andres/wingcut-fluidnc/docs/audit.md

# Audit record

This package went through two independent audits before publication. The v2 audit (6x + DM542T in one steel box, 28 findings) shaped the mechanics and safety design. The v3 audit below (24 findings) covers the 4x build. All findings were applied. The current v4 layout (steel power box + printed 24 V controller box, two controller variants) was audited again before publication; that record is at the end of this file.

**ID mapping:** the v3 findings below use the old part IDs. E1 → VA1, E2/E3 → PW1/PW2, E4/E5 → PW3/PW4, E6 → PW5, E7–E9 → PW6–PW8, E10 → PW9, E11 → PW10, E12 → PW11, E13 → PW12 (now the steel power box only), E15 → PW14, E16 → PW15/VA3, E17/E18 → CC2/CC3, E20 → PW16, E21 → CC4/CC5, E22 → CC6, FX10 → PW17.

**Correction:** finding #2 below estimated the board at ≈170 × 115 mm from a wiki image. Both FluidNC 4x and 6x boards are **125 × 85 mm**, verified from Bart Dring's EasyEDA layout ([enclosure/README](../enclosure/README.md)).

## v3 audit (01, 02, YAML, wingcut TOML, bom.csv)

*2026-11-05. I did not edit 01, 02, the YAML, the TOML or bom.csv. Anything that checked out is not listed.*

**Checked and fine:**
- **4x v1.1 board.** Terminal names (TB1/TB3/TB4/TB5 motors, TB7 power, TB10 = gpio.12 / VMot / gpio.4 / VMot), the i2so pins, UART gpio.26/2, the input pins and their Gnd terminals, and the StallGuard pad order (A/Z/Y/X) all match the wiki pinout image. Inputs have external pull-ups, so NC-to-Gnd needs no attribute. The MOSFETs are low-side with flyback diodes.
- **DC60.** Terminals 1(+)/2(−) load and 3(+)/4(−) control; control range 3.5–32 V (1500 Ω, so ≈16 mA at 24 V); load 3–60 V, 0.02–7 A; t_on 0.1 / t_off 0.3 ms; the datasheet does require a fast diode on inductive loads; input/output/base isolation is 4 kV. The freewheel diode orientation is correct.
- **Mean Well.** LRS-100/150F input 85–264 VAC with no selector; adjust ranges 21.6–28.8 V and 32.4–39.6 V; output isolated from FG.
- **Arithmetic.** The wire numbers (8.7 Ω/m, 12.6 Ω, I_full ≈ 2.70 A, S table, dummy-load currents, the tension/deflection check) are correct. The BOM sections sum to $896.
- **Config files.** Every wingcut TOML key exists in `config.rs` (deny_unknown_fields). The `limits` match FluidNC's soft ranges [0, 1000] and [mpos − max_travel, mpos], and the tram sign (`z mpos_mm = +d`) is right. The YAML keys exist in FluidNC v4.1.1 (`Axes.cpp`, `Homing.h`, `Motor.cpp`, `Spindle.cpp`). wingcut's Pause really does send `!` and then `0x9E` at `Hold:0` (`machine/src/controller.rs`).
- **v2 fixes that did not regress:** #1, #5–#9 (moot without K1), #11–#13, #15–#28. The ones that did regress are #2, #10 and the v2 antenna and lid-strap rows; see findings 3, 4 and 5.

| # | Sev | File / section | Problem | Concrete fix |
|---|---|---|---|---|
| 1 | **BLOCKER** | 01 §1 "Wire-off paths", E6, §3.1, §7; YAML (no `control:`); 02 note 2, (f)4 | **Releasing the E-stop can re-heat the wire and restart motion on its own.** The E-stop only cuts AC. The docs themselves say the ESP32 may stay alive on USB power. In that case FluidNC never learns about the E-stop: gpio.4 keeps its PWM and the planner keeps "moving" with dead motors, while wingcut keeps streaming. When the operator twists the E-stop out, VMot returns: the SSR turns on (wire hot) and the job continues. The drivers have also lost their UART settings (wrong microsteps and current, see 01 §7), so the towers move to wrong positions with a hot wire. "Press RESET after every E-stop" comes too late, because the hazard is the release itself. | Use a third NC contact on the E-stop as a FluidNC E-stop input. The specified XB5AS8442 already has 1 NC built in, so with the 2× ZBE102 you already have 3 NC; for an LA38/XB2 type, order a 3-NC version or add one contact block. Wire that NC between **input gpio.33 and its Gnd** (+100 nF), with CB7 in its own sleeve, not in the mains spiral. YAML, add: `control:` / `  estop_pin: gpio.33` (no attribute: closed = low = OK, pressed or a broken wire = active). In FluidNC v4.1.1 `estop_pin` gives a hard stop plus a critical alarm that only a soft reset clears, and with `off_on_alarm: true` it also switches the spindle (wire) off ([Control.cpp](https://github.com/bdring/FluidNC/blob/v4.1.1/FluidNC/src/Control.cpp)). wingcut sees the alarm and stops the job. In 01 §3.1, replace "Leave empty: inputs gpio.32/33" with the new row. **New test (01 6.3, 02 (e)3):** with the dummy load at `M3 S500` and a jog running, press the E-stop, then release it. Expected: 0 A stays, no motion, state `Alarm`, and nothing moves until RESET → `$MI` → `$H`. |
| 2 | **MAJOR** | 01 E13, §5.1 ("fits with ~20 mm margins") | **The parts don't fit a 360 × 260 plate.** I scaled the board from the wiki pinout image (5.08 mm motor terminals ≈ 190 px), which gives **≈170 × 115 mm**. The vertical stack is then 97 mm (PSUs) + ≈50 mm (DIN rail, terminals, fuse holders) + ≈115 mm (board) ≈ 262 mm. That already exceeds 260 mm with zero wiring gaps; you need ≥25 mm in front of the PSU and motor terminals. The same failure was v2 audit #2. | Change E13 to **steel enclosure 400 × 400 × 200 mm (or 500 × 400 × 200) with mounting plate ≈ 360 × 360**, ≈ $55–70, and update the csv, 2.9 and §0. In §5.1, drop "fits with ~20 mm margins" and put the 4x board's **input edge** toward the DIN rail, with ≥30 mm free in front of every terminal row. Measure the actual board before buying the box. |
| 3 | **MAJOR** | 01 §2.1, §3.1, §5.1 walls, §2.12; 02 (a)1, (a)4 | **The antenna is missing.** The wiki says: "You should only operate when the antenna is connected. A missing antenna can cause the device to overheat." The v1.1 module has a U.FL socket. In a steel box (E13 allows steel) an antenna inside gives no Wi-Fi, yet 02 (a)4 uploads the YAML over the WebUI, i.e. over Wi-Fi. v2 had an antenna bulkhead row; v3 dropped it (regression). | Add to §3.1: "**Antenna (U.FL)** → included bulkhead cable → SMA bulkhead in the top wall, antenna outside. Never power up without it." Add to §5.1 Walls: "SMA bulkhead (Ø6.5 mm hole) top wall". Add to the BOM: "E22 U.FL→SMA bulkhead pigtail + 2.4 GHz antenna (usually included with the board; else ≈$4)". In 02 (a)4 add a fallback: "No Wi-Fi? Upload the YAML over USB with the installer's file manager (installer.fluidnc.com → Files)." |
| 4 | **MAJOR** | 01 E15, §3.2 PE rows | **Not enough PE terminals (v2 #10 regressed).** PE conductors: inlet, PSU1 FG, PSU2 FG, plate, enclosure body, lid, frame bond, 4 motor shields and 4 limit shields = **15**. E15 has **4 PE terminals** (≈8 clamp points), so you would have to double up conductors under protective-earth clamps. | Change E15 to "**12-way PE busbar on the plate** (or 10 PE terminals) + 20 feed-through terminals". One PE conductor per clamp point. |
| 5 | **MAJOR** | 01 §3.2 ("PE → Enclosure (if metal) + plate"), CB8 | **There is no PE bond to a metal lid.** The lid carries mains (E-stop) and the meter loop. v2 had "lid (strap)"; v3 lost it. A chafed mains core on an unbonded steel lid makes the lid live. | Add the row "PE stud on body → **PE strap 1.5 mm² GN/YE to the lid stud**, serrated washers both ends" (most steel boxes include it; else +$2, CB8 + 2 ring lugs). Add "Inlet PE ↔ lid < 0.5 Ω" to test 6.1. |
| 6 | **MAJOR** | 01 §2.8 P1/P4, §4.4 step 13, §4.8 step 24 | **The belt tab, belt and drag chain fight for the same space.** P1's outboard edge is **110 mm** from the rail centre, but the belt plane is "10–15 mm outboard of the beam", i.e. **20–25 mm** from the rail centre. A 30×30 angle on P1's outboard edge cannot reach a belt ≈85 mm further in. The chain is also "fixed on the X-beam outer face, loop horizontal". A 10×20 chain lying horizontally is ≈28 mm tall and its loop ≈90 mm wide, so it sits exactly where the belt runs and the chord motor (on B1, beside the beam) stands. | Draw one full-size section through the X-beam and fix: (a) **P4 under P1 at the belt line** (≈20–25 mm outboard of the rail centre), hanging ≈20 mm to the top run, not "on P1's outboard edge". (b) **Chain outboard of the belt and motor:** fixed end on a standoff (e.g. 2× M5 + 30 mm spacers, or a 2020 offcut) ≥80 mm out from the beam face, with the moving end on P1's outboard edge (that is what P1's 110 mm is for). Add the standoff parts to the BOM. In §4.6, make the chord stop "P4 hits the pulley" rather than "the motor bracket". |
| 7 | **MAJOR** | 01 E13 ("ABS or steel"), §2.10 #2 (plywood box) | **Fire: mains PSUs, an SSR and a 100 W resistor in a combustible box,** right next to polystyrene. Plain ABS is not flame-retardant, and plywood is fuel. The saving is $20. | Change E13 to "**steel**, or plastic rated UL94 V-0". Delete §2.10 #2 and change the tight variant to ≈$835. |
| 8 | **MAJOR** | 02 (e)2, (f)6; 01 6.3 step 3 | **Some tests mean working inside a live box next to mains.** 02 (e)2 takes the lead off SSR 3(+) without saying "power off" (01 6.3 does say it). 02 (f)6 has you "pull the SSR 3(+) lead" during an air cut with the wire hot. 6.3 step 3 has you "pull a limit wire". | 02 (e)2: "**Power off**, lift SSR 3(+), insulate it, power on, `M3 S1000` → 0 A. Power off, reconnect." 02 (f)6, break test: "During the air cut, lower **V-set on the Riden front panel to 10 V**. The current falls to ≈0.8 A, below 50 % of 2.15 A, and wingcut must pause within ≈1 s and switch the output off." 6.3 step 3: "**press the limit switch by hand**" (it gives the same ALARM:1). |
| 9 | MINOR | 01 E10, §1 F3; bom.csv E10 | **F3 is an ATO blade fuse, and those are rated 32 VDC** ([Littelfuse 287 ATO](https://littelfuse.com/products/fuses/automotive-aftermarket-products/blade-fuses/ato.aspx)). It sits in a 36 V circuit (trim up to 39.6 V; up to ≈43 V on the Riden output). F2 (24 V) is fine. | F3 = **5×20 mm T4 A 250 V in an inline 5×20 holder** (≈$2; same spares as F1). Keep ATO only for F2. |
| 10 | MINOR | 01 E8, §1 F1 | **T2 A (230 V) / T4 A (115 V) is below the PSUs' combined rated input.** Typical full-load input is LRS-100 1.2 A/230 V and 1.9 A/115 V, plus LRS-150F 1.7 A/230 V and 3 A/115 V = **2.9 A / 4.9 A** ([LRS-100](https://www.meanwell.com/Upload/PDF/LRS-100/LRS-100-SPEC.PDF), [LRS-150F](https://www.meanwell.com/Upload/PDF/LRS-150F/LRS-150F-SPEC.PDF)). It holds at today's ≈60 % load but leaves no margin for the Riden option, a shorter wire, or two cold-start inrushes (50 A + 60 A typ) every time the E-stop is released. | **T3.15 A (230 V) / T6.3 A (115 V)**. Both are still below the 10 A inlet and the 1.0 mm² wiring. |
| 11 | MINOR | 02 notes 3–4; 01 §2.10 #5 | **02 notes 3–4 are left over from v2:** note 3 treats the DC60S3 as the fitted part (01 specifies the DC60S7), and note 4 says "meter not dark after M5 → E-stop". In v3 PSU2 is always on, so the meter is never dark. The check is "**0.00 A** after M5". Also, §2.10 #5 removes the meter in the tight version, and that removes the only idle indication of a shorted SSR (01 §7). | Note 3: "DC60S7 fitted: 2.7 A vs 7 A, heatsink still required." Note 4: "Meter not **0.00 A** within 1 s of M5 → E-stop, replace the SSR." In §2.10 #5, keep the $7 meter and drop only the dummy load (−$8). |
| 12 | MINOR | 01 §3.1 "VMot (9–30 V)" | The wiki gives TMC2209 **max 29 V** and recommends running 10–15 % below it, at 12–24 V. LRS-100-24 trims up to 28.8 V. | "VMot + / GND: **24.0 V; never above 26 V** (TMC2209 max 29 V)." Add to 6.2 step 1: "Do not touch PSU1's trim beyond 24.0 V." |
| 13 | MINOR | 01 §5.1, E14; YAML `run_amps: 1.2` | **The fan placement contradicts itself.** It is a wall fan "exhaust high" and must also "aim across the driver heatsinks" on a board in the bottom band. 1.2 A is exactly the wiki's "needs forced air" threshold, and the loads are < 1 N. | Mount the fan **on the plate on a bracket (or on the bottom wall) blowing onto the drivers**, with the vent grill high. Set `run_amps: 1.000` on all four axes; raise it only if (b)5 loses steps. |
| 14 | MINOR | 01 CB9, CB1 | **TRVVP 4×0.5 shielded is ≈6–6.5 mm OD,** and shielded PVC chain cable is rated at **7.5–10 × OD** moving ([IEWC](https://media.iewc.com/SpecificationSheets/32009503.pdf), [Helukabel](https://www.helukabel.com.vn/vn-en/meaning-of-bending-radius.html)), i.e. ≈48–65 mm. The chain is R38. | CB9: "**Drag chain 15×20 mm inner, R48 (or larger), openable, 1 m**". Check the seller's TRVVP bend radius. |
| 15 | MINOR | 01 E16, E21 | **The glands are short and the wrong size.** 12 M16 are needed exactly (11 field cables + USB), with no spare and no Riden USB. The single-core leads (CB3 silicone ≈2.6 mm, CB8 ≈3.2 mm) are below an M16's 4.5–10 mm clamp range, so they get no seal and no strain relief. The USB-A plug does not pass an M16 gland, and the "split grommet" is not in the BOM. | E16: "**8× M16 (4.5–10 mm)** for CB1/CB2, **4× M12 (3–6.5 mm)** for W-HR, W-HT, PE + spare, +2 spare M16". E21: "**USB-C panel-mount extension 0.3 m** (bulkhead) + the 2–3 m cable" (+$6). Riden option: + 1 USB bulkhead. |
| 16 | MINOR | 01 FR5, FR6 | **Brackets and T-nuts are short.** FR5 = 20, but 8 + 8 + 4 = 20 are used **plus 2 for P6**, so "from the spares" means zero spares. 2040 cast brackets take 4 T-nuts each: 22 × 4 = 88, plus motor and idler brackets 8, P5 4, chain ends 4, bonds and tie mounts ≈10 ≈ **114 > 100**. | FR5 → **24**, FR6 → **150**. |
| 17 | MINOR | 01 P6, §4.3 step 9 | **P6 "spare corner bracket" can't carry the KFL08 at 32–36 mm.** A 2040 cast bracket leg is ≈40 mm with a central rib exactly where the Ø8 screw must pass; the KFL08 flange reaches ≈48 mm from the post face. Step 9's "≈1 mm gap between the coupler and the bearing" is meaningless: they are ≈400 mm apart. | P6 = **6 mm plate 70 × 60 (same as P3)**, fixed with 2 corner brackets; ST2 → 6 plates. Step 9: "≈1 mm gap between the motor shaft end and the screw end inside the coupler". |
| 18 | MINOR | 01 §4.7 step 21, ST3/ST4 | **The bed fixing has no parts.** "Screw from below" through a 2040 isn't possible, and there are no brackets or wood screws in the BOM. ST3 (100 mm for 2× 50) and ST4 (120 mm for 4× 30) have no saw-kerf allowance. | Step 21: "8× **M5×25 countersunk DIN 7991** down through the bed into M5 T-nuts in C1/C2, heads 1 mm below the surface" (add to FX). ST3 → 120 mm, ST4 → 150 mm. |
| 19 | MINOR | 01 §2.6 / BOM (enclosure hardware) | **Enclosure hardware used in §5 is not in the BOM.** Fan screws (M4×35 + nuts, ×4); DIN-rail screws (×3); SSR→heatsink and heatsink→plate screws (M4 ×4); E12 dummy-load screws (M4 ×2); PE stud nuts + serrated washers; IEC inlet screws (if not snap-in). | Add **FX10: enclosure kit**: 4× M4×35, 10× M4×10, 14× M4 nuts, 6 serrated washers M4/M5 (≈$3). |
| 20 | MINOR | 01 §4.9 / 6.1 PE row, CB8, CB12 | **The PE test can't always be fixed the way it says.** "< 1 Ω to both P2, else add a CB8 jumper across that joint" won't work: P1 and P2 ride on linear-guide balls, and a static jumper can't cross a 1000 mm or 300 mm stroke. CB8 has only 4 lugs. | Change the text to: "Jumper each **rail ↔ extrusion** (static; M3 ring lug under a rail screw + serrated washer). If P1/P2 still read > 1 Ω, run a **0.5 mm² GN/YE flexible core** in each drag chain to P1, with a short loop to P2." Add 4 m of 0.5 mm² GN/YE and 10 M3 ring lugs to the BOM. |
| 21 | MINOR | 01 6.3, §5.1; 02 (e)1 | **The dummy-load hookup isn't described,** and the docs disagree on where it goes ("beside the SSR" in 01, "on the heatsink" in 02). The wire leads end at the heads, 3–5 m away, and there is no plug in the base build. At S1000, 22 Ω takes ≈55 W; on the ≤3 K/W SSR sink that would cook the SSR. | "Power off. Lift W-HR from wire+ and W-HT from SSR 1, insulate them. Connect E12 between **wire+ and SSR 1** with 2× 0.3 m 1.0 mm² orange + M4 ring lugs. E12 is screwed to the **plate**, not the SSR heatsink. S1000 ≤ 10 s, S500 ≤ 60 s." |
| 22 | MINOR | 01 §3.2 Riden row, §6.3, §7; 02 (e)5; TOML `[riden]` | **The Riden option is inconsistent.** §7 says `max_voltage` ≈ 45 V; 02 and the TOML say 36 V. The start current is 1.8–2.0 A in 01, 2.0–2.3 A in 02 and 2.15 in the TOML. "Output − → (meter removed) SSR loop return" is vague. The RD6006's power-on-output setting isn't mentioned (if ON, its output comes back on after an E-stop). The Riden USB cable and gland aren't in the BOM (R1–R4). | §7: "`max_voltage` = **36 V**". Use one range everywhere: "**start 2.0 A, tune 2.0–2.3 A**". 3.2: "RD6006 out + → F3 → wire+; **RD6006 out − → SSR 2 (−)**". 02 (e)5: "Riden menu: **power-on output OFF**". Add R5 "USB-A↔(RD6006 port) cable 1 m + USB bulkhead, ≈$6". |
| 23 | MINOR | 02 (b)3, (c)3; 01 6.2 step 4 / 6.3 step 4 | **Three procedure gaps.** (b)3 says "put `:low` on `direction_pin`, `$CD=…`" but never says how to change it. (c)3 measures the "wire-contact point" before any wire is strung (stringing is 4.9, after 6.3). 6.3 step 4 (wingcut Pause test) comes before 02 (f), where wingcut is set up. | (b)3: "`$/axes/x/motor0/tmc_2209/direction_pin=i2so.1:low`, then `$CD=fluidnc-4x-hotwire.yaml`, `$Bye`." (c)3: "the **bottom of each MIG-tip bore**". 6.3 step 4: "do this in 02 (f)3". |
| 24 | MINOR | 01 §0, §2.9, E6; README | **The cost is undercounted.** (1) E6 at $15 is realistic only for a generic LA38/XB2. A genuine **XB5AS8442 is ≈$68–92, plus ZBE102 ≈$12–16 each** ([Octopart](https://octopart.com/part/schneider-electric/XB5AS8442), [DigiKey ZBE102](https://www.digikey.co.uk/en/products/detail/schneider-electric/ZBE102/16614613)). (2) The README says ≈$885; 01 says $895/896. (3) The fixes above add ≈$50–70: bigger steel box, PE busbar, glands and USB bulkhead, brackets and T-nuts, enclosure hardware, R48 chain, 5×20 F3. (4) Shipping is excluded, but 1.9 m extrusions alone typically add $30–60 and a multi-seller order $80–150. | E6: "**generic 3-NC XB2/LA38, ≈$15**; genuine Schneider ≈$100". Restate the base as "**≈ $950 + shipping (≈ $1,030 with a genuine Schneider E-stop)**" in §0, 2.9, the csv and the README. The "Was ~$600 a miscalculation?" answer still holds: the gap is even larger. |

**Count: 1 BLOCKER · 7 MAJOR · 16 MINOR.**

Sources: [FluidNC 4x wiki](http://wiki.fluidnc.com/en/hardware/official/new-page/4x_CNC_with_esp32) (pinout `/hardware/4x_with_pinout.png`, 29 V max, 1.2 A forced-air limit, antenna warning, MOSFET section) · [FluidNC v4.1.1 Control.cpp](https://github.com/bdring/FluidNC/blob/v4.1.1/FluidNC/src/Control.cpp) (`estop_pin`) · [Crydom DC60](https://jinzon.url.tw/pdf/crydom_dc60.pdf) · [LRS-100](https://www.meanwell.com/Upload/PDF/LRS-100/LRS-100-SPEC.PDF) · [LRS-150F](https://www.meanwell.com/Upload/PDF/LRS-150F/LRS-150F-SPEC.PDF) · [Littelfuse ATO 287 (32 V)](https://littelfuse.com/products/fuses/automotive-aftermarket-products/blade-fuses/ato.aspx) · [Elecrow 4x listing](https://www.elecrow.com/4x-cnc-controller-integrated-esp32-and-tmc2209.html) (out of stock 2026-11-05) · wingcut `src/config.rs`, `machine/src/controller.rs`, `machine/src/riden.rs`.

---
**Status (parent, 2026-11-05):** all 24 findings applied to 01, 02, the YAML, the TOML, bom.csv and the README. Base cost restated as ≈ $958 + shipping.

---

## v4 audit (pre-publication, staged repo)

*2026-11-05. Independent review of `this repo` (README, docs/, config/, bom/bom.csv, enclosure/). I edited nothing. Things that checked out are not listed. A short list of what was checked is at the end.*

| # | Sev | File / section | Problem | Concrete fix |
|---|---|---|---|---|
| 1 | **MAJOR** | 01 §5.2 ("bolt … to B1 at the front-left"), §3.4; enclosure/README §2 "Mounting", §6.7; `enclosure_lib.scad` `rail_tab`; FR BOM | **The printed boxes can't be bolted to B1 as written.** Each box has one floor-level tab at the front and one at the back. Each tab has 2 M5 slots 20 mm apart along the box X axis. That only fits a 2040 **lying flat (40 mm face up) and running front-to-back under the box**. B1 is a 2040 **standing** (FR1: "40 tall"), so its top is the 20 mm face with **one** slot, and it runs **left-right**. No front-to-back flat 2040 exists anywhere in the frame or BOM. Variant B also needs ≈207 + 40 + 204 ≈ **451 mm** of rail for "case and rack on the same rail, one after the other". | Add a BOM line FR11: "2040 offcut, 250 mm (A) / 480 mm (B), lying flat, + 2 cast corner brackets + 4 T-nuts". Then either say where it bolts (see #2), or change `rail_tab` to a single slot centred on a 20 mm face. State the mounting rail in 01 §5.2 and enclosure §6.7 in one sentence each. |
| 2 | **MAJOR** | 01 §0 top view, §3.4 ("≈0.3 m from the root tower"), §4.7 step 23 | **The documented position puts the PETG box under the hot wire, with ≈9 mm clearance.** There is no room for a 206 mm box on B1 outboard of the root X-beam: the beam sits ≈160 mm from B1's end, and the chord motor bracket stands there. So "0.3 m from the root tower" means inboard, inside the wire span (\|W\| < 725 mm). The front of the chord travel (X0) is over B1. Heights: box top = B1 40 + 61 = **101 mm**. Lowest wire = bed 98 + `limits.y` min 12 = **110 mm**, and wingcut drops Y/A to entry height in front of the block first (wingcut README "Placement conventions"). The 4x lid fan also pulls air in through the lid grille, so it draws the wire's fumes and hot air straight into the electronics. | Mount both boxes **outside the wire span**: on the bench beside the power box, or on a bracket outboard of the root tower below bed height. Then update 3.4 lengths (W-MX/W-LX etc.) and CB1/CB2 metres. Add to 4.7 step 23: "lowest wire ≥ 30 mm above every box and gland over X 0–1000". |
| 3 | **MAJOR** | 01 §3.2 (B: "rack WAGO, then jumper to 6x VMot+"), §3.3B row 1 and shield row, §5.2 step 1; enclosure/README §3 rack table; `dm542t_rack.scad` `features`; VB5, VB7 | **Variant B: there is no way to get 24 V and the shield link from the rack to the 6x.** The rack has exactly 5× M16 (4 MOT + one "24V" for PB-24 *in*) and 4× M12 (SD X–A). The jumper pair to the 6x VMot has no exit. VB5 is also loose 1.0 mm² single cores, which don't seal in a 4.5–10 mm M16. The "0.5 mm² drain inside a step/dir cable (spare core…)" doesn't exist either: VB4 is 4-core and all 4 cores are used (STEP, DIR, EN, GND). | Add a 2nd M16 "24V OUT" to the rack back wall in `dm542t_rack.scad` (e.g. s = 25), add 1 M16 to VB7 (→ 21), and use 0.5 m of CB16 2×1.0 sheathed cable for the rack → 6x case "24V" gland (CB16 → 3.5 m). For the shield link, say explicitly: "use the shield of the SD X cable as the link: rack end on the rack shield WAGO, case end on the case WAGO". Drop "spare core". |
| 4 | **MAJOR** | CC9 (qty 3), 01 §3.2/§3.3A/§3.3B/§5.2 step 5, enclosure §6.5 | **Too few WAGO 221-415s, and each one takes only 5 conductors** ([WAGO 221-415](https://www.wago.com/global/pd/221-415)). **A:** the case has 4 motor + 4 limit + PB-SIG = 9 shield drains, but the docs say "a WAGO 221". **B:** case 4 limit + PB-SIG + rack link = 6. Rack motor shields 4 + link = 5. The rack's +24 V and 0 V buses each take PB-24 + 4 drivers + 6x feed + rack fan = 7. That makes ≈7 WAGOs for B, against 3 in the BOM (and CC9 doesn't list a rack shield WAGO at all). | CC9 → **A: 3**, **B: 7** (or split CC9 into VA/VB lines), ≈$1 each. In 3.3A/5.2 write "shield WAGOs (2–3, linked with a 0.5 mm² GN/YE jumper)". In 3.3B add "rack: 1 shield WAGO; +24 V and 0 V buses = 2 linked WAGOs each". Alternative: a 10-way earth bar for the drains. |
| 5 | **MAJOR** | PW5, 01 §8 "False E-stop alarms", 3.3A gpio.33 row | **Variant A: NC3 doesn't carry ≈12 mA.** That figure is the 6x opto input (YAML: 5 V → 300 Ω). The 4x inputs are plain inputs with external pull-ups, where "the switch should never put more than 5V on the terminal" ([4x wiki](http://wiki.fluidnc.com/en/hardware/official/new-page/4x_CNC_with_esp32)). So NC3 switches well under 1 mA. That is dry-circuit level, the same reason the BOM insists on gold D2F limits. A silver XB2/LA38 block will then give intermittent estop alarms, i.e. hard stops mid-cut on the recommended variant. | PW5: "NC3 **must** be a gold / low-level contact block for variant A (check the block's datasheet for ≤5 V/1 mA operation). Silver is acceptable only on B (≈12 mA opto)." Fix the "≈12 mA" text in PW5 and §8 to give the current per variant. |
| 6 | **MAJOR** | 01 §1, §3.1 ("0 V out … Never bonded to PE"), §3.2, §5.1, §6.1 | **The 24 V system floats, and one of its circuits is NC3, which sits in the same E-stop operator as the L and N contacts on the mains lid.** Generic 3-NC blocks give basic insulation between contact elements, not the protective separation SELV needs. After one insulation fault, the whole floating 24 V system, including the touchable metal USB-C bulkhead (CC4) and SMA shells on the printed case, could sit at mains potential with nothing to trip. The PB-SIG and PB-24 cores also run through the mains box, and the docs give no segregation rule for them. | Make the 24 V system **PELV**: one 1.0 mm² GN/YE from the **0 V out** terminal to the PE busbar, at the power box only. The USB isolator still breaks the PC ground loop, and PSU2 −V stays floating. Change §3.1 "Never bonded to PE" → "bonded to PE at this one point". Change 6.1: "0 V ↔ PE < 0.5 Ω; PSU2 −V ↔ 0 V/PE OL". Add to 5.1: "24 V/SIG cores run apart from mains cores and are tied to the low-voltage side; NC3 on its own contact block, furthest from NC1/NC2". |
| 7 | MINOR | CC8 (≈0.4 kg), §2.11 | **Filament is under-counted for B.** Solid volume from the STLs: 4x case 335 cm³ (≈0.40 kg PETG at 1.27 g/cm³, 3 mm walls at 4 perimeters ≈ solid). 6x case + rack = 742 cm³ (≈**0.9 kg**). | CC8: "A 0.5 kg, B 1 kg (one spool)". Move the B part into VB (+≈$8). Update the B total (≈ $1,110). |
| 8 | MINOR | 01 §0 cost table, §2.4 ("Riden option +≈$82"); bom.csv R1–R5 | The csv nets **+$75** (65 + 12 + 0 + 5 − 7). 01 says +82 while also saying "drop PW10". The RD6006 also has **no mounting place**: there's no lid cut-out or plate position in 5.1. The R4 gland can't pass a USB-A plug (≈16 mm overmould > M16 bore). | Write "+$75 net (+$82 before dropping PW10)". Add to 5.1: "Riden option: RD6006 in a lid cut-out (≈ its front-panel size; check the module's drawing)". R4: "pass the device end in from outside, or use a split USB grommet". |
| 9 | MINOR | 01 §1 ("variant A on USB power"), §6.3 step 4 (A expected result), 02 note 2 and (f)4 vs CC1 and §8 ("isolated USB port can't power it") | **The docs contradict each other on whether the 4x survives an E-stop on USB.** With the ADuM3160 in place, the board may stay alive (if the isolator's iso-5 V carries the ESP32), brown out, or reboot. 6.3 step 4 accepts only "state Alarm". 02 (f)4 isn't marked as A-only. | In 6.3 step 4 and 02 (f)4, accept both results for A: "Alarm (estop) **or** new banner + ALARM:14; in both cases RESET → `$MI` → `$H`". Change §1 to "if the board stays alive (some isolators can carry the ESP32)". Mark (f)4 "A; for B see 02b". |
| 10 | MINOR | README Build order steps 6–9; 01 §6.2 step 3, §6.3; 02 (e)1–4, (e)6, (f) | **The order sends a first-time builder through all of 02 at step 6.** That includes (e)4 (needs the strung wire, README step 8), (e)6 kerf and (f) (need wingcut, step 9). It also runs the dummy-load tests twice, with different instructions: 01 6.3 step 2 lifts PB-SIG core 2 at SSR 4, while 02 (e)2 lifts SSR 3(+). 01 gives S200 ≈ 0.33 A, 02 gives 0.31 A. | README step 6: "02 (a)–(d) (B: also 02b)". Step 7: "01 §6.3 (= 02 (e)1–3)". After step 9: "02 (e)4–6 and (f)". Replace 02 (e)1–3 with "see 01 §6.3" so only one version exists. |
| 11 | MINOR | docs/audit.md intro; README "Status"; enclosure/README §1 ("The earlier estimate in 01/03") | audit.md says the v4 layout "was audited again; see the end of this file", but there is no v4 section. Its findings also cite IDs that no longer exist (E6, E10, E13, E15, E16, E21, FX10). "01/03" points to a document not in the repo. | Append the v4 audit (this file) or delete that sentence. Add one line: "IDs below are v3 IDs (E13 → PW12, E15 → PW14, …)". Change "01/03" → "earlier drafts". |
| 12 | MINOR | enclosure/README §3 4x table SIG row; VA3; VB7; 01 §3.2 PB-SIG | **The SIG cable spec disagrees.** The enclosure README says "4 × 0.25 shielded, ≈5 mm OD", needing a 3–6.5 mm insert. PB-SIG is actually CB1 TRVVP 4×0.5 shielded, ≈6–6.5 mm OD (audit v3 #14). That is at the very top of a 3–6.5 insert, while a standard 4.5–10 M16 (as PW15 uses at the power-box end) fits it. | Enclosure §3, VA3, VB7: "SIG = CB1 4×0.5 shielded (≈6.5 mm), standard M16 4.5–10". Drop the reduced insert (or keep it only for a thinner cable). |
| 13 | MINOR | PW15 (3× M12 3–6.5 for W-HR, W-HT, PE) | 1.0 mm² (18 AWG) silicone single core is typically ≈2.3–2.6 mm OD, below the 3 mm minimum of a 3–6.5 M12. W-HR and W-HT get no seal and no strain relief, and they are the leads that get pulled by the moving towers. | PW15: "2× M12 **2–5 mm** (W-HR, W-HT) + 1× M12 3–6.5 (PE)", or "sleeve each lead with 10 cm of adhesive heat-shrink at the gland". |
| 14 | MINOR | CB16 ("H05VV-F or silicone pair", "+ red/brown, − black/blue"); 01 §6.2 step 0 ("red (+) to black (−)") | H05VV-F 2-core is **brown/blue**, but the polarity check, the one step that protects the unprotected boards, is written in red/black. Also a mains-type grey cable carrying 24 V is easy to confuse with mains in the power box. | 6.2 step 0: "+24.0 V on the core landed on **+24 V out** (brown if H05VV-F)". Better: specify red/black 2×1.0 PVC/silicone DC cable for CB16 and label both ends "24 V DC". |
| 15 | MINOR | CB8 (1.5 mm² GN/YE 3 m) | The PE run alone is "2–3 m" (3.4), plus the lid strap ≈0.3 m, plus the static frame jumpers (B1↔B2↔X-beams↔posts, 6.1). 3 m is short. | CB8: 1.5 mm² **5 m**. State which size the static frame jumpers use (1.5 mm²). |
| 16 | MINOR | CC1/CC5 | "Boxed inline type with USB-A in/out" plus "short USB-A cable PC ↔ isolator" implies a USB-A male–male cable if the input is a female socket. That is non-standard and commonly a charge-only part. | CC1: "USB-B or USB-A **male** upstream, USB-A female downstream", and match CC5 to it ("USB-A↔USB-B 0.5 m"). |
| 17 | MINOR | `config/fluidnc-4x-hotwire.yaml` header line 22; `controller_case_6x.scad` SIG comment; YAML `name`/`meta` "GUAV v3"; TOML header | **Stale comments.** The 4x YAML lists "Spare: inputs gpio.32, **gpio.33**", but gpio.33 is now `estop_pin`. The 6x scad says "E-stop NC3 (**io.33**)", but it is io.39 (io.33 is the X limit). The TOML calls itself "(FluidNC 4x board + on-board TMC2209)", but it serves both variants. | Fix the three comments. Rename to "v4" or drop the version. TOML: "FluidNC 4x or 6x; same file for both variants". |
| 18 | MINOR | VB2 ("20–50 VDC") vs 02b ("18–50 V range") | The DM542T V4.0 manual says **18–50 VDC** ([manual](https://forum.duet3d.com/assets/uploads/files/1684504031141-dm542t_v4.0.pdf), §6.2). | VB2: "18–50 VDC". |

**Count: 0 BLOCKER · 6 MAJOR · 12 MINOR.**

## Checked and fine (not findings)
- **Cost:** csv line sums are PW 223, CC 60, VA 60, VB 186, CB 129, FR 174, M/L/D 201, H 48, FX 45, ST 36. A = **976**, B = **1102**, which matches 01 §0/§2.11 and the README (≈980 / ≈1,100; B − A = 126 ≈ "−$125"). EUR × 0.92 matches. Tighter −45 and Schneider +85 add up.
- **Links:** every relative link in every .md and in bom.csv resolves inside the repo. All 12 PNGs and 6 STLs exist. The STL bounding boxes match the README sizes (207 × 207 × 58 case base, 176 × 204 × 125 rack). Every part fits a 220 bed.
- **Gland counts vs scad:** 4x case 8+1+1 M16 (VA3 10 + 2 spare). 6x case 6 M16 + 4 M12. Rack 5 M16 + 4 M12 (VB7 = 20). Power box 2 M16 + 3 M12 + 2 spare. Walls (motor/DRV front, LIM back, 24V/SIG right, USB/ANT left) and labels match enclosure README §2. Fan sizes (4x 80, 6x 60, rack 80 optional) and insert counts (10/10/12) match CC7/VA2/VB3.
- **Pins:** 01 §3.3A/B, 02, 02b and both YAMLs agree (4x limits 36/39/34/35, estop gpio.33, PWM gpio.4. 6x limits 33/32/35/34, estop gpio.39, PWM gpio.4). `estop_pin` exists in FluidNC v4.1.1 and behaves like `fault_pin`: a hard stop and a critical alarm that only a soft reset clears ([Control.cpp](https://raw.githubusercontent.com/bdring/FluidNC/v4.1.1/FluidNC/src/Control.cpp)). The 6x can't run from USB and needs VMot for the CP2102 ([6x wiki](http://wiki.fluidnc.com/en/hardware/official/6x_CNC_Controller)), so the "6x reboots on E-stop" text is right.
- **DM542T:** S2 ships at 24 V and must be set to 5 V; ENA 4.5–24 V = disabled; PUL ≥ 2.5 µs; enable ≥ 200 ms; SW1–3 ON-OFF-ON = 1.91 A; SW5–8 ON-ON-OFF-ON = 3200; no daisy-chained supply (own pair per driver). All match the manual.
- **Wire circuit:** it floats. Polarity (wire+ → W-HR, W-HT → SSR 1+, SSR 2− → shunt → PSU2 −V), diode orientation, F3 5×20 T4 A, F2/F1 values, Riden rewiring and the 6.1 OL tests are consistent.
- **wingcut hook-up (01 §7, 02 (f)):** every TOML key exists in `src/config.rs` (deny_unknown_fields) and passes `validate()` ranges. Repo URL, `scripts/try-local.sh`, dialout, DTR-low connect (`machine/src/link.rs`), `0x9E` spindle stop (`machine/src/grbl.rs`), "Homed" detection, Riden fields and the Pause/STOP/USB-unplug tests all match wingcut's README and `docs/hardware-bringup.md`. No findings here.

**Status:** all 18 findings applied before the first push (boxes moved off the frame onto a bench mounting rail FR11, rack "OUT" gland added and re-rendered, WAGO counts, gold NC3, PELV bond, filament, Riden net cost, test de-duplication, SIG gland, M12 2–5 mm, red/black CB16, CB8 5 m, isolator connectors, stale comments, DM542T 18–50 V).
