andres/wingcut-fluidnc/enclosure/png/case4x_base.png

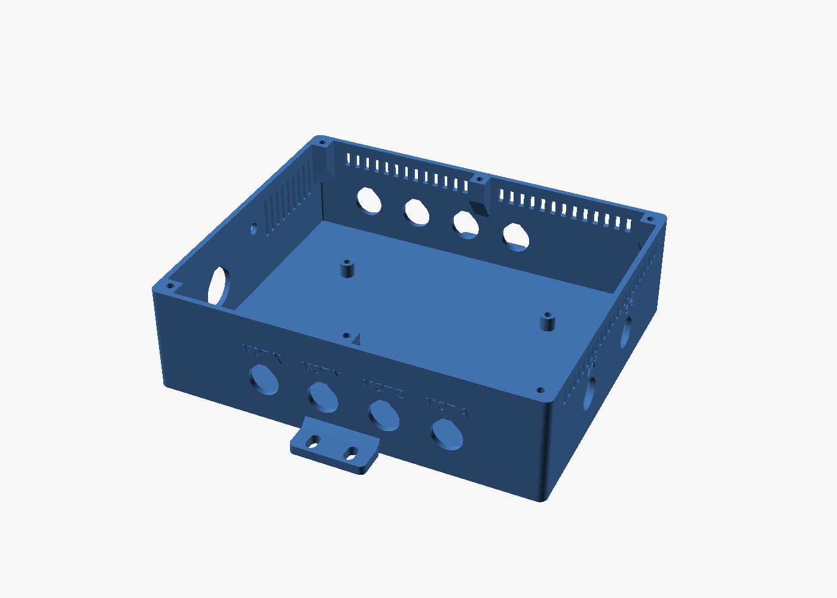
enclosure/png/case4x_base.png
