andres/wingcut-fluidnc/enclosure/png/case4x_lid.png

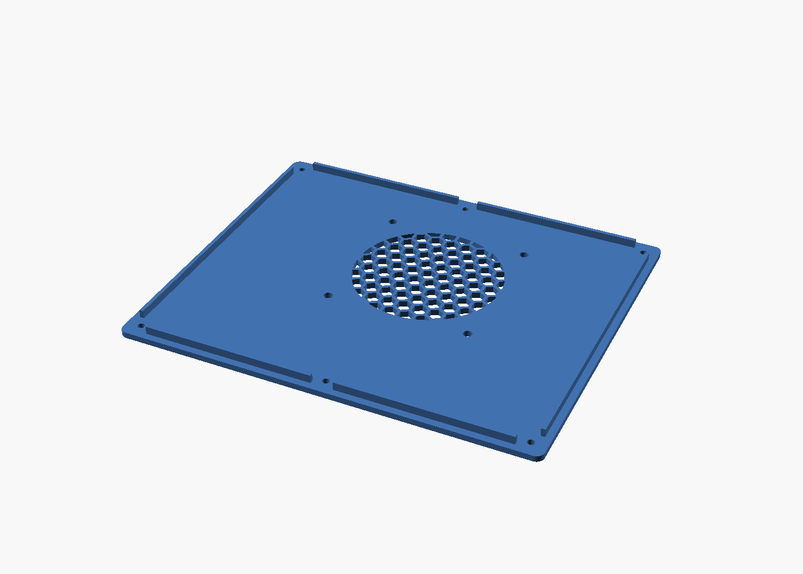
enclosure/png/case4x_lid.png
