andres/wingcut-fluidnc/enclosure/png/rack_base.png

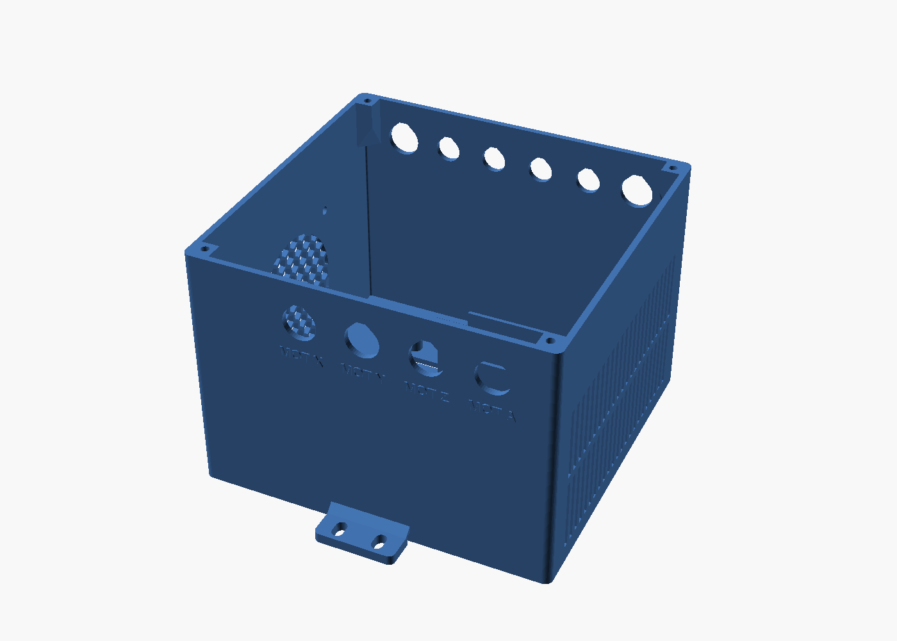
enclosure/png/rack_base.png
