andres/wingcut-fluidnc/enclosure/png/rack_cover.png

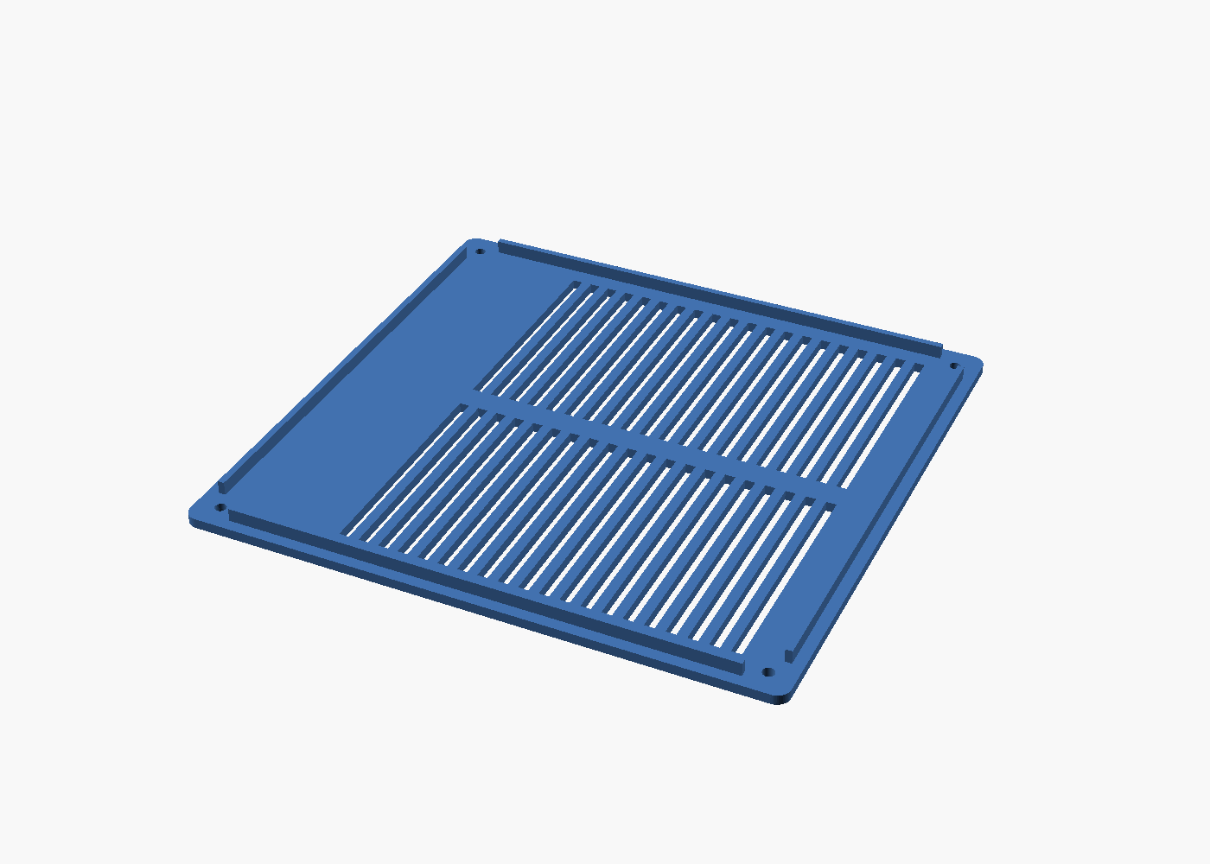
enclosure/png/rack_cover.png
