andres/wingcut-fluidnc/bom/bom.csv

variant | section | id | qty | part | spec_notes | approx_usd_line | recommended_pick | recommended_usd | quality_vendor | quality_part | quality_url | quality_usd | budget_vendor | budget_part | budget_url | budget_usd | buy_notes
A+B | Power box: mains, wire power, safety (PW), both variants | PW1 | 1 | PSU1: Mean Well LRS-100-24 | 24 V 4.5 A, universal input. [Spec](https://www.meanwell.com/Upload/PDF/LRS-100/LRS-100-SPEC.PDF). Variant B real load ≈3 A, still fine. | 20 | Q | 16.48 | TRC Electronics (Mean Well distributor) | Mean Well LRS-100-24 | https://www.trcelectronics.com/products/mean-well-lrs-100-24 | 16.48 | Jameco Electronics | Mean Well LRS-100-24 (Jameco #2257694) | https://www.jameco.com/z/LRS-100-24-MEAN-WELL-100-Watt-24V-Single-Output-Enclosed-Power-Supply_2257694.html | 15.00 | TRC: 236 in stock, tariff included. Jameco is behind Cloudflare, so price/stock come from search snippets only. Alternative: Amazon MEAN WELL Store (sold by MEAN WELL POWER SUPPLY) https://www.amazon.com/dp/B071JLNB9R $19.99, page-verified. Digi-Key shows LRS-100-24 as no longer available. Mean Well is heavily cloned: buy from distributors or the official store only.
A+B | Power box: mains, wire power, safety (PW), both variants | PW2 | 1 | PSU2 (wire): Mean Well LRS-150F-48 | 48 V 3.3 A, universal input, feeds the Riden (RD6006 input ≤ 70 V; gives ≈ 43 V max out). [Spec](https://www.meanwell.com/Upload/PDF/LRS-150F/LRS-150F-SPEC.PDF). Not the non-F LRS-150 (selector switch). | 27 | Q | 25.51 | TRC Electronics | Mean Well LRS-150F-48 | https://www.trcelectronics.com/products/mean-well-lrs-150f-48 | 25.51 |  |  |  |  | Genuine Mean Well only (authorised distributor). Feeds the Riden.
A+B | Power box: mains, wire power, safety (PW), both variants | PW3 | 1 | Isolated DC SSR: Sensata/Crydom DC60S7 (or DC60S5) | Control 3.5–32 VDC (3+/4−); load 3–60 VDC 7 A (1+/2−); t_on 0.1 / t_off 0.3 ms, so 100 Hz PWM is fine. Not the DC60S3 (no margin at 2.7 A). No no-name "SSR-xxDD". [RS](https://uk.rs-online.com/web/p/solid-state-relays/7360882) | 50 | Q | 54.16 | Digi-Key | Sensata/Crydom DC60S7 (CC1128-ND) | https://www.digikey.com/en/products/detail/sensata-crydom/DC60S7/221846 | 54.16 | Amazon (seller Online Components) | Crydom DC60S7 | https://www.amazon.com/dp/B00DJUH128 | 83.94 | No cheaper genuine source found. Digi-Key has the lowest genuine price (554 in stock). Mouser 558-DC60S7 is about $51 per an aggregator, but I could not verify it (Mouser blocks fetching). Amazon B00DJUGZN4 at $35.88 is a DC60S3, which the BOM forbids. Do NOT buy no-name 'SSR-xxDD' or Fotek clones: very fake-prone.
A+B | Power box: mains, wire power, safety (PW), both variants | PW4 | 1 | SSR heatsink ≤3 K/W + thermal pad | ≈2–3 W | 4 | B | 5.99 | Digi-Key | Crydom HS301 heatsink 3.0 °C/W + Crydom HSP-1 thermal pad | https://www.digikey.com/en/products/detail/sensata-crydom/HS301/2122802 | 35.25 | Amazon (Easycargo store) | Easycargo SSR heatsink 80×50×50 mm | https://www.amazon.com/dp/B07B3Y2ZNY | 5.99 | Quality total = HS301 $32.29 (14 in stock) + HSP-1 $2.96 https://www.digikey.com/en/products/detail/sensata-crydom/HSP-1/2596427. Budget heatsink has no K/W rating; it is the same size as the HS301 (81×45×40 mm), so expect roughly 2.5–3.5 K/W. Add thermal paste or an HSP-1 pad (+$2.96).
A+B | Power box: mains, wire power, safety (PW), both variants | PW5 | 1 | E-stop 22 mm mushroom, latching twist-release, 3 NC (NC1 L, NC2 N, NC3 FluidNC), ≥10 A/250 VAC, finger-safe | Generic XB2/LA38 3-NC ≈ $15. Genuine Schneider XB5AS8442 (1 NC built in) + 2× ZBE102 ≈ $100. NC3 must be a gold-plated / low-level contact block (datasheet min. load ≤ 5 V / 1 mA), e.g. Schneider ZBE1026 (gold-flashed). On variant A it switches < 1 mA (plain pull-up input), and silver contacts give random E-stops mid-cut. On B (≈12 mA opto input) silver is acceptable, but gold is still better. | 25 | Q | 127.67 | Digi-Key | Schneider XB5AS8442 + ZBE102 (NC, N) + ZBE1026 (NC, gold-flashed, for NC3) | https://www.digikey.com/en/products/detail/schneider-electric/XB5AS8442/17179244 | 127.67 | Amazon (genuine Schneider via 3rd-party sellers) | Schneider XB5AS8442 (Industry4u) + ZBE102 (clockwerk) + ZBE1026 | https://www.amazon.com/dp/B07JFN2LJW | 64.93 | Quality = XB5AS8442 $91.51 + ZBE102 $12.05 https://www.digikey.com/en/products/detail/schneider-electric/ZBE102/16614613 + ZBE1026 $24.11 https://www.digikey.com/en/products/detail/schneider-electric/ZBE1026/16613570. Budget = XB5AS8442 $31.83 + ZBE102 https://www.amazon.com/dp/B0018L54DS $8.99 + ZBE1026 (Amazon https://www.amazon.com/dp/B0028YLZSC $25.74 is temporarily out of stock, so buy it from Digi-Key at $24.11). ZBE1026 = Ag/Ni/Au gold-flashed 'low power switching' contact; ZBE blocks are Ith 10 A. Generic XB2/LA38 3-NC stops (≈$10) only have silver contacts and fail the NC3 gold requirement for variant A.
A+B | Power box: mains, wire power, safety (PW), both variants | PW6 | 1 | IEC C14 inlet with switch + 5×20 fuse holder |  | 5 | B | 11.99 | Digi-Key | Schurter DD11.0111.1111 (C14 + 2-pole switch + 5×20 fuse holder) | https://www.digikey.com/en/products/detail/schurter-inc/DD11-0111-1111/1646862 | 16.04 | Amazon (Antrader store) | Antrader IEC C14 inlet with switch + fuse holder, 2 pcs | https://www.amazon.com/dp/B081VD1NNT | 11.99 | Digi-Key: 135 in stock. Budget unit is generic, unlisted (no UL/VDE): check the fuse drawer takes 5×20 mm and that its rating is 10 A/250 V.
A+B | Power box: mains, wire power, safety (PW), both variants | PW7 | 5 | F1 mains fuses 5×20 slow-blow | T3.15 A (230 V) / T6.3 A (115 V) | 3 | Q | 4.00 | Digi-Key | Schurter 0034.3125 T6.3A 250 V 5×20 slow-blow ×5 | https://www.digikey.com/en/products/detail/schurter-inc/0034-3125/639703 | 4.00 | Amazon (BOJACK) | BOJACK T6.3AL250V 5×20 slow-blow, 20 pack | https://www.amazon.com/dp/B07X1KD6WS | 6.99 | Picked T6.3 A because the build is in the US (115 V). For 230 V use T3.15 A (Schurter 0034.3120 range). Digi-Key: $0.80 ea, 28,106 in stock. The BOJACK pack costs more for 5 pcs but gives 20.
A+B | Power box: mains, wire power, safety (PW), both variants | PW8 | 1 | IEC C13 mains cord, local plug |  | 5 | B | 7.99 | Amazon (sold by Amazon.com) | StarTech PXT101 NEMA 5-15P to C13, 6 ft, 18 AWG, UL | https://www.amazon.com/dp/B000067SLV | 8.92 | Amazon (sold by Amazon.com) | Monoprice NEMA 5-15P to C13, 8 ft, 16 AWG | https://www.amazon.com/dp/B07BBTBNR7 | 7.99 | Both brands are reputable. The Tripp Lite P006-006 (B008C4FRSQ) is $15.84 from a third-party seller, so it was not picked.
A+B | Power box: mains, wire power, safety (PW), both variants | PW9 | 2 | F2: inline ATO holder + 5 A fuses (24 V). F3: inline 5×20 holder + T4 A 250 V fuses (wire; ATO blades are only 32 V rated). 3 spares each. |  | 6 | Q | 16.29 | Digi-Key | F2: Littelfuse FHAC0001ZXJ ATO inline holder + 4× 0287005.PXCN 5 A; F3: Littelfuse 01500274Z 5×20 inline holder + 4× Schurter 0034.3123 T4A | https://www.digikey.com/en/products/detail/littelfuse-inc/01500274Z/29453 | 16.29 | Amazon (Wave One Marine / DIGITEN / BOJACK) | 10× ATO inline holders with 5 A fuses + 10× 5×20 inline holders + T4AL250V 20 pack | https://www.amazon.com/dp/B09F1VQPFC | 23.97 | Quality = FHAC0001ZXJ $7.37 https://www.digikey.com/en/products/detail/littelfuse-commercial-vehicle-products/FHAC0001ZXJ/2004062 + 4×$0.44 https://www.digikey.com/en/products/detail/littelfuse-inc/0287005-PXCN/2519811 + 01500274Z $4.00 (10 A/350 V) + 4×$0.79 https://www.digikey.com/en/products/detail/schurter-inc/0034-3123/639683. Budget = B09F1VQPFC $9.99 + DIGITEN https://www.amazon.com/dp/B00VLBAF84 $6.99 + BOJACK T4A https://www.amazon.com/dp/B07X3N43CH $6.99. The budget is dearer because of pack sizes. Generic automotive 5×20 holders often have no voltage rating; check them against 36 VDC.
A+B | Power box: mains, wire power, safety (PW), both variants | PW10 | 1 | DC panel meter V/A, self-powered from the measured line: PZEM-031 type (6.5–100 V, built-in 20 A shunt, 0.01 A resolution) | Independent of the Riden: must read 0.00 A after M5 (shorted-SSR check). | Wire current. Must read **0.00 A** after M5, which is the shorted-SSR check. Never power it from 24 V. | Q | 14.99 | Amazon (HiLetgo store) | HiLetgo DC 6.5–100 V 0–20 A LCD V/A meter, built-in shunt (PZEM-031 type) | https://www.amazon.com/dp/B079JVGRSL | 14.99 | AliExpress | PZEM-031 20 A built-in shunt, DC 8–100 V, self-powered | https://www.aliexpress.us/item/3256809999186422.html | 6.54 | Spec deviation: no self-powered internal-shunt meter with a 10 A range was found. The cheap 0.28" 100 V/10 A dual meters need a separate 4.5–30 V supply, which breaks the 'self-powered from the ≥40 V line, never from 24 V' rule. The PZEM-031 type is powered from the measured line (6.5/8–100 V) and has a 20 A internal shunt with 0.01 A resolution, so it can show 0.00 A. AliExpress price is a variant/new-buyer price from search results (item page is behind a CAPTCHA). Can be dropped with the Riden option (R5).
A+B | Power box: mains, wire power, safety (PW), both variants | PW11 | 1 | Dummy load 22 Ω 100 W aluminium-clad | Wire-circuit tests (6.3); screwed to the plate | 8 | B | 0.82 | Digi-Key | TE Connectivity (CGS) HSC10022RJ 22 Ω 5% 100 W aluminium-clad | https://www.digikey.com/en/products/detail/te-connectivity-passive-product/HSC10022RJ/1149656 | 18.82 | AliExpress | RX24 100 W aluminium shell wirewound resistor, 22R option | https://www.aliexpress.us/item/3256806980591158.html | 0.82 | Digi-Key: 1,454 in stock. 100 W only applies when mounted on a heatsink; on the mounting plate it is fine for the short §6.3 tests (≤60 s at S500). Budget: pick the 22R variant. Price is from search results and varies by variant; add shipping.
A+B | Power box: mains, wire power, safety (PW), both variants | PW12 | 1 | Steel enclosure ≈ 400 × 300 × 150 mm with mounting plate ≈ 360 × 260, PE studs on body + lid | PSUs 308 × 97 + DIN band + SSR row fit. Lay it out first. | 40 | B | 45.99 | Amazon (VEVOR store, ships from Amazon) | VEVOR 16×12×6 in (406×305×152 mm) carbon-steel hinged enclosure with mounting plate | https://www.amazon.com/dp/B09247D9LH | 53.62 | Amazon (QLYYOPSK, sold by Imperial Palace USA) | 16×12×6 in steel enclosure with DIN rail and mounting plate | https://www.amazon.com/dp/B0DKXNGV5Y | 45.99 | I could not page-verify a branded (Hammond 1418/Saginaw SCE-16H1206LP/nVent Hoffman) 16×12×6 box with a panel: distributors blocked fetching or need a quote. Amazon Hammond/Hoffman are 16×14×6 at $346–379. Neither pick is UL-listed: check the plate size (≈360×260), add PE studs on body and lid if missing, and earth-bond the door.
A+B | Power box: mains, wire power, safety (PW), both variants | PW13 | 2 | Vent grills / louvres | Low intake, high exhaust (PSUs are convection-cooled) | 4 | B | 14.70 | Amazon (nVent Hoffman, seller Megamart USA) | Hoffman AVK44 louver plate kit 5.62×5.50 in, steel ×2 | https://www.amazon.com/dp/B07DMS5W2M | 124.54 | Amazon (Raneped, sold by Otto-Pro) | Round aluminium louvre 2 in with insect screen, 6 pack | https://www.amazon.com/dp/B0FCM6Y7DP | 14.70 | Quality = 2× $62.27. Budget: drill 2 in holes and fit 2–3 low and 2–3 high. With the screen there is no finger access to live parts. Price gap is huge; the budget louvres are perfectly fine for convection.
A+B | Power box: mains, wire power, safety (PW), both variants | PW14 | 1 set | DIN rail 35 × 300 + 14 feed-through terminals 2.5 mm² + 12-way PE busbar + jumpers + end stops + markers | Buses L, N, +24 V out, 0 V, wire+; one PE conductor per clamp | 20 | B | 21.08 | Amazon (International Connector store) | Dinkle UL DIN terminal kit: 20× DK2.5N + DK2.5N-PE ground blocks + DSS2.5N jumpers + end covers + end brackets | https://www.amazon.com/dp/B07NVVP9X7 | 28.99 | Amazon (Erayco) + AliExpress | Erayco UK2.5B kit (20 terminals, ground blocks, jumpers, end covers/brackets) + 12-way DIN neutral/ground bar | https://www.amazon.com/dp/B0BX2SDSQC | 21.08 | Quality uses Dinkle PE blocks with jumpers as the PE bus. If you want a true 12-way bar, add one. Check that each kit includes a 35 mm rail ≥300 mm; if not, add one (~$5). Budget = Erayco $19.99 + AliExpress 12-hole 6×9 ground bar https://www.aliexpress.us/item/3256805594251310.html (~$1.09 search price). Neither kit includes markers: add a marker strip or label tape.
A+B | Power box: mains, wire power, safety (PW), both variants | PW15 | 7 | Cable glands: 2× M16 (4.5–10 mm) for PB-24 and PB-SIG, 2× M12 (2–5 mm) for W-HR and W-HT (or sleeve the leads with adhesive heat-shrink), 1× M12 (3–6.5 mm) for PE, 2 spare |  | 4 | B | 13.50 | Digi-Key | LAPP 3× S2509 M16 4–10 mm + 3× S1607 M12 2–5 mm + 1× S2507 M12 3.5–7 mm (all with locknut) | https://www.digikey.com/en/products/detail/lapp/S2509/11200370 | 19.93 | Amazon (ToolRise) | ToolRise metric nylon gland kit M12/M16/M20/M25/M32, 3–21 mm | https://www.amazon.com/dp/B0F387JHTM | 13.50 | Quality = 3×$2.80 + 3×$3.03 (https://www.digikey.com/en/products/detail/lapp/S1607/11200246, 333 in stock) + 1×$2.44 (S2507, 869 in stock). The 7 pcs include 1 spare M16 and 1 spare M12 2–5. The M12 for PE is 3.5–7 mm, not 3–6.5: check your PE cable is ≥3.5 mm OD. Budget kit clamp ranges per size are not stated per piece; check that the M12 seals grip 2–5 mm leads.
A+B | Power box: mains, wire power, safety (PW), both variants | PW16 | 2 | Freewheel diode UF5404 (3 A 400 V) | 1 + spare | 1 | Q | 2.98 | Digi-Key | Vishay UF5404-E3/54 ×2 | https://www.digikey.com/en/products/detail/vishay-general-semiconductor-diodes-division/UF5404-E3-54/2217932 | 2.98 | Amazon (Chanzon) | Chanzon UF5404 3 A 400 V, 20 pack | https://www.amazon.com/dp/B079KDYNKT | 6.98 | Digi-Key: 5,555 in stock (cut tape $1.49 ea). The budget pack is dearer but gives 20.
A+B | Power box: mains, wire power, safety (PW), both variants | PW17 | 1 kit | Enclosure hardware: 10× M4×10, 14× M4 nuts, 6 serrated washers M4/M5, 8× M3×5 for the PSUs (max 4 mm into the PSU) | DIN rail, SSR/heatsink, dummy load, PE studs, PSUs | 4 | B | 9.99 | Amazon (Mywish store) | Mywish 1290 pc 304 SS M2–M5 kit (button/socket head screws, nuts, washers) | https://www.amazon.com/dp/B0CQWYFTXC | 17.99 | Amazon (SVLING) | SVLING 537 pc 304 SS M3–M6 Phillips pan-head screws/nuts/washers | https://www.amazon.com/dp/B0GSDRXGHR | 9.99 | Neither kit includes serrated (external-tooth) M4/M5 washers: add them from a hardware store or Bolt Depot (bot-blocked, not linked). Check the kit has M3×5. If not, use M3×6 plus a washer to stay ≤4 mm inside the PSU.
A+B | Power box: mains, wire power, safety (PW), both variants | PW18 | 1 | Riden RD6006 (USB version; RD6006W is fine) | 0–60 V / 0–6 A buck module, constant current, Modbus over USB. Standard: wingcut sets the current and voltage limit, reads V/A, pauses on a broken wire. Mount it in a power-box lid cut-out (check the module's drawing). Menu: USB, 115200, address 1, power-on output OFF. | 65 | Q | 94.00 | Amazon (RuiDeng Official Store) | Riden RD6006W (USB + WiFi), 60 V 6 A module | https://www.amazon.com/dp/B09B9KJ39R | 94.00 | AliExpress | RD RIDEN RD6006 60 V module (choose module-only/USB variant) | https://www.aliexpress.us/item/3256806709143589.html | 91.60 | The US-sold unit is the W version (USB + WiFi), a superset of the USB-only RD6006. Only 4 left. AliExpress price is a search-result variant price that may include a PSU; check the variant. Both need the R3 48 V supply as DC input. BOM estimate ($65) is low for 2026 US prices.
A+B | Power box: mains, wire power, safety (PW), both variants | PW19 | 1 | Second ADuM3160 USB isolator (same type as CC1) | Riden USB → PC. Its USB ground may be tied to its output negative, so it never goes to the PC directly. | 12 | Q | 16.99 | Amazon (DSD TECH Direct) | DSD TECH SH-G01A USB isolator, ADuM3160, 1.5 kV, enclosed (second unit) | https://www.amazon.com/dp/B093LKN3YH | 16.99 | Amazon (EC Buying) | EC Buying ADuM3160 1500 V USB-USB isolator | https://www.amazon.com/dp/B0BXDKHNZN | 13.99 | Same as CC1, for the Riden USB.
A+B | Power box: mains, wire power, safety (PW), both variants | PW20 | 1 | USB cable for the RD6006 (match its port) 1 m + 1 M16 gland | Pass the device end in from outside, or use a split USB grommet | 5 | B | 4.09 | Amazon (Monoprice) + Digi-Key (LAPP) | Monoprice USB-A to micro-B 6 ft AtlasFlex + LAPP S2509 M16 gland | https://www.amazon.com/dp/B07KFQH2ZF | 6.89 | Amazon (Monoprice) | Monoprice USB-A to micro-B 6 ft; use a spare M16 from the PW15 kit | https://www.amazon.com/dp/B07KFQH2ZF | 4.09 | Quality = $4.09 + LAPP S2509 $2.80 https://www.digikey.com/en/products/detail/lapp/S2509/11200370. RD6006 PC port is micro-USB per EEVblog users: check yours. A USB-A plug won't pass an M16 gland: pass the micro-B end in from outside, or use a split USB grommet.
A+B | Controller side, both variants (CC) | CC1 | 1 | USB isolator ADuM3160 (full-speed 12 Mbit/s), ≥1.5 kV, boxed, e.g. DSD TECH SH-G01A. Check its PC-side plug (USB-A male or USB-B) before buying CC5. | Between PC and controller. Full speed is all the board's USB-serial chip uses. The board must be powered from 24 V: the isolator's output can't run it. | 12 | Q | 16.99 | Amazon (DSD TECH Direct) | DSD TECH SH-G01A USB isolator, ADuM3160, 1.5 kV, enclosed | https://www.amazon.com/dp/B093LKN3YH | 16.99 | Amazon (EC Buying) | EC Buying ADuM3160 1500 V USB-USB isolator | https://www.amazon.com/dp/B0BXDKHNZN | 13.99 | Olimex USB-ISO (Digi-Key) is rated only 1000 VDC, so it fails ≥1.5 kV. Adafruit 2107 is out of stock and unboxed. The SH-G01A appears to be a dongle (USB-A male upstream?), so the CC5 PC-side cable may need to be an A-extension. Check its photos. The EC Buying unit is listed as a 'module': check it has an enclosure, or print one.
A+B | Controller side, both variants (CC) | CC2 | 5 | Gold-contact roller microswitches Omron D2F-01L3 (4 + spare) | Low-current inputs need gold contacts ([Omron](https://omronfs.omron.com/en_US/ecb/products/pdf/en-ss.pdf)) | 13 | Q | 11.75 | Digi-Key | Omron (now Aratas) D2F-01L3 ×5 | https://www.digikey.com/en/products/detail/aratas-formerly-omron-components/D2F-01L3/368448 | 11.75 | AliExpress | 'Authentic Original Omron' D2F series, 10 pcs, choose the 01L3 variant | https://www.aliexpress.us/item/2255799885023469.html | 8.55 | D2F-01 = 0.1 A gold-alloy contact version. Digi-Key: 17,396 in stock, $2.35 ea. AliExpress Omron micro-switches are FAKE-PRONE (low sold count); this is the only listing cheaper than Digi-Key. Amazon 'Omron' B005T7GMEC is $5.82 ea from a third party.
A+B | Controller side, both variants (CC) | CC3 | 10 | 100 nF ceramic capacitors 50 V | Across each limit and estop input at the board | 1 | B | 6.99 | Digi-Key | KEMET C320C104K5R5TA 100 nF 50 V X7R radial ×10 | https://www.digikey.com/en/products/detail/kemet/C320C104K5R5TA/818040 | 9.61 | Amazon (BOJACK) | BOJACK 0.1 µF 50 V ceramic disc, 50 pack | https://www.amazon.com/dp/B07X5XTDPB | 6.99 | Digi-Key: 140,672 in stock, $0.961 ea at qty 10. Any C0G/X7R 100 nF ≥50 V works.
A+B | Controller side, both variants (CC) | CC4 | 1 | Adafruit #4218 USB-C round panel-mount extension, 30 cm (Ø22 mm hole), data-capable | Board USB-C → case wall | 6 | B | 3.55 | Adafruit | Adafruit #4218 USB-C round panel-mount extension 30 cm | https://www.adafruit.com/product/4218 | 9.95 | AliExpress | IP67 USB-C male-female panel-mount extension 30 cm | https://www.aliexpress.us/item/3256805321247540.html | 3.55 | Adafruit: in stock. Budget is not the spec part: hole size and nut differ from the Ø22 mm the printed case expects, and data lines are not guaranteed. Check before buying or edit the case hole.
A+B | Controller side, both variants (CC) | CC5 | 1 | USB-A ↔ USB-B 0.5 m (PC ↔ isolator, to match your isolator) + USB-A ↔ USB-C data cable 2 m (isolator ↔ case bulkhead) |  | 7 | B | 10.44 | Amazon (Monoprice / AnkerDirect) | Monoprice USB-A to B 1.5 ft (105436) + Anker USB-A to C 6 ft (2 pack) | https://www.amazon.com/dp/B009GUVZOK | 12.94 | Amazon (Monoprice / FEMORO) | Monoprice USB-A to B 1.5 ft + FEMORO USB-A to C data 6 ft | https://www.amazon.com/dp/B0FP1BX6FB | 10.44 | Quality = $2.95 + Anker https://www.amazon.com/dp/B07DC5PPFV $9.99. Budget = FEMORO $7.49 + same Monoprice A-B $2.95. Match the PC-side cable to your isolator: the DSD TECH SH-G01A may need a USB-A extension instead of an A-B cable.
A+B | Controller side, both variants (CC) | CC6 | 1 | U.FL → SMA bulkhead pigtail + 2.4 GHz antenna | Usually included with the board; else buy. Never power the board without it. | 4 | B | 5.98 | Adafruit + Digi-Key | Adafruit #851 SMA to u.FL cable + TE/Linx ANT-2.4-CW-RCT-SS (SMA male, 2.4 GHz) | https://www.adafruit.com/product/851 | 16.86 | Amazon (DAMGOO) | 2.4 GHz 2 dBi SMA-male antenna + U.FL to SMA-female bulkhead pigtail 30 cm | https://www.amazon.com/dp/B0GDJTDMRR | 5.98 | Quality = Adafruit 851 $3.95 + Linx $12.91 at Digi-Key (1,193 in stock; product page URL not captured, search MPN). Do NOT pair with Adafruit 944: it is RP-SMA (and out of stock). Usually included with the FluidNC board; only buy if missing. The 6x v1.1 has a PCB antenna and needs none.
A+B | Controller side, both variants (CC) | CC7 | 1 kit | Printed-box hardware: M3×5.7 heat-set inserts (10 per case, +12 for the rack), M3×6/×8 screws, M4×30 + nuts (fan), M5×10 + washers + T-nuts (4 per box). Exact list: [enclosure/README](../enclosure/README.md) §3 |  | 6 | B | 13.98 | Amazon (ruthex / Boeray) | ruthex RX-M3x5.7 brass heat-set inserts ×100 + Boeray M5 slide-in T-nuts 6 mm slot ×50 | https://www.amazon.com/dp/B08BCRZZS3 | 17.98 | Amazon (Moicstiy / Boeray) | Moicstiy M3×5.7×4.6 inserts ×100 + Boeray M5 T-nuts ×50 | https://www.amazon.com/dp/B0DQL4ZSCP | 13.98 | T-nuts https://www.amazon.com/dp/B01GCDG2QO $7.99 (in both totals). M3×6/×8, M5×10 + washers come from the PW17 kit. M4×30 + nuts for the fan are not in the kits: buy separately (hardware store).
A+B | Controller side, both variants (CC) | CC8 | 0.5 kg | PETG or ASA filament | Controller case (B needs VB9 too) | 10 | B | 11.69 | Amazon (Polymaker LLC) | Polymaker PETG 1.75 mm 1 kg black | https://www.amazon.com/dp/B0FG3HMCVY | 15.19 | Amazon (ELEGOO Official US) | ELEGOO PETG 1.75 mm 1 kg black | https://www.amazon.com/dp/B0D41Y3WWZ | 11.69 | Sold as 1 kg spools (the BOM needs 0.5 kg). Price is for the black colour; other colours cost more.
A+B | Controller side, both variants (CC) | CC9 | 3 | WAGO 221-415 lever connectors (5 conductors each) | Shield drains in the case, linked with a 0.5 mm² GN/YE jumper (A: 9 drains; B: 6 + rack link). B also needs VB8. | 3 | Q | 3.51 | Digi-Key | WAGO 221-415 ×3 | https://www.digikey.com/en/products/detail/wago-corporation/221-415/13549457 | 3.51 | Amazon (Peppy Products) | WAGO 221 assortment 12 pc with case (incl. 221-415) | https://www.amazon.com/dp/B0CJ5QF4Z2 | 12.45 | Digi-Key is the cheapest for 3 pcs ($1.17 ea, 243,877 in stock). The Amazon assortment is genuine WAGO but has only a few 221-415s; for more, the WAGO 25 pk is https://www.amazon.com/dp/B0107SYYGU $22.03. WAGO clones exist: avoid unbranded 'lever connectors'.
A | Variant A: FluidNC 4x (VA) | VA1 | 1 | FluidNC 4x CNC Controller v1.1 (ESP32 + 4× TMC2209) | Bart Dring. [Elecrow $49](https://www.elecrow.com/4x-cnc-controller-integrated-esp32-and-tmc2209.html), out of stock 2026-11-05: click "notify me", or build variant B. | 49 | Q | 49.00 | Elecrow (Bart Dring partner store) | FluidNC 4x CNC Controller, ESP32 + 4x TMC2209 | https://www.elecrow.com/4x-cnc-controller-integrated-esp32-and-tmc2209.html | 49.00 | Tindie (Bart Dring, River Forest IL) | Same board, 4x CNC Controller ESP32 + TMC2209 | https://www.tindie.com/products/33366583/4x-cnc-controller-integrated-esp32-and-tmc2209 | 49.00 | OUT OF STOCK at both (Elecrow: 'notify me'; Tindie sold out since 2025-06-21). There is no cheaper genuine source and I found no clones. Either wait or build variant B (VB1 is in stock). The page does not state the version, so ask for v1.1.
A | Variant A: FluidNC 4x (VA) | VA2 | 1 | 80 × 80 × 25 mm 24 V fan (≈0.1 A) | In the case lid, blowing onto the on-board drivers (lid grille = guard) | 5 | Q | 7.74 | Digi-Key | Sunon MF80252V1-1000U-A99, 80x80x25 mm, 24 VDC, 0.065 A, Vapo bearing, 41 CFM | https://www.digikey.com/en/products/detail/sunon-fans/MF80252V1-1000U-A99/6198743 | 7.74 | Amazon (GDSTIME official store) | GDSTIME 8025 24 V 2-pin brushless fan, hydraulic bearing | https://www.amazon.com/dp/B00N1Y3T9G | 8.99 | Genuine Sunon is cheaper than the generic at qty 1 (Digi-Key shipping extra). Sunon has bare leads; GDSTIME has an XH2.54 plug. 962 in stock.
A | Variant A: FluidNC 4x (VA) | VA3 | 12 | Cable glands for the case: 10× M16 × 1.5 (4.5–10 mm) (4 motor, 4 limit, PB-24, PB-SIG) + 2 spare |  | 6 | B | 9.99 | Digi-Key | 12x Altech 5308-951/SET, M16x1.5 polyamide gland, 3.5-10 mm, IP68, locknut included ($1.37 ea) | https://www.digikey.com/en/products/detail/altech-corporation/5308-951-SET/21378719 | 16.44 | Amazon (uxcell store) | uxcell M16x1.5 nylon cable gland, 4-8 mm, with locknut, 20 pcs | https://www.amazon.com/dp/B08K8J8242 | 9.99 | Altech meets the 4.5-10 mm spec (3.5-10). The budget gland clamps only 4-8 mm: fine for the ~5-7 mm TRVVP/CB16 cables, but not for anything over 8 mm. Generic M16 glands on Amazon are almost all 4-8 mm.
B | Variant B: FluidNC 6x + DM542T (VB) | VB1 | 1 | FluidNC 6x CNC Controller, integrated ESP32 (v1.2+) | Bart Dring. 12–30 V, external-driver outputs only, CP2102 USB-C. [Elecrow $49](https://www.elecrow.com/6x-cnc-controller-for-fluidnc.html) / [Tindie](https://www.tindie.com/products/33366583/6x-cnc-controller-for-fluidnc-integrated-esp32/) | 49 | Q | 49.00 | Elecrow (Bart Dring partner store) | 6x CNC Controller for FluidNC, integrated ESP32 | https://www.elecrow.com/6x-cnc-controller-for-fluidnc.html | 49.00 | Tindie (Bart Dring, US) | 6x CNC Controller for FluidNC, integrated ESP32 | https://www.tindie.com/products/33366583/6x-cnc-controller-for-fluidnc-integrated-esp32/ | 75.00 | Elecrow: in stock at $49 (ships from China). The page gives no version number (it only says all versions are dimensionally the same and the ESP32 now has an external antenna); confirm v1.2+ with CP2102 USB-C. Tindie (US) is pricier and sold out since 2026-02-28. There is no cheaper genuine source.
B | Variant B: FluidNC 6x + DM542T (VB) | VB2 | 4 | Stepper driver StepperOnline DM542T V4.0 | 18–50 VDC, differential PUL±/DIR±/ENA±, S2 selector → 5 V (ships at 24 V). [Manual](https://forum.duet3d.com/assets/uploads/files/1684504031141-dm542t_v4.0.pdf). Not the DM320T (common-anode inputs). | 108 | Q | 97.04 | StepperOnline (omc-stepperonline.com, US warehouse) | 4x DM542T (V4.0 with 5V/24V selector), $19.65 + $4.61 US-stock surcharge each | https://www.omc-stepperonline.com/digital-stepper-driver-1-0-4-2a-20-50vdc-for-nema-17-23-24-stepper-motor-dm542t | 97.04 | StepperOnline (same page, China warehouse) | 4x DM542T shipped from China ($19.65 ea, slower, shipping extra) | https://www.omc-stepperonline.com/digital-stepper-driver-1-0-4-2a-20-50vdc-for-nema-17-23-24-stepper-motor-dm542t | 78.60 | FAKE-PRONE: DM542T clones are common, so buy only from StepperOnline or its Amazon store (B06Y5VPSFN, $32.99 ea = $131.96, V4.0 confirmed). Ships with S2 set to 24 V: switch it to 5 V. US stock was 332 on 2026-11-07. Volume pricing may lower the per-unit price.
B | Variant B: FluidNC 6x + DM542T (VB) | VB3 | 1 + 1 | 60 × 60 × 25 mm 24 V fan (6x case lid) + optional 80 × 80 × 25 mm 24 V fan (rack end wall) | The rack also works as a chimney without its fan | 8 | Q | 20.44 | Digi-Key | Sunon MF60252V1-1000U-A99 (60x25, 24 V, 0.05 A, $12.70) + Sunon MF80252V1-1000U-A99 (80x25, 24 V, $7.74) | https://www.digikey.com/en/products/detail/sunon-fans/MF60252V1-1000U-A99/6198718 | 20.44 | Amazon (GDSTIME official store) | GDSTIME 6025 24 V ($12.99, B013HN7XEM) + GDSTIME 8025 24 V ($8.99, B00N1Y3T9G) | https://www.amazon.com/dp/B013HN7XEM | 21.98 | The 80 mm rack fan is optional; without it, $12.70 / $12.99. 80 mm Sunon URL: see VA2. The budget pick isn't cheaper, so buy Sunon. GDSTIME 6025 showed only 2 left.
B | Variant B: FluidNC 6x + DM542T (VB) | VB4 | 4 × 0.6 m | Step/dir cables 6x → rack: 4-core shielded 0.25 mm² (or TRVVP 4×0.3), one per driver | STEP, DIR, EN, GND | 5 | Q | 13.44 | igus (igus.com US) | chainflex CF240.02.04, 4x0.25 mm2 (24 AWG) shielded PVC, 8 ft cut ($1.68/ft) | https://www.igus.com/product/CF240?artnr=CF240.02.04 | 13.44 | Amazon (WJRZA store) | 22 AWG 4-conductor shielded UL2464 cable, 25 ft, OD 5.2 mm | https://www.amazon.com/dp/B0D9JY3MC4 | 16.99 | 4 x 0.6 m = 2.4 m = 7.9 ft, so order 8 ft (igus ships in 5-10 working days). This is a static run, so plain UL2464 is fine. The ~5 mm OD fits the M12 3-6.5 mm glands. The budget pick costs more than igus, so igus is the better buy.
B | Variant B: FluidNC 6x + DM542T (VB) | VB5 | 3 m each | 1.0 mm² red/black | 24 V from the rack WAGOs to each DM542T (own pair per driver, inside the rack) | 4 | B | 9.99 | Remington Industries (US) | 18 AWG UL1015 600V MTW stranded, red + black, 25 ft spools ($15.33 ea) | https://www.remingtonindustries.com/hook-up-wire/hook-up-wire-18-awg-600v-pvc-stranded-10-colors-7-sizes-available/ | 30.66 | Amazon (Mziklr) | 18 AWG 2-conductor PVC tinned-copper red/black parallel wire, 10 m (split into singles) | https://www.amazon.com/dp/B0FH4XTP88 | 9.99 | 18 AWG = 0.82 mm2, the nearest US size to 1.0 mm2; fine for a DM542T (<3 A). The same Remington red/black spools also cover CB5 red/black. One budget 10 m pair covers VB5 + CB16. Avoid CCA wire.
B | Variant B: FluidNC 6x + DM542T (VB) | VB6 | 1 set | Twin ferrules 2×0.5 mm² | PUL−/DIR−/ENA− jumpers | 2 | B | 9.99 | AutomationDirect | Z+F V30AE001134 twin ferrule 2x0.5 mm2 (2x20 AWG), 8 mm, pack of 500 | https://www.automationdirect.com/adc/shopping/catalog/wire_-a-_cable_termination/wire_end_connectors/insulated_ferrules/v30ae001134 | 28.50 | Amazon (HKS) | HKS TE0508 twin ferrules, white (DIN 2x0.5 mm2), 200 pcs | https://www.amazon.com/dp/B0GWZW5VHR | 9.99 | Skip VB6 if you buy the CB11 quality kit (Ferrules Direct SK2210TW includes 50 twin 20 AWG ferrules). AD colour is orange (standard code). Needs a ferrule crimper.
B | Variant B: FluidNC 6x + DM542T (VB) | VB7 | 21 | Cable glands: 6x case 6× M16 (4.5–10) (4 limit, 24 V in, PB-SIG) + 4× M12 (step/dir out); rack 6× M16 (4 motors, PB-24 in, 24 V out to the 6x) + 4× M12 (step/dir in); 1 spare |  | 10 | B | 15.78 | Digi-Key + AutomationDirect | 13x Altech 5308-951/SET M16 3.5-10 mm w/ locknut ($17.81) + 2x 5-pack Bimed BM-ENX-2S-W M12x1.5 3-6.5 mm w/ hardware ($6.50, AutomationDirect) | https://www.digikey.com/en/products/detail/altech-corporation/5308-951-SET/21378719 | 24.31 | Amazon (uxcell + Dimove) | uxcell M16 4-8 mm 20 pcs ($9.99, B08K8J8242) + 10 pcs M12x1.5 3-6.5 mm ($5.79, B0GQBKKPM6) | https://www.amazon.com/dp/B08K8J8242 | 15.78 | 21 = 12x M16 + 8x M12 + 1 spare. Quality M12 URL: https://www.automationdirect.com/adc/shopping/catalog/wire_-a-_cable_management/cable_glands/metric_thread/bm-enx-2s-w (96 available). Budget M16 is 4-8 mm only (see VA3). B0GQBKKPM6 showed 1 left; fallback is uxcell B00B0Q7DTO (5 pcs M12 3-6.5 mm, $9.19).
B | Variant B: FluidNC 6x + DM542T (VB) | VB8 | 4 | WAGO 221-415 (rack): +24 V bus, 0 V bus (2 linked each) | 7 conductors per bus: PB-24, 4 drivers, 6x feed, rack fan | 4 | Q | 4.68 | Digi-Key | 4x WAGO 221-415 Lever-Nut, 5-conductor, 24-12 AWG ($1.17 ea) | https://www.digikey.com/en/products/detail/wago-corporation/221-415/13549457 | 4.68 | Amazon (WAGO store, sold by DE Supply) | WAGO 221-415, 50-pack | https://www.amazon.com/dp/B01M6Y2UEK | 33.90 | There is no cheaper genuine source than Digi-Key at qty 4; the 50-pack only makes sense if you want spares (it also covers CC9). FAKE-PRONE: avoid unbranded 'lever connectors' on Amazon, AliExpress or eBay (counterfeits are under-rated). Digi-Key showed ~244k in stock.
B | Variant B: FluidNC 6x + DM542T (VB) | VB9 | 0.5 kg | Extra PETG/ASA for the 6x case + rack (≈0.9 kg total) |  | 10 | B | 13.22 | Amazon (Polymaker official store) | Polymaker PETG 1.75 mm, 1 kg, black | https://www.amazon.com/dp/B0FG3HMCVY | 15.19 | Amazon (OVERTURE official store) | OVERTURE High Speed PETG 1.75 mm, 1 kg, black | https://www.amazon.com/dp/B07PGYHYV8 | 13.22 | Filament is only sold by the spool, so the 0.5 kg need becomes 1 kg. One 1 kg spool covers CC8 (0.5 kg) + VB9 (0.5 kg) = 0.9 kg total. Prefer ASA if the rack sits near heat.
A+B | Cables and wiring consumables (CB), both variants | CB1 | 18 m | TRVVP (drag-chain) shielded 4×0.5 mm² | 4 motor runs (15 m) + PB-SIG power box ↔ controller (3 m) | 26 | B | 24.01 | igus (igus.com US) | chainflex CF78.UL.05.04, 4x0.5 mm2 (20 AWG) shielded PUR, drag-chain rated, 59 ft cut ($2.60/ft) | https://www.igus.com/product/CF78_UL?artnr=CF78.UL.05.04 | 153.40 | AliExpress (TRVVP listing, 706 sold, 5.0 stars) | High-flex shielded drag-chain cable TRVVP, 2-40 core 26-11 AWG; choose 4C x 0.5 mm2 (20 AWG), >=18 m | https://www.aliexpress.us/item/3256804585223639.html | 24.01 | igus has no 4x0.5 mm2 shielded PVC cable (CF240 tops out at 0.34 mm2; CF6 starts at 1.5 mm2), so the genuine pick is PUR CF78.UL: min bend 6.8xd (~45 mm) <= R48, ships 5-10 days. Budget price is the search-shown 'from' price ONLY: AliExpress item pages were CAPTCHA-blocked, so the real price for 4C x 0.5 mm2 x 18 m is unverified (expect ~$1-1.5/m). Amazon '20/4 chain CNC' UL2464 cables (e.g. B0CRL4MYM5, $17.99/50 ft) are not true TRVVP.
A+B | Cables and wiring consumables (CB), both variants | CB2 | 15 m | TRVVP shielded 3×0.3 mm² | 4 limit runs | 14 | B | 24.01 | igus (igus.com US) | chainflex CF240.03.03, 3x0.34 mm2 (22 AWG) shielded PVC, drag-chain rated, 50 ft cut ($1.65/ft) | https://www.igus.com/product/CF240?artnr=CF240.03.03 | 82.50 | AliExpress (same TRVVP listing as CB1) | TRVVP shielded drag-chain cable; choose 3C x 0.3 mm2 (22 AWG), 15 m | https://www.aliexpress.us/item/3256804585223639.html | 24.01 | 15 m = 49.2 ft, so order 50 ft. 0.34 mm2 is the igus size nearest 0.3. Budget price is the listing 'from' price (item page CAPTCHA-blocked); check the variant price in the cart. Non-TRVVP Amazon fallback: LRXCREEK 22/3 shielded UL2464 50 ft, B0FR341J3L, $25.99 (flex-rated claim only).
A+B | Cables and wiring consumables (CB), both variants | CB3 | 5 m red + 6 m black | Silicone wire 1.0 mm² (18 AWG), fine-strand | Hot-wire leads W-HR (red), W-HT (black) | 10 | Q | 13.98 | Amazon (BNTECHGO official store) | BNTECHGO 18 AWG silicone wire, red + black, 25 ft each, 150x0.08 mm strands | https://www.amazon.com/dp/B07HGTKQ89 | 13.98 | Amazon (TUOFENG) | TUOFENG 18 AWG silicone wire, 100 ft red and black | https://www.amazon.com/dp/B07FMWNF3J | 16.99 | 18 AWG = 0.82 mm2; 1.0 mm2 (17 AWG) silicone isn't commonly sold in the US. 25 ft = 7.6 m per colour covers 5 m red + 6 m black. I found no cheaper decent source: BNTECHGO is already budget-priced, and TUOFENG only gives more metres per dollar. 10 ft packs are too short.
A+B | Cables and wiring consumables (CB), both variants | CB4 | 2 m each | 1.0 mm² H07V-K brown, blue, green/yellow (US: UL1015 600 V 18 AWG; earth = green) | Mains inside the power box | 5 | B | 19.48 | Remington Industries (US) | 18 AWG UL1015 600V MTW stranded, brown + blue + green, 25 ft each ($15.33 ea) | https://www.remingtonindustries.com/hook-up-wire/hook-up-wire-18-awg-600v-pvc-stranded-10-colors-7-sizes-available/ | 45.99 | Amazon (BNTECHGO official store) | BNTECHGO 18 AWG silicone 600 V kit, 10 colours x 10 ft (incl. brown/blue/green/red/black/orange) | https://www.amazon.com/dp/B09X46HDZG | 19.48 | SPEC NOT MATCHED EXACTLY: US distributors don't sell H07V-K in short lengths (Lapp on Amazon comes in 100 m reels). UL1015 600 V MTW is the US equivalent. UL1015 has no green/yellow stripe, so use green (the US PE colour) or GN/YE from CB8. 18 AWG = 0.82 mm2, OK for the PSU input current. One budget kit covers CB4 + CB5.
A+B | Cables and wiring consumables (CB), both variants | CB5 | 3 m each | 1.0 mm² (US: 18 AWG) red, black, orange | 24 V and wire (orange) circuits inside the power box | 6 | B | 19.48 | Remington Industries (US) | 18 AWG UL1015 600V MTW stranded, red + black + orange, 25 ft each ($15.33 ea) | https://www.remingtonindustries.com/hook-up-wire/hook-up-wire-18-awg-600v-pvc-stranded-10-colors-7-sizes-available/ | 45.99 | Amazon (BNTECHGO official store) | Same 10-colour 18 AWG silicone kit as CB4 (10 ft = 3.05 m per colour) | https://www.amazon.com/dp/B09X46HDZG | 19.48 | Don't double-buy: the red/black Remington spools are shared with VB5 (one 25 ft spool each covers 3+3 m), so only orange is extra ($15.33). The budget kit is shared with CB4 (3.05 m per colour just covers 3 m), so its price is $0 if you already bought it for CB4. 18 AWG = 0.82 mm2.
A+B | Cables and wiring consumables (CB), both variants | CB6 | 3 m each | 0.5 mm² red, black | Fans, internal jumpers | 3 | B | 12.48 | Remington Industries (US) | 20 AWG UL1015 600V MTW stranded, red + black, 25 ft each ($14.46 ea) | https://www.remingtonindustries.com/hook-up-wire/hook-up-wire-20-awg-600v-pvc-stranded-10-colors-7-sizes-available/ | 28.92 | Amazon (BNTECHGO official store) | BNTECHGO 20 AWG silicone wire, red + black, 25 ft each | https://www.amazon.com/dp/B07HGTHTKT | 12.48 | 20 AWG = 0.52 mm2.
A+B | Cables and wiring consumables (CB), both variants | CB7 | 1 set | 0.25 mm² hook-up, 4 colours | Caps, short internal links | 4 | B | 14.85 | Remington Industries (US) | 24 AWG UL1015 600V stranded, 4 colours x 25 ft ($12.45 ea) | https://www.remingtonindustries.com/hook-up-wire/24-awg-ul1015-hook-up-wire-600v-pvc-stranded-10-colors-7-sizes-available/ | 49.80 | Amazon (CBAZY) | 24 AWG UL1007 PVC hook-up kit, 6 colours x 10 m | https://www.amazon.com/dp/B073QHZK55 | 14.85 | 24 AWG = 0.20 mm2, the nearest size to 0.25. The quality pick is overkill for short links; the budget kit is perfectly adequate here.
A+B | Cables and wiring consumables (CB), both variants | CB8 | 5 m + 4 m | 1.5 mm² (US: 14 AWG) GN/YE (US: green) (frame bond, lid strap, static frame jumpers, PELV bond) + 0.5 mm² GN/YE 4 m (rail and carriage bonds) + 6 M5 + 10 M3 ring lugs + serrated washers | PE bonding | 7 | B | 24.97 | Remington Industries (US) | 14 AWG UL1015 MTW green 25 ft ($20.04) + 20 AWG UL1015 green 25 ft ($14.46); wire only | https://www.remingtonindustries.com/hook-up-wire/hook-up-wire-14-awg-600v-pvc-stranded-10-colors-7-sizes-available/ | 34.50 | Amazon (BNTECHGO + Vifmy) | BNTECHGO 14 AWG silicone green 25 ft ($14.98) + Vifmy external-tooth star washer assortment M2.5-M12, 500 pcs ($9.99, B0CP7YZ9JY) | https://www.amazon.com/dp/B06XDNM1P5 | 24.97 | SPEC NOTE: 14 AWG (2.08 mm2) is the smallest US size >= 1.5 mm2 (16 AWG is only 1.31 mm2). Green/yellow striped wire is hard to find in short lengths in the US; plain green is the US PE colour. Amazon 16 AWG GN/YE (B098NJT22C, 1.27 mm2) is under spec. Ring lugs: TE PIDG from CB12 (quality) or the CB12 kit (budget, has M3/M5). For 0.5 mm2 bonds on the budget side, use the green 20 AWG or 18 AWG from the CB4/CB6 kits.
A+B | Cables and wiring consumables (CB), both variants | CB9 | 2 | Drag chain 15×20 mm inner, bend radius ≥ R48, openable, 1 m, with end brackets | One per tower along X | 14 | Q | 70.00 | igus (igus.com US) | 2x E-Z chain Z08.20.048.0, inner 14.6x20 mm, R48, opens along inner radius, 1 m (50 links) each ($35/m) | https://www.igus.com/product/series-Z08?artnr=Z08.20.048.0 | 70.00 | Amazon (GAVATKLKCP) | 2x 1 m drag chain 15x20 mm semi-enclosed, variant R48 | https://www.amazon.com/dp/B0FV96P51C | 77.70 | igus inner height is 14.6 mm vs the 15 mm spec (max cable 10 mm, so fine). Mounting brackets 080.20.12.A2 are 'price on request'; igus ships in 5-6 weeks. No cheaper R48 15x20 chain in the US: common Amazon 15x20 chains (e.g. B07QYM8XQ7, $15.99) are R28/R38 only and FAIL R>=48. AliExpress 3256813267386799 lists 15x20 R48 at ~$36.81 (unverified). Recommend igus.
A+B | Cables and wiring consumables (CB), both variants | CB10 | 1 set | Spiral wrap 8–10 mm (3 m) + 10 P-clips | Head-lead loops, power-box lid harness | 5 | B | 19.98 | MarineEngine.com (Ancor) + Amazon | Ancor 452381 3/8in (9.5 mm) black spiral wrap, 10 ft ($13.89) + ISPINNER 180-pc nylon P-clip kit ($9.99, B08BNJGXRS) | https://www.marineengine.com/boat-accessories/electrical/452381 | 23.88 | Amazon (uxcell + ISPINNER) | uxcell spiral wrap 8x10 mm, 3 m ($9.99) + ISPINNER 180-pc nylon P-clip kit ($9.99) | https://www.amazon.com/dp/B07Z2VBSJ2 | 19.98 | I couldn't find a branded P-clip pack in small quantity, so both picks use the ISPINNER kit (includes 1/4in and 5/16in clips). Cheaper spiral wrap: XHF 3/8in, 26 ft, $6.99 (B07JP5CNMW, search-only).
A+B | Cables and wiring consumables (CB), both variants | CB11 | 1 set | Ferrules 0.25–1.5 mm² (+ twin) | Every screw terminal | 10 | Q | 18.50 | Ferrules Direct (US specialist) | SK2210TW single + twin insulated ferrule kit, 22-10 AWG, 775 pcs (incl. 50 twin 20 AWG) | https://www.ferrulesdirect.com/products/sk2210tw | 18.50 | Amazon (Preciva store) | Preciva 1500-pc single + twin ferrules 0.25-6 mm2 with ratchet crimper | https://www.amazon.com/dp/B0CDBKY8HK | 23.98 | The Ferrules Direct kit starts at 22 AWG (0.5 mm2), so add Z+F V30AE000003 (0.34 mm2, 500 pcs, ferrulesdirect.com/products/v30ae000003) for the 0.25 mm2 leads, plus a crimper. The budget kit includes the crimper and 0.25 mm2 ferrules, so its price isn't like-for-like.
A+B | Cables and wiring consumables (CB), both variants | CB12 | 1 set | Insulated ring lugs M4/M5 | Tip blocks, PE | 4 | Q | 3.68 | Digi-Key | 10x TE PIDG 2-36160-1 insulated ring #10 (M5), 16-14 AWG | https://www.digikey.com/en/products/detail/te-connectivity-amp-connectors/2-36160-1/289206 | 3.68 | Amazon (smseace) | 200-pc insulated ring terminal kit M3/M4/M5/M6, 22-16/16-14/12-10 AWG | https://www.amazon.com/dp/B0CHR87N2D | 8.99 | For 18 AWG tip-block leads, use 22-16 AWG (red) PIDG rings; Digi-Key lists 16-22AWG #10 from $0.41. M4 = #8 stud. The budget kit also covers the CB8 M3/M5 lugs.
A+B | Cables and wiring consumables (CB), both variants | CB13 | 1 set | Heat-shrink incl. adhesive-lined | Motor/limit splices | 6 | B | 9.99 | Digi-Key | Qualtek Q5-3X-QK1-01-6IN-114, 3:1 dual-wall adhesive-lined kit, 114 pcs 1/8-3/4in | https://www.digikey.com/en/products/detail/qualtek/Q5-3X-QK1-01-6IN-114/3692964 | 45.54 | Amazon (XHF official store) | XHF UL-listed 225-pc 3:1 adhesive-lined heat-shrink kit, 8 sizes | https://www.amazon.com/dp/B0DC5YN5CD | 9.99 | The quality kit is adhesive-lined only. For plain insulation, add a thin-wall kit (e.g. Adafruit 4559 on Digi-Key, $9.95). 167 in stock.
A+B | Cables and wiring consumables (CB), both variants | CB14 | 1 set | Cable ties, adhesive mounts, 10 T-slot tie mounts, labels | Routing | 8 | B | 1.09 | Digi-Key | 10x Panduit TM2S8-C0 screw-mount cable-tie base #8 (M4), black | https://www.digikey.com/en/products/detail/panduit-corp/TM2S8-C0/2671108 | 7.35 | AliExpress | 50-pc cable-tie saddles for V-slot/T-slot aluminium profiles | https://www.aliexpress.us/item/3256809694138608.html | 1.09 | No branded drop-in tie mount for 20-series 6 mm slot is sold by US distributors (80/20 12314 is for 10/25-series only). Bolt the Panduit bases with M4 screws into drop-in M4 T-nuts. Not priced: ties, adhesive mounts and labels (any brand; e.g. Brady/Klein labels on Amazon). The budget price is the search-shown 'from' price (item page CAPTCHA-blocked); check the slot fit.
A+B | Cables and wiring consumables (CB), both variants | CB15 | 1 | Solder | Splices | 3 | B | 8.99 | Adafruit | Mini leaded solder spool, 0.8 mm, 50 g | https://www.adafruit.com/product/5897 | 9.25 | Amazon (MAIYUM) | 63/37 rosin-core solder 0.8 mm, 50 g | https://www.amazon.com/dp/B075WB98FJ | 8.99 | 62 in stock at Adafruit. Kester 63/37 on Digi-Key only comes in 1 lb spools ($67-98), too much for this job.
A+B | Cables and wiring consumables (CB), both variants | CB16 | 3.5 m | 2-core 2×1.0 mm² red/black DC cable (PVC or silicone, not grey mains cable) | PB-24 (3 m) + B: rack → 6x (0.5 m). Label both ends "24 V DC". | 4 | B | 9.99 | Amazon (BNTECHGO official store) | BNTECHGO 18 AWG 2-conductor parallel silicone wire, red/black, 25 ft | https://www.amazon.com/dp/B0779QRR58 | 14.98 | Amazon (Mziklr) | 18 AWG 2-conductor PVC tinned-copper red/black parallel wire, 10 m | https://www.amazon.com/dp/B0FH4XTP88 | 9.99 | 18 AWG = 0.82 mm2 (nearest to 1.0). This is a bonded red/black pair, not a jacketed cable; the spec allows PVC or silicone. For PB-24 at ~3-4 A, it's fine. Avoid CCA listings (e.g. B0DZ6CF2FJ, B0G9NYN463). One 10 m budget pair covers CB16 (3.5 m) + VB5 (3 m). Label both ends '24 V DC'.
A+B | Frame (FR): 20-series T-slot, 6 mm slot | FR1 | 2 | 2040 × 1900 mm | Base rails B1 (front), B2 (back), standing (40 tall) | 43 | Q | 39.48 | TNUTZ | EXM-2040 20x40 smooth T-slot, 20-series 6 mm slot, cut 74-13/16 in (1900.6 mm) x2 @ $19.74 | https://www.tnutz.com/product/exm-2040/ | 39.48 | Amazon (VEVOR store, ships from Amazon) | VEVOR 5PCS 2040 T-slot 2000 mm, European std; bars 1-2 cut to 1900 (2 of 5 bars allocated, pack $125.90) | https://www.amazon.com/dp/B0F4823SDV | 50.36 | TNUTZ is cheaper per metre but 1.9 m pieces ship oversize: check freight at checkout. VEVOR cut plan for one 5-bar pack: 2x1900 (FR1), 2x1250 + 750 offcuts (FR2 -> FR4), 1 bar for FR11. You cut it yourself on a miter saw with a non-ferrous blade. Euro 2040 slot is 6.0-6.2 mm and takes the same M5/M3 drop-in nuts.
A+B | Frame (FR): 20-series T-slot, 6 mm slot | FR2 | 2 | 2040 × 1250 mm | X-beams (root, tip), standing. Tap both end holes M5. | 28 | Q | 26.48 | TNUTZ | EXM-2040 cut 49-3/16 in (1249.4 mm) x2 @ $13.24 | https://www.tnutz.com/product/exm-2040/ | 26.48 | Amazon (VEVOR store) | Bars 3-4 of the FR1 VEVOR 2000 mm pack, cut to 1250 (2 bars allocated) | https://www.amazon.com/dp/B0F4823SDV | 50.36 | Tap both end holes M5: TNUTZ offers a tapping option on the product page (extra cost, not included), or tap it yourself (4.2 mm core). The 750 mm offcuts from the budget bars become FR4.
A+B | Frame (FR): 20-series T-slot, 6 mm slot | FR3 | 2 | 2040 × 1250 mm | Bed supports C1, C2 | 28 | Q | 26.48 | TNUTZ | EXM-2040 cut 49-3/16 in (1249.4 mm) x2 @ $13.24 | https://www.tnutz.com/product/exm-2040/ | 26.48 | Amazon (PENGLONG) | 2040 V-slot 1500 mm 2PCS with corner bracket kit; cut to 1250 | https://www.amazon.com/dp/B0DSV2JWQ1 | 75.99 | The one VEVOR pack is 280 mm short for the whole frame (10.28 m needed vs 10.0 m), so the budget bed supports come from this 2-pack. V-slot has a 6.2 mm opening and takes the same drop-in T-nuts, which is fine for the bed supports. The 250 mm offcuts become FR11 (variant A). Only 5 were in stock.
A+B | Frame (FR): 20-series T-slot, 6 mm slot | FR4 | 2 | 2040 × 500 mm | Tower posts. Tap both ends M5. | 12 | Q | 10.88 | TNUTZ | EXM-2040 cut 19-11/16 in (500.1 mm) x2 @ $5.44 | https://www.tnutz.com/product/exm-2040/ | 10.88 | Amazon (VEVOR store) | Cut from the 750 mm FR2 offcuts of the VEVOR 2000 mm bars | https://www.amazon.com/dp/B0F4823SDV | 0.00 | Tap both ends M5 (TNUTZ tapping option or by hand). Budget cost is already counted under FR1/FR2.
A+B | Frame (FR): 20-series T-slot, 6 mm slot | FR5 | 24 | 2040 cast corner brackets + M5 screws | 8 X crossings, 8 C crossings, 4 posts, 4 for P6, spares 0 | 12 | B | 12.99 | TNUTZ | CBK-020-A 20-series 2-hole inside corner bracket kit (bracket + 2 M5 drop-in T-nuts + 2 M5x8 BHCS), equiv. 80/20 #14053, x24 @ $1.50 | https://www.tnutz.com/product/cbk-020-a/ | 36.00 | Amazon (JCSPBYL) | 30 sets 2020/2040 corner brackets (zinc alloy) + 62 M5 T-nuts + screws | https://www.amazon.com/dp/B0DQDT9K64 | 12.99 | Read as 20-series 2-hole cast brackets (one fits each 20 mm slot face, matching the BOM's ~$0.50 each). If you want 40-wide 4-hole 2040 brackets instead, use Amazon B09ZX28MXY (10 pcs + T-nuts + screws, $18.99/pack, 3 packs) [search-verified only]. The kits include extra T-nuts, which act as FR6 spares.
A+B | Frame (FR): 20-series T-slot, 6 mm slot | FR6 | 150 | M5 drop-in T-nuts | ≈114 used | 11 | B | 19.98 | TNUTZ | DB-020-M5 M5x0.8 drop-in T-nut with spring ball, 20-series, x150 @ $0.50 | https://www.tnutz.com/product/db-020-m5/ | 75.00 | Amazon (Xiexxinhai) | 100 pcs 2020-series M5 half-roll-in spring T-nuts x2 packs | https://www.amazon.com/dp/B0DX7B5ZNN | 19.98 | The budget nuts are roll-in half-round spring nuts and insert from the slot face, same use. TNUTZ DB-020A-M5 (80/20 #13084 equivalent) is also $0.50.
A+B | Frame (FR): 20-series T-slot, 6 mm slot | FR7 | 100 | M3 drop-in T-nuts | MGN12 rails (≈64 used) | 6 | B | 9.49 | TNUTZ | DB-020-M3 M3x0.5 drop-in T-nut with spring ball, 20-series, x100 @ $0.50 | https://www.tnutz.com/product/db-020-m3/ | 50.00 | Amazon (Mriuuod US) | 100 pcs M3 roll-in spring T-nuts for 20-series (6 mm slot) | https://www.amazon.com/dp/B0DPK1TXBQ | 9.49 | For the MGN12 rail screws. Check that the M3 screw length doesn't bottom out on the profile core.
A+B | Frame (FR): 20-series T-slot, 6 mm slot | FR8 | 1 | Bed 18 mm MDF/ply 1300 × 700, sealed 2× PU |  | 25 | B | 45.00 | The Home Depot | MDF panel 3/4 in x 4 ft x 8 ft (actual 0.750 x 49 x 97 in), model 1118657; store cut to 1300 x 700 | https://www.homedepot.com/p/309177124 | ~45 | Lowe's | 3/4 in x 4 ft x 8 ft sanded MDF (0.745 in), item 922039 | https://www.lowes.com/pd/MDF-Actual-0-745-in-x-48-92-in-x-8-07-ft/1000344499 | ~45 | Both sites show price and stock only per store; ~$40-50 is the typical range. 1300 mm needs a full 4x8 sheet (2x4 and 4x4 project panels are 1219 mm max). Sealing: add a quart of oil polyurethane, e.g. Minwax Fast-Drying ~$15 (not in the price). 18 mm ply is also fine per BOM.
A+B | Frame (FR): 20-series T-slot, 6 mm slot | FR9 | 4 | Rubber pads | Feet | 4 | Q | 2.08 | Digi-Key (3M) | 3M Bumpon SJ-5023-BROWN 20.6 mm square x 7.6 mm adhesive bumper x4 @ $0.52 | https://www.digikey.com/en/products/detail/3m/SJ-5023-BROWN/3866055 | 2.08 | Amazon (Rrina) | 12 pcs rubber feet, 20 mm OD x 13 mm, with M4 screws + T-nuts for 20-series | https://www.amazon.com/dp/B0B3MLC5FR | 9.99 | Bumpon is polyurethane, not rubber, and is cheapest. The budget feet are real rubber and bolt into the slot, but cost more. Any 4 rubber pads work.
A+B | Frame (FR): 20-series T-slot, 6 mm slot | FR10 | 1 set | Foam hold-down: 4–6 kg steel offcuts + pins/carpet tape + 15–20 mm scrap-foam spacer strips |  | 5 | B | 5.99 | Amazon (Scotch/3M, sold by Amazon) | Scotch CT2010 indoor carpet tape 1.5 in x 14 yd | https://www.amazon.com/dp/B003B4NUFE | 5.99 | Amazon (Kraftex) | Kraftex double-sided carpet tape 30 ft | https://www.amazon.com/dp/B0G1YV418T | 5.99 | Kit line, only the tape is bought. Steel offcuts (4-6 kg) come from scrap or a metal yard's drop bin. Pins are plain T-pins. Spacer strips are cut from scrap foam.
A+B | Frame (FR): 20-series T-slot, 6 mm slot | FR11 | 1 | Box mounting rail: 2040 offcut lying flat, 250 mm (A) / 480 mm (B), + 4 M5 T-nuts + 2 wood screws/clamps to the bench | Printed boxes bolt to it, beside the power box | 5 | Q | 5.18 | TNUTZ | EXM-2040 cut 18-7/8 in (479.4 mm) for variant B (variant A 250 mm ~ $2.90) | https://www.tnutz.com/product/exm-2040/ | 5.18 | Amazon (VEVOR store) | 5th bar of the FR1 VEVOR pack (B: 480 mm); variant A uses a 250 mm FR3 offcut at $0 | https://www.amazon.com/dp/B0F4823SDV | 25.18 | The 4 M5 T-nuts come from FR6 spares. The 2 wood screws or clamps to the bench are not priced.
A+B | Motion and drive (M, L, D) | M1 | 5 | NEMA17 17HS19-2004S1 (4 + spare) | 2.0 A, 59 Ncm, 1 m lead. Black/green = coil A, red/blue = coil B (≈1.4 Ω, verify). [StepperOnline](https://omc-stepperonline.com/nema-17-bipolar-59ncm-84oz-in-2a-42x48mm-4-wires-w-1m-cable-and-connector.html) | 42 | Q | 65.45 | StepperOnline (US warehouse) | 17HS19-2004S1 NEMA17 59 Ncm 2.0 A 1 m cable, x5 @ $9.62 + $3.47 US-stock surcharge | https://www.omc-stepperonline.com/nema-17-bipolar-59ncm-84oz-in-2a-42x48mm-4-wires-w-1m-cable-connector-17hs19-2004s1 | 65.45 | Amazon (STEPPERONLINE store, sold by StepperOnline) | STEPPERONLINE 5PCS NEMA17 2 A 59 Ncm, model 5-17HS19-2004S1 | https://www.amazon.com/dp/B00QEYADRQ | 55.00 | Both are genuine StepperOnline. The Amazon 5-pack is cheaper. US warehouse had 75 in stock. Datasheet says 1.6 ohm/phase (Amazon says 1.4), so measure as the BOM says. Colours: black/green = A, red/blue = B.
A+B | Motion and drive (M, L, D) | L1 | 2 | MGN12 rail 1200 mm + 2× MGN12H blocks | Chord axes. Clones are fine at these loads. Genuine HIWIN comes in 1195 mm and costs ≈5×. | 64 | B | 146.37 | Motion Constrained (genuine HIWIN) | HIWIN MGNR12R rail 1195 mm x2 ($172.50) + HIWIN MGN12HZ0C long block x4 ($31.61; https://motionconstrained.com/store/hiwin-linear-guides/mgn-series/mgn-blocks-only/hiwin-mgn12hz0c-long-block/) | https://motionconstrained.com/store/hiwin-linear-guides/mgn-series/mgn-rails-only/hiwin-mgnr12r-linear-guideway-rail/ | 471.44 | Amazon (Mssoomm) | MGN12 rail 1200 mm + 1 MGN12H block x2 ($63.39) + 2pcs MGN12H blocks B0DF67146Q ($19.59) | https://www.amazon.com/dp/B08RWDYYKR | 146.37 | 1195 mm is the nearest HIWIN standard length (25 mm pitch); 5 mm short of 1200, so check travel. Motion Constrained is a HIWIN reseller, not an authorised distributor, with free US shipping. No US authorised HIWIN source sells online in small quantities. RISK: the budget rails are clones, and blocks from another seller may not match the rail preload. Slide blocks on with the plastic dummy rail so balls don't drop. Only 4 rails were left.
A+B | Motion and drive (M, L, D) | L2 | 2 | MGN12 rail 400 mm + 1× MGN12H | Vertical axes (HIWIN: 395 mm) | 28 | B | 40.29 | Motion Constrained (genuine HIWIN) | HIWIN MGNR12R rail 395 mm x2 ($68.91) + HIWIN MGN12HZ0C x2 ($31.61) | https://motionconstrained.com/store/hiwin-linear-guides/mgn-series/mgn-rails-only/hiwin-mgnr12r-linear-guideway-rail/ | 201.04 | Amazon (uxcell / Amadeo City) | uxcell 2pcs MGN12 400 mm rail + 2pcs MGN12H block | https://www.amazon.com/dp/B0D54LQ8QG | 40.29 | 395 mm is the HIWIN standard length nearest 400. Clone rails: check for smooth travel without play on arrival, then clean and grease (L3).
A+B | Motion and drive (M, L, D) | L3 | 1 | Lithium grease |  | 3 | Q | 3.99 | Amazon (Permatex, sold by Amazon) | Permatex 80345 white lithium grease 1.5 oz tube | https://www.amazon.com/dp/B000HBNV58 | 3.99 | Amazon (AstraVox) | AstraVox white lithium grease tube with brush | https://www.amazon.com/dp/B0DMK9ZM3N | 7.99 | Nothing decent is cheaper than Permatex at $3.99, so buy that. The budget column is just a second source.
A+B | Motion and drive (M, L, D) | D1 | 10 m | GT2 belt 6 mm, glass-fibre | 2 × ≈2.6 m | 8 | B | 13.99 | ServoCity | 3426-0006-0005 GT2 2 mm pitch 6 mm, 5 m cut-length, neoprene with fiberglass cords, x2 | https://www.servocity.com/2mm-pitch-gt2-timing-belt-6mm-width-5-meter-cut-length/ | 29.98 | Amazon (Zeelo-US) | Zeelo GT2 open belt 10 m, 6 mm, rubber fiberglass | https://www.amazon.com/dp/B08974S1CC | 13.99 | Each chord belt is ~2.6 m, so two 5 m rolls work. Genuine Gates 2GT is the premium option if wanted.
A+B | Motion and drive (M, L, D) | D2 | 3 | GT2 20T pulley, 5 mm bore | 2 + spare | 4 | B | 6.99 | ServoCity | 3422-0005-0020 GT2 pinion pulley 20T 5 mm bore (6 mm belt), x3 @ $7.99 | https://www.servocity.com/2mm-pitch-gt2-pinion-timing-pulley-5mm-bore-20-tooth/ | 23.97 | Amazon (WINSINN) | WINSINN GT2 20T 5 mm bore pulley for 6 mm belt, 5-pack | https://www.amazon.com/dp/B077GNZK3J | 6.99 | Adafruit #1251 ($7.95) is an equivalent alternative.
A+B | Motion and drive (M, L, D) | D3 | 3 | GT2 20T toothed idler, 5 mm bore | 2 + spare | 4 | B | 8.99 | Printed Solid (LDO) | LDO 2GT 20T toothed idler, 5 mm bore, 6 mm belt, x3 @ $3.90 | https://www.printedsolid.com/products/ldo-2gt-20t-idler-with-5mm-bore-for-6mm-belt | 11.70 | Amazon (WINSINN) | WINSINN GT2 20T toothed idler 5 mm bore for 6 mm belt, 5-pack | https://www.amazon.com/dp/B07BPGYX3G | 8.99 | LDO idler is EOL ('Last Chance', in stock and ships from Delaware); fall back to the WINSINN if it sells out. Make sure you get the toothed version, not the smooth one.
A+B | Motion and drive (M, L, D) | D4 | 4 | Steel NEMA17 L-bracket | 2 chord motors + 2 idler brackets | 10 | Q | 16.04 | StepperOnline (US warehouse) | ST-M1 NEMA17 alloy-steel L-bracket, x4 @ $1.84 + $2.17 US-stock surcharge | https://www.omc-stepperonline.com/nema-17-bracket-for-stepper-motor-and-geared-stepper-motor-alloy-steel-bracket-st-m1 | 16.04 | Amazon (HenGu) | 2pcs 42 mm alloy-steel L bracket 3 mm plate with screws, K-029-42, x2 packs | https://www.amazon.com/dp/B09372B2D1 | 19.98 | The budget option is not cheaper. ST-M1 from StepperOnline's China warehouse is $7.36 for 4 plus shipping. The US warehouse had 109 in stock.
A+B | Motion and drive (M, L, D) | D5 | 2 | M5 × 40 bolt + 4 washers + nylock | Idler axles | 2 | Q | 1.02 | Bolt Depot | M5-0.8x40 hex bolt class 8.8 zinc #6206 x2 ($0.32) + M5 nylon-insert locknut #4803 x2 ($0.09) + 4 M5 flat washers (~$0.05) | https://boltdepot.com/Product-Details?product=6206 | 1.02 | The Home Depot (Everbilt) | Everbilt M5-0.8 x 40 mm class 8.8 zinc hex bolt ($2.25/pack) + Everbilt M5 washers and nylon locknuts | https://www.homedepot.com/p/204273659 | ~6 | Bolt Depot blocks automated fetches, so it's search-verified. Its $5 small-order and shipping minimums apply, so bundle with other fasteners. Locknut: https://boltdepot.com/Product-Details?product=4803. Home Depot is a walk-in buy; its pack count wasn't confirmed.
A+B | Motion and drive (M, L, D) | D6 | 4 | GT2 belt clamps | On belt tab P4 | 4 | B | 7.99 | ServoCity | 3409-0004-0001 steel belt-clamp for GT2 (captive clinch nut), 2-pack x2 | https://www.servocity.com/steel-belt-clamp-for-2mm-pitch-gt2-timing-belt-2-pack/ | 9.98 | Amazon (3Dman) | 3DMAN GT2 aluminium toothed clamp block 9x40 mm, M4 centre hole, 10 pcs | https://www.amazon.com/dp/B08XVVQW6G | 7.99 | Check the hole pattern against the P4 belt tab before drilling. Only 10 budget packs were left.
A+B | Motion and drive (M, L, D) | D7 | 2 | T8×2 (2 mm lead, single start) lead screw 400 mm + flanged brass nut | Verticals. Not T8×8 (back-drives). | 20 | B | 15.59 | ZYLtech (Houston TX) | T8x2 single-start (2 mm pitch, 2 mm lead) 304 SS lead screw 400 mm + brass nut (22 mm flange, 16 mm hole spacing), x2 @ $9.65 | https://www.zyltech.com/8mm-t8x2-trapezoidal-acme-lead-screw-w-brass-nut-pre-cut-lengths-150mm-2000mm/ | 19.30 | Amazon (JRGJ TECH) | 2pcs 400 mm Tr8x2 lead screw + T8 brass nut (2 mm pitch, 1 start, 2 mm lead) | https://www.amazon.com/dp/B095MBMQNM | 15.59 | Both are confirmed T8x2 single start, not T8x8. Many look-alike listings are Tr8x8 or Tr8x4, so check the lead before ordering. Select the 400 mm option on the ZYLtech page.
A+B | Motion and drive (M, L, D) | D8 | 2 | Flexible coupler 5 → 8 mm |  | 4 | B | 6.99 | ServoCity | 4002-0005-0008 5 mm to 8 mm flexible clamping shaft coupler, x2 @ $6.99 | https://www.servocity.com/5mm-to-8mm-flexible-clamping-shaft-coupler/ | 13.98 | Amazon (ReliaBot) | 2pcs flexible coupling 5 mm to 8 mm (set-screw) | https://www.amazon.com/dp/B079J22KX1 | 6.99 | StepperOnline ST-FC04 ($1.27 each) ships only from China. Only 13 budget pairs were left.
A+B | Motion and drive (M, L, D) | D9 | 2 | KFL08 flange bearing | Screw bottom | 4 | B | 6.99 | Amazon (uxcell / Amadeo City) | uxcell KFL08 8 mm bore zinc-alloy flange bearing, P6/ABEC3, 4 pcs | https://www.amazon.com/dp/B0DM5KRT23 | 7.39 | Amazon (XDGM) | KFL08 8 mm aluminium-housing flange bearing, 4 pcs | https://www.amazon.com/dp/B0CWXC1BBJ | 6.99 | No US specialist distributor stocks the KFL08 generic. uxcell is the established brand, and the pack gives 2 spares. Housing: 48x27 mm, 36-37 mm bolt spacing, M4/M5.
A+B | Motion and drive (M, L, D) | D10 | 2 | T8 nut bracket (22 mm flange) | On head plate. Measure its nut-centre height (4.3). | 4 | B | 16.18 | Amazon (SEIWEI, sold by Revotool) | SEIWEI T8 nut conversion seat, aluminium 35x30x28 mm (for 22 mm flanged nut), black, x2 @ $9.49 | https://www.amazon.com/dp/B0BN3BHGD4 | 18.98 | Amazon (YEJMKJ) | T8 lead-screw nut housing/conversion seat 35x30x28 mm, x2 @ $8.09 | https://www.amazon.com/dp/B0GZZSHY7X | 16.18 | STOCK RISK: the black SEIWEI showed only 1 left; the silver B0BN3CRKMJ ($10.99) showed no availability. Budget showed 8 left. No reputable specialist sells this generic. Check that the 4 holes match the D7 nut (16 mm spacing), then measure the nut-centre height (step 4.3).
A+B | Wire heads, wire, tension (H) | H1 | 1 reel | Ni80Cr20 0.4 mm, 10–20 m | ≈8.7 Ω/m → ≈12.6 Ω at 1.45 m | 10 | Q | 18.18 | Amazon (Remington Industries brand store) | Remington Industries 26N80100 Nichrome 80, 26 AWG (0.0159 in / 0.40 mm), 100 ft | https://www.amazon.com/dp/B07622D2KY | 18.18 | Amazon (Master Wire Supply) | Nichrome 80, 26 ga, 0.40 mm, 100 ft, made in USA | https://www.amazon.com/dp/B07CHVKKCQ | 8.99 | 26 AWG = 0.404 mm, 2.57 ohm/ft (8.4 ohm/m), so about 12.2 ohm at 1.45 m. 100 ft (30 m) is the smallest common spool that covers the 10-20 m spec. Zoro also lists 26N80100 at $17.79.
A+B | Wire heads, wire, tension (H) | H2 | 10 | MIG contact tips M6 × 25 for 0.6 mm wire (CuCrZr) | Guide + current feed | 8 | B | 8.96 | Everlast Power Equipment (US) | Everlast 24KD HD M6 contact tip 0.023 in (0.6 mm), Cu-Cr-Zr, 10 pc | https://www.everlastgenerators.com/product/24kd-hd-m6-contact-tip-0023-10-pc | 15.00 | Amazon (Startbuymore) | MB15/15AK M6x25 tips 0.6 mm, 10 tips + nozzle + holder (listing claims Cu and CuCrZr) | https://www.amazon.com/dp/B0F9PMWMLT | 8.96 | SPEC PARTLY UNMATCHED: I found no US listing that confirms all of CuCrZr + M6x25 + 0.6 mm. Everlast's 24-series CuCrZr tip does not state its length (24-series M6 tips are usually 28 mm, not 25). For exact M6x25 geometry buy Everlast 15AK M6 0.023 (E-Cu, $10/10 pc): https://www.everlastgenerators.com/product/15ak-m6-contact-tips-0023-10-pc. The budget listing is generic, its stock indicator was unclear and its alloy is unverified.
A+B | Wire heads, wire, tension (H) | H3 | 2 | Tip blocks (from ST5) | 20×20×30 alu: M6 through, M4 lug, 2× M4 mounting | 0 | - |  | made from ST5 | Tip blocks 20x20x30 cut from ST5 bar (2 pcs) |  | 0 | made from ST5 |  |  | 0 | Made, not bought. Uses 60 mm of the ST5 bar. The US 3/4 in (19.05 mm) bar is fine: the M6 tip hole, M4 lug and 2x M4 mounting all fit.
A+B | Wire heads, wire, tension (H) | H4 | 1 | FR4/G10 5 mm (US: 3/16 in = 4.8 mm is fine), 100 × 150 | Insulators | 8 | B | 12.39 | Rock West Composites | G-10/FR-4 plate 12x12 in x 3/16 in (0.188 in = 4.8 mm), semi-gloss, P/N G10-188-1212 | https://www.rockwestcomposites.com/g10-188-1212.html | 43.99 | Zoro (USA Industrials) | G-10 Garolite sheet 3/16 in x 6 x 6 in, Mfr BULK-CS-GG10-56 | https://www.zoro.com/usa-industrials-g-10-garolite-sheet-316-thick-x-6-wide-x-6-long-bulk-cs-gg10-56/i/G7919683 | 12.39 | US stock is imperial: 3/16 in (4.76 mm) is the closest to 5 mm. Recheck the countersink depth (M4 DIN 7991 heads >=1 mm below the surface). Rock West shows 'available on backorder' (2-4 weeks). Budget is plain G-10 (not flame-rated FR4), which is fine as an insulator. Metric 5 mm FR4 100x150 exists on Amazon (CKSEKD B0CMX9489T, $33.88).
A+B | Wire heads, wire, tension (H) | H5 | 2 | POM (Delrin) V-wheel with 625ZZ | Tip-side deflector. Plastic = insulating. | 3 | B | 7.99 | Amazon (Official Creality store) | Creality POM wheel with 625ZZ bearings, 10 pcs | https://www.amazon.com/dp/B09QPG7XGR | 9.99 | Amazon (MKDCHUI) | POM pulley wheel with 625ZZ bearing, 12 pcs | https://www.amazon.com/dp/B0FL84VWR5 | 7.99 | Need 2; both are packs. openbuildspartstore.com now redirects to openbuilds.com and was not reachable. 3DPrintingUSA Delrin 625ZZ wheels were out of stock.
A+B | Wire heads, wire, tension (H) | H6 | 1 | Constant-force spring ≈20 N, ≥150 mm usable extension, drum | McMaster 9293K / Gutekunst. Alternative: 2 kg weight in a 50 mm PVC tube. | 10 | B | 8.48 | McMaster-Carr | Constant-force spring 9293K337: 4.93 lbf (21.9 N), 24 in extended length, 0.86 in ID, 3,000 cycles | https://www.mcmaster.com/9293K337 | ~10 (est.; price not visible to fetcher) | Home Depot (Charlotte Pipe) | BOM alternative: 2 kg weight in a 2 in x 2 ft PVC Sch 40 pipe (fill with ~2 kg sand or steel shot) | https://homedepot.com/p/Charlotte-Pipe-2-in-x-2-ft-PVC-DWV-Schedule-40-Pipe-PVC072000200HA/100585960 | 8.48 | Spring part confirmed in McMaster's constant-force table (24 in = 610 mm extension, well over 150 mm). Size the drum to about 22 mm (spring ID 0.86 in). Leave >=1.5 coils on the drum at full extension. Alternatives: 9293K118 (4.95 lbf, 33 in) and 9293K117 (4.0 lbf). The weight option saves about $8 but needs more space.
A+B | Wire heads, wire, tension (H) | H7 | 2 m | Aramid (Kevlar) line 1 mm, ≥50 kg (US: 150 lb, not 100 lb) | Insulating links | 4 | B | 9.25 | Amazon (emma kites store) | emma kites 100% Kevlar braided cord, 150 lb x 100 ft | https://www.amazon.com/dp/B0184ZGSQ2 | 9.95 | Amazon (9KM DWLIFE store) | 9KM DWLIFE braided Kevlar cord 150 lb, 1 mm dia x 100 ft | https://www.amazon.com/dp/B0BYYRZ2SL | 9.25 | The spec needs >=50 kg = 110 lb, so do NOT pick the 100 lb (45 kg) variants of these listings. 150 lb is about 68 kg. Only 2 m is needed. Both are packs.
A+B | Wire heads, wire, tension (H) | H8 | 20 | Crimp sleeves 1.0 mm | Wire loops | 2 | B | 6.39 | Amazon (HIGOOD) | Copper duplex oval crimping sleeves for 1/32 in wire rope, MS51844, 100 pcs | https://www.amazon.com/dp/B08Q431RP4 | 9.99 | Amazon (uxcell) | Aluminum double-ferrule crimp sleeves for 1/32 in (approx. 1 mm) wire rope, 100 pcs | https://www.amazon.com/dp/B0CWN2TM9C | 6.39 | 1/32 in = 0.8 mm nominal, which matches the '1.0 mm' sleeve. Copper is preferred near the wire. You need a small swaging or crimp tool (not in the BOM).
A+B | Wire heads, wire, tension (H) | H9 | 4 | Nylon M4 screws + nuts | Root-side anchor | 3 | Q | 2.00 | Bolt Depot | Nylon 6/6 M4x0.7x16 Phillips pan head (#21906) x4 + nylon 6/6 M4 hex nut (#21678) x4 | https://boltdepot.com/Product-Details?product=21906 | 2.00 | Amazon (Keadic) | M4 white nylon pan-head screws (6 lengths) + nylon nuts + washers, 360 pcs | https://www.amazon.com/dp/B0DLM3P24Z | 6.99 | Bolt Depot blocks automated fetch. Prices are from search snippets ($0.24 per screw, $0.26 per nut); nut URL: https://boltdepot.com/Product-Details?product=21678. Avoid 'plastic' M4 kits of unspecified material (e.g. uxcell B015A3GT6K is clear plastic).
A+B | Fasteners (FX) | FX1 | ≈150 | M5 button-head DIN 7380, 8/10/12/16 mm | Frame, brackets | 12 | B | 8.35 | AFT Fasteners | M5x10 button socket cap, 18-8 SS (ISO 7380), 100/pkg; buy 4 x 100-pk: 8/10/12/16 mm | https://www.aftfasteners.com/m5-0-80-x-10-mm-metric-button-head-cap-screw-coarse-18-8-ss-a2/ | 27.03 | Amazon (Glvaner) | M5x10 button head 18-8 SS, 100 pcs | https://www.amazon.com/dp/B09B72S5ZT | 8.35 (10 mm only; ~33 for all 4 lengths) | AFT pages verified: M5x8 $5.63, x10 $6.10, x12 $6.88, x16 $8.42 (400 pcs total). Same URL pattern with -8-mm / -12-mm / -16-mm. AFT is cheaper than the Amazon route. Amazon M5 assortment kits hold only about 10 per length, too few for 150.
A+B | Fasteners (FX) | FX2 | 40 + 10 | M5 washers + nylock |  | 3 | Q | 6.24 | AFT Fasteners | M5 DIN 125A A2 flat washers 100/pkg ($2.52) + M5 DIN 985 nylon-insert locknut A2-70 100/pkg ($3.72) | https://www.aftfasteners.com/m5-din-125a-stainless-steel-a2-flat-washers-100-pkg/ | 6.24 | Amazon (uxcell) | uxcell M5 304 SS nylon-insert lock nut kit (25 nuts + washers) + 100 M5 SS washers (B0BGHBH8RM, $4.99) | https://www.amazon.com/dp/B0D9XMMHCS | 12.98 | Nylock URL: https://www.aftfasteners.com/m5-0-80-din-985-nylon-insert-locknut-coarse-a2-70-100-pkg/ (marked close-out; the A4 version is $5.71). The Amazon kit has only 25 washers, so add the 100-pack washers to reach 40.
A+B | Fasteners (FX) | FX3 | ≈200 | M3 socket cap 6–20 mm | Rails, blocks, motors | 8 | Q | 10.54 | AFT Fasteners | M3 SHCS 18-8 SS DIN 912, 100/pkg x3 (8, 10, 12 mm) | https://www.aftfasteners.com/m3-0-50-x-10-mm-metric-socket-head-cap-screw-coarse-18-8-ss-a2/ | 10.54 | Amazon (Socell) | M3 SHCS 304 SS kit, 600 pcs, 8 lengths 6-30 mm (20 per length) + nuts/washers; buy 2 | https://www.amazon.com/dp/B0DYNLT9MK | 15.98 (2 kits) | AFT: x8 $3.50, x10 $3.54, x12 $3.50 (300 pcs). Add 6/16/20 mm 100-packs ($3.31 / $4.46 / $5.23) if your hole list needs them. Check the M3 length against the MGN12H block thread depth.
A+B | Fasteners (FX) | FX4 | 50 | M3 washers |  | 2 | Q | 1.45 | Bolt Depot | M3 flat washer DIN 125, 18-8 SS, bag of 100 (#4513) | https://boltdepot.com/Product-Details?product=4513 | 1.45 | Amazon (Zernmiarder) | M3 304 SS flat washers, 3 mm ID x 9 mm OD, 100 pcs | https://www.amazon.com/dp/B0DK6GQK78 | 4.99 | The FX3 budget kit (Socell) already includes 150 M3 flat washers, so this line can be skipped if you buy it.
A+B | Fasteners (FX) | FX5 | 30 + 4 | M4 SHCS 8–20 + nuts + 4× M4×12 countersunk DIN 7991 | Tip blocks, lugs | 5 | B | 4.99 | AFT Fasteners | M4x12 SHCS 18-8 100/pkg ($6.52) + M4 DIN 985 nylock A2-70 100/pkg ($5.25) + M4x12 flat socket DIN 7991 A4 100/pkg ($6.13) | https://www.aftfasteners.com/m4-0-70-x-12-mm-metric-socket-head-cap-screw-coarse-18-8-ss-a2/ | 17.90 | Amazon (Csxydz) | M4 304 SS SHCS kit 480 pcs (6/8/12/16/20/25/30 mm + nuts + washers) | https://www.amazon.com/dp/B0G4DNJMTD | 4.99 (+ c'sunk M4x12 separately) | Countersunk URL: https://www.aftfasteners.com/m4-0-70x12-mm-ft-flat-socket-head-cap-screw-316-stainless-steel-a4-100-pkg/. Other AFT M4 lengths: 8 mm $5.92, 16 mm $7.08, 20 mm $7.65. The Amazon kit has no countersunk screws; the 4x M4x12 DIN 7991 are mandatory (FR4 insulation).
A+B | Fasteners (FX) | FX6 | 1 | M5 shoulder bolt Ø6 × 10 | Spring drum | 3 | B | 2.89 | McMaster-Carr | Shoulder screw 92981A100: 6 mm shoulder dia x 10 mm shoulder, M5x0.8, black-oxide alloy steel | https://www.mcmaster.com/92981A100 | ~4 (est.; price not visible to fetcher) | Zoro (Zoro Select / Fabory M07111.060.0010) | Shoulder screw 6 mm x 10 mm shoulder, M5-0.8, alloy 12.9, 5-pack | https://www.zoro.com/zoro-select-shoulder-screw-m5-080-thr-sz-95-mm-thr-lg-10-mm-shoulder-lg-alloy-steel-5-pk-m071110600010/i/G1199012/ | 2.89 | 92981A100 confirmed in McMaster's metric shoulder screw table (6 mm x 10 mm, M5). Amazon alternative: MECCANIXITY 304 SS 6x10 M5, 16 pcs, $9.89 (B0FDQV89GM).
A+B | Fasteners (FX) | FX7 | 8 | M3 × 5 | PSU mounting (max 4 mm into the PSU) | 1 | Q | 0.40 | Bolt Depot | M3x0.5x5 socket cap, 18-8 SS (#6377), 8 pcs @ $0.05 | https://boltdepot.com/Product-Details?product=6377 | 0.40 | Amazon (Fullerkreg) | M3x5 button head socket screws, 18-8 SS, 100 pcs | https://www.amazon.com/dp/B07H14FQ2Z | 8.89 | Keep thread engagement <=4 mm in the PSU: M3x5 through a >=1 mm bracket. Bolt Depot shipping makes small orders pricier, so combine them with FX4/FX8/FX11/H9.
A+B | Fasteners (FX) | FX8 | 8 | M2 × 12 + nuts | D2F switches | 2 | Q | 1.60 | Bolt Depot | M2x0.4x12 socket cap 18-8 SS (#6366) x8 @ $0.13 + M2 hex nut 18-8 (#7362) x8 @ $0.07 | https://boltdepot.com/Product-Details?product=6366 | 1.60 | Amazon (Fgruh) | M2 304 SS SHCS kit 1260 pcs (4-20 mm incl. 12 mm, 315 nuts) | https://www.amazon.com/dp/B0FG2CC91J | 9.99 | Nut URL: https://www.boltdepot.com/Product-Details.aspx?product=7362.
A+B | Fasteners (FX) | FX9 | 1 | Thread-locker, medium | Set screws, couplers | 4 | Q | 21.16 | Amazon (Loctite store) | Loctite 243 medium-strength threadlocker, 10 mL (1329837) | https://www.amazon.com/dp/B004VODM24 | 21.16 | Amazon (Permatex store) | Permatex 24200 medium-strength blue threadlocker, 6 mL | https://www.amazon.com/dp/B0002UEMZ2 | 7.16 | Counterfeit Loctite is common from third-party sellers; buy only from the Loctite-store listing or an industrial distributor (Grainger, Zoro).
A+B | Fasteners (FX) | FX11 | 8 | M5×25 countersunk DIN 7991 | Bed down into T-nuts in C1/C2 | 1 | Q | 2.00 | Bolt Depot | M5x0.8x25 flat socket head DIN 7991, 18-8 SS (#6677), 8 pcs @ $0.25 | https://boltdepot.com/Product-Details?product=6677 | 2.00 | Amazon (Fastener Cart) | M5x25 flat head socket cap DIN 7991 A2-70, 25 pcs | https://www.amazon.com/dp/B07RYHWS39 | 12.21 | Bolt Depot is cheaper than the Amazon pick (small-order shipping applies). AFT also sells a 100-pack in A4 for $16.42.
A+B | Fasteners (FX) | FX12 | 2 sets | Chain standoff: 2× M5 × 30 mm aluminium spacers (+ 4× M5×45 screws) + 2020 offcut 100 mm (or 6 mm plate 100 × 40) per tower | Chain fixed end ≥80 mm out from the X-beam, outboard of belt and motor | 4 | B | 8.49 | Lyn-Tron (made in USA) | Aluminum round spacer, unthreaded, M5 screw, 10 mm OD, 30 mm long (AA5008-50-30.0-00), 4 pcs | https://www.lyntron.com/10.0mm-aluminum-round-spacer-unplated/pn/AA5008-50-30.0-00 | quote (price not shown) | Amazon (uxcell) | Aluminum spacer 5 mm bore x 10 mm OD x 30 mm, 10 pcs | https://www.amazon.com/dp/B0CQ89536M | 8.49 | 2 sets = 4 spacers + 2x 2020 offcut 100 mm. Take the offcuts from leftover frame extrusion, or cut 100x40 from 6 mm plate (ST2 leftover). Read 'spacer' as unthreaded: M5 screws pass through, so they need ~40-45 mm length, which is not in the FX list. The uxcell bore is 5.0 mm and may need a 5.2 mm drill.
A+B | Raw stock (ST) and fabricated parts | ST1 | 2 | 6061 plate 8 mm, 160 × 130 (US imperial: 5/16 in) | P1 | 15 | B | 29.99 | Speedy Metals | 6061-T651 plate 5/16 in (7.94 mm), 12x12 in | https://speedymetals.com/pc-2409-8360-516-6061-t651-aluminum-plate.aspx | 75.89 | Amazon (ZOFORTY store) | 6061-T6 plate 200x200x8 mm (8 x 8 x 5/16 in), 2-pack | https://www.amazon.com/dp/B0B4F1BWQ8 | 29.99 | One 12x12 gives both 160x130 blanks (two 130 widths side by side). Each 200x200 budget sheet gives one. 5/16 in is 0.06 mm under 8 mm. Metric 8 mm alternative: McMaster 6945T318 (12x12 in, tight-tolerance). Put ST1-ST5 in one Speedy order to share shipping.
A+B | Raw stock (ST) and fabricated parts | ST2 | 6 | 6061 plate 6 mm: 2× 80 × 140, 4× 70 × 60 (US imperial: 1/4 in = 6.35 mm; re-measure the P2 stack and D10 height, 4.3) | P2, P3, P6 | 15 | B | 20.99 | Speedy Metals | 6061-T651 plate 1/4 in (6.35 mm), 12x12 in | https://speedymetals.com/pc-2408-8360-14-6061-t651-aluminum-plate.aspx | 59.51 | Amazon (ZOFORTY store) | 6061-T6 plate 6x6 in x 6 mm (0.236 in), 2-pack | https://www.amazon.com/dp/B0B4DV12NK | 20.99 | Each 152x152 budget sheet gives 1x 80x140 + 2x 70x60; 2 sheets cover all 6 parts. The 1/4 in plate is +0.35 mm over 6 mm; recheck the P2 stack and the D10 nut-centre height (step 4.3). The budget sheet is true 6 mm.
A+B | Raw stock (ST) and fabricated parts | ST3 | 120 mm | Alu angle 30×30×3 | P4 | 2 | Q | 5.15 | Speedy Metals | 6061-T6 angle 1-1/4 x 1-1/4 x 1/8 in, 12 in | https://speedymetals.com/pc-2182-8344-1-14-x-1-14-angle-6061-t6-aluminum-extruded.aspx | 5.15 | Amazon (SHOUCAN) | 6061 angle 30x30x3 mm x 500 mm (metric exact) | https://www.amazon.com/dp/B0CRHKLVC8 | 38.99 | Imperial 31.75x3.18 mm vs 30x3 spec; fine for P4. The budget listing is metric-exact but more expensive. Speedy also cuts by the inch ($0.29/in).
A+B | Raw stock (ST) and fabricated parts | ST4 | 150 mm | Alu angle 20×20×2 | P5 | 2 | Q | 3.02 | Speedy Metals | 6061-T6 angle 3/4 x 3/4 x 1/8 in, 12 in | https://speedymetals.com/pc-2180-8344-18-a-x-34-b-x-34-c-angle-6061-t6-aluminum-extruded.aspx | 3.02 | Home Depot (Everbilt) | Aluminum angle 3/4 in x 3 ft x 1/8 in (model 6405) | https://homedepot.com/p/Everbilt-3-4-in-x-3-ft-1-8-in-Thick-Aluminum-Angle-6405/332734017 | 11.63 | Spec is 20x20x2. US stock is 19.05 mm with 1/8 in (3.2 mm) or 1/16 in (1.6 mm, HD model 6425, $6.60). Check P5's hole edge distances with 3.2 mm. Home Depot avoids shipping (local pickup, alloy usually 6063).
A+B | Raw stock (ST) and fabricated parts | ST5 | 70 mm | 6061 bar 20×20 | Tip blocks | 2 | Q | 9.37 | Speedy Metals | 6061-T6511 square bar 3/4 in (19.05 mm), 12 in | https://speedymetals.com/pc-2496-8378-34-sq-6061-t6511-aluminum-extruded.aspx | 9.37 | Amazon (SSCZRAI) | 6061-T6 square bar 20x20x100 mm (metric exact) | https://www.amazon.com/dp/B0F1F8FY4Y | 18.81 | Need 70 mm (makes H3). 19.05 mm is fine for the tip blocks. Speedy by-the-inch is $0.52/in. The metric budget bar is more expensive and listed at +/-5 mm cut tolerance.
