andres/wingcut-fluidnc/bom/cart-variant-A.csv

line_id | source | seller | item_title | exact_variant | qty | pack_note | unit_price_usd | line_total_usd | shipping_usd | link | verified_live | notes
PW1 | AUTH | TRC Electronics | Mean Well LRS-100-24 | 24 V 4.5 A | 1 |  | 16.48 | 16.48 | 0 | https://www.trcelectronics.com/products/mean-well-lrs-100-24 | yes | Mean Well authorised distributor; price from TRC store JSON, in stock. Shipping in SHIP-TRC.
PW2 | AUTH | TRC Electronics | Mean Well LRS-150F-48 | 48 V 3.3 A, F version (no 115/230 switch) | 1 |  | 25.51 | 25.51 | 0 | https://www.trcelectronics.com/products/mean-well-lrs-150f-48 | yes | Authorised; available. Digi-Key does not list LRS-150F-48, so PSUs stay at TRC.
PW3 | AUTH | Digi-Key | Sensata-Crydom DC60S7 (CC1128-ND) | DC60S7, 3-60 VDC 7 A | 1 |  | 54.16 | 54.16 | 0 | https://www.digikey.com/en/products/detail/sensata-crydom/DC60S7/221846 | yes | 554 in stock. Digi-Key says a tariff may be added in cart for US delivery.
PW5 | AUTH | Digi-Key | Schneider Harmony XB5 E-stop: ZB5AS844 head + ZB5AZ009 collar + 2x ZBE102 (NC1 L, NC2 N) + ZBE1026 gold NC3 | ZB5AS844 $67.99 + ZB5AZ009 $3.97 + 2x ZBE102 $12.05 + ZBE1026 $24.11 | 1 | 5 parts | 120.17 | 120.17 | 0 | https://www.digikey.com/en/products/detail/schneider-electric/ZB5AS844/16613290 | yes | Cheaper than XB5AS8442 + ZBE102 + ZBE1026 ($127.67). Collar takes 3 blocks. ZBE1026 is NOT stocked at Digi-Key: 7-week factory lead time, and the order ships when it arrives. Other links: https://www.digikey.com/en/products/detail/schneider-electric/ZB5AZ009/16614591 ; https://www.digikey.com/en/products/detail/schneider-electric/ZBE102/16614613 ; https://www.digikey.com/en/products/detail/schneider-electric/ZBE1026/16613570
PW6 | AUTH | Digi-Key | Schurter DD11.0111.1111 IEC C14 inlet, switch, 5x20 fuse holder | DD11.0111.1111 | 1 |  | 16.04 | 16.04 | 0 | https://www.digikey.com/en/products/detail/schurter-inc/DD11-0111-1111/1646862 | yes | 135 in stock.
PW7 | AUTH | Digi-Key | Schurter 0034.3125 fuse 5x20 T6.3 A 250 VAC | T6.3 A (US 115 V build) | 5 | qty-5 price break | 0.664 | 3.32 | 0 | https://www.digikey.com/en/products/detail/schurter-inc/0034-3125/639703 | yes | 28,106 in stock. For 230 V use T3.15 A.
PW9 | AUTH | Digi-Key | F2: Littelfuse FHAC0001ZXJ inline ATO holder + 4x 0287005.PXCN 5 A; F3: Littelfuse 01500274Z inline 5x20 holder + 4x Schurter 0034.3123 T4 A | $7.37 + 4x$0.44 + $4.00 + 4x$0.79 | 2 | 2 holders + 8 fuses (1 fitted + 3 spare each) | 8.145 | 16.29 | 0 | https://www.digikey.com/en/products/detail/littelfuse-commercial-vehicle-products/FHAC0001ZXJ/2004062 | yes | All in stock. Other links: https://www.digikey.com/en/products/detail/littelfuse-inc/0287005-PXCN/2519811 ; https://www.digikey.com/en/products/detail/littelfuse-inc/01500274Z/29453 ; https://www.digikey.com/en/products/detail/schurter-inc/0034-3123/639683
CC2 | AUTH | Digi-Key | Omron D2F-01L3 gold-contact roller microswitch | D2F-01L3 | 5 |  | 2.35 | 11.75 | 0 | https://www.digikey.com/en/products/detail/aratas-formerly-omron-components/D2F-01L3/368448 | yes | 17,396 in stock.
CC9 | AUTH | Digi-Key | WAGO 221-415 lever connector | 221-415 | 3 |  | 1.17 | 3.51 | 0 | https://www.digikey.com/en/products/detail/wago-corporation/221-415/13549457 | yes | 243,877 in stock.
VA1 | AUTH | Elecrow | FluidNC 4x CNC Controller (ESP32 + 4x TMC2209), SKU CQA231222CC | ask for v1.1 | 1 |  | 49.0 | 49.0 | 0 | https://www.elecrow.com/4x-cnc-controller-integrated-esp32-and-tmc2209.html | yes | Price live, but OUT OF STOCK on 2026-11-08 (Get notified). Ships from China; shipping and duty are estimated in SHIP-Elecrow and DUTY-ELECROW.
FR8 | LOCAL | Lowe's (Sterling VA store) | 3/4 in x 4 ft x 8 ft sanded MDF + Minwax Fast-Drying Polyurethane satin 1 qt | full 4x8 sheet (1300x700 cut) + 1 qt oil PU | 1 |  | 68.96 | 68.96 | 0 | https://www.lowes.com/pd/MDF-Actual-0-745-in-x-48-92-in-x-8-07-ft/1000344499 | no | Store price at Lowe's Sterling VA: MDF $49.98 + PU $18.98 (https://www.lowes.com/pd/Minwax-32-fl-oz-Satin-Oil-Based-Polyurethane/999914537). Per-store pricing; pickup, no shipping. Ask the store to rip it to 700 mm.
FR10 | LOCAL | Lowe's (Sterling VA store) | Gorilla 1.41 in x 8 yd double-sided tape | 8 yd roll | 1 |  | 8.98 | 8.98 | 0 | https://www.lowes.com/pd/Gorilla-1-41-in-x-8-Yard-s-Double-Sided-Tape/5003091145 | no | Store price, per-store. Steel offcuts (scrap), T-pins and scrap-foam spacers are not bought.
H3 | MADE | - | Tip blocks (made from ST5) | 20x20x30 alu | 2 |  | 0 | 0 | 0 |  | n/a | Made, not bought.
FR1 | ALI | AliExpress: SucceBuy Prime Tools Store (US warehouse) | SucceBuy T-slot 2040 aluminium extrusion, 10 PCS x 2000 mm (US warehouse) | 10 PCS 2000mm / United States (SKU 12000061344271725) | 1 | 1 pack of 10x2000 mm covers FR1-FR4 + FR11 + FX12 offcuts | 131.59 | 131.59 | 0 | https://www.aliexpress.us/item/3256813342370233.html | yes | Live item data: $131.59 sale price (not a welcome deal; max 1 per shopper at this price), 12 in stock, free FedEx/UPS Ground from US, 4-11 days, no import charge. Cut plan: 2x(1900) / 4x(1250 + 500, 500, 250, -) leaves 4 spare bars. Euro 2040 T-slot (6 mm slot): confirm the slot width on delivery.
FR2 | ALI | AliExpress: SucceBuy Prime Tools Store (US warehouse) | (from the FR1 pack: 10x2000 mm 2040) | X-beams 2x1250 | 0 | in FR1 pack | 0 | 0 | 0 | https://www.aliexpress.us/item/3256813342370233.html | yes | Cost counted in FR1. FR11's 4 M5 T-nuts come from FR6 spares.
FR3 | ALI | AliExpress: SucceBuy Prime Tools Store (US warehouse) | (from the FR1 pack: 10x2000 mm 2040) | bed supports 2x1250 | 0 | in FR1 pack | 0 | 0 | 0 | https://www.aliexpress.us/item/3256813342370233.html | yes | Cost counted in FR1. FR11's 4 M5 T-nuts come from FR6 spares.
FR4 | ALI | AliExpress: SucceBuy Prime Tools Store (US warehouse) | (from the FR1 pack: 10x2000 mm 2040) | tower posts 2x500 from 1250 offcuts | 0 | in FR1 pack | 0 | 0 | 0 | https://www.aliexpress.us/item/3256813342370233.html | yes | Cost counted in FR1. FR11's 4 M5 T-nuts come from FR6 spares.
FR11 | ALI | AliExpress: SucceBuy Prime Tools Store (US warehouse) | (from the FR1 pack: 10x2000 mm 2040) | 250 mm box rail from offcut | 0 | in FR1 pack | 0 | 0 | 0 | https://www.aliexpress.us/item/3256813342370233.html | yes | Cost counted in FR1. FR11's 4 M5 T-nuts come from FR6 spares.
FR5 | ALI | AliExpress: MS N Metal fittings Store | 2040 cast corner bracket (aluminium L connector) | 2040 / 20pcs ($9.03) + 2040 / 5pcs ($6.26) | 24 | 25 pcs (packs of 20 + 5) | 0.612 | 15.29 | 0 | https://www.aliexpress.us/item/3256803126822943.html | yes | Live item data (sale price, not welcome deal). Bracket only: M5 screws from FX1, T-nuts from FR6. Shipping in SHIP row ($4.58 live). Non-Choice: AliExpress import tax rate 59%.
R1 | ALI | AliExpress Choice: Shop1102642749 Store (Riden) | RD RIDEN RD6006 60V DC step-down bench power supply | RD6006 (USB, no WiFi, no case/PSU) - SKU 12000038644836105 | 1 |  | 59.99 | 59.99 | 0 | https://www.aliexpress.us/item/3256806709143589.html | yes | Live item data, Choice (import charges included). $59.99 is a NEW-SHOPPER welcome-deal price (max 1 per shopper). For an existing account, expect about $91.60 (other RD6006 SKU on this listing) to $94.49 (non-welcome listing 3256812914862656): +$31.61 to +$34.50. Only 5 left at this price.
PW4 | ALI | AliExpress Choice (combined order, several Choice sellers) | SSR heatsink (40 A class, 2,000+ sold) + thermal pad | single-phase SSR heatsink + 1 pad | 1 |  | 4.5 | 4.5 | 0 | https://www.aliexpress.us/item/3256805650790412.html | no | Not K/W rated: expect about 2.5-3.5 K/W. Pad is extra. Item page and its data API were CAPTCHA-blocked after the first 13 item lookups, so the exact-variant price is an estimate from the search card (default-SKU price shown) and typical non-welcome-deal pricing.
PW8 | ALI | AliExpress Choice (combined order, several Choice sellers) | NEMA 5-15P to IEC C13 power cord, 18 AWG | 1.5 m, US plug | 1 |  | 3.5 | 3.5 | 0 | https://www.aliexpress.us/item/3256801683780070.html | no | Not UL-listed. A mains cord is a safety part: a UL-listed cord at a hardware store (about $6-8) is the better buy. Item page and its data API were CAPTCHA-blocked after the first 13 item lookups, so the exact-variant price is an estimate from the search card (default-SKU price shown) and typical non-welcome-deal pricing.
PW10 | ALI | AliExpress Choice (combined order, several Choice sellers) | PZEM-031 DC meter, 20 A built-in shunt, 8-100 V | PZEM-031 20A built-in shunt | 1 |  | 9.0 | 9.0 | 0 | https://www.aliexpress.us/item/3256809999186422.html | no | Search showed $6.54 as a welcome deal. Item page and its data API were CAPTCHA-blocked after the first 13 item lookups, so the exact-variant price is an estimate from the search card (default-SKU price shown) and typical non-welcome-deal pricing.
PW11 | ALI | AliExpress: other non-Choice CN sellers | RX24 100 W aluminium-clad wirewound resistor | 22R 100W | 1 |  | 3.0 | 3.0 | 0 | https://www.aliexpress.us/item/3256806980591158.html | no | Pick the 22R variant. Item page and its data API were CAPTCHA-blocked after the first 13 item lookups, so the exact-variant price is an estimate from the search card (default-SKU price shown) and typical non-welcome-deal pricing.
PW12 | ALI | AliExpress: other non-Choice CN sellers | IP54 powder-coated steel electrical panel box with mounting plate | about 400x300x150 mm | 1 |  | 48.0 | 48.0 | 0 | https://www.aliexpress.us/item/3256813013183556.html | no | No exact 400x300x150 steel box with a plate was confirmed live. Assume about 8 kg shipped from China (+$30 est. in SHIP-ALI-OTHER). This is the least certain line. Item page and its data API were CAPTCHA-blocked after the first 13 item lookups, so the exact-variant price is an estimate from the search card (default-SKU price shown) and typical non-welcome-deal pricing.
PW13 | ALI | AliExpress Choice (combined order, several Choice sellers) | Round louvered ABS vent cover | about 50 mm | 2 |  | 2.0 | 4.0 | 0 | https://www.aliexpress.us/item/3256807278374796.html | no | Item page and its data API were CAPTCHA-blocked after the first 13 item lookups, so the exact-variant price is an estimate from the search card (default-SKU price shown) and typical non-welcome-deal pricing.
PW14 | ALI | AliExpress Choice (combined order, several Choice sellers) | DIN set: 20x UK2.5B feed-through (pack) + end stops + jumpers + 35 mm rail 300 mm (GEYA 3256812550480568) + 12-hole 6x9 ground bar (3256809902885546) + marker strip | UK2.5B x20, rail 30 cm, 12-hole bar | 1 | UK2.5B sold in 10s: 20 bought for 14 | 17.3 | 17.3 | 0 | https://www.aliexpress.us/item/3256813264788833.html | no | Item page and its data API were CAPTCHA-blocked after the first 13 item lookups, so the exact-variant price is an estimate from the search card (default-SKU price shown) and typical non-welcome-deal pricing.
PW15 | ALI | AliExpress Choice (combined order, several Choice sellers) | Nylon IP68 cable glands | M16 pack + M12 pack | 7 | 2 packs of 10 (M16 and M12) | 0.43 | 3.0 | 0 | https://www.aliexpress.us/item/3256802906936690.html | no | Check the M12 seal range covers 2-5 mm. Item page and its data API were CAPTCHA-blocked after the first 13 item lookups, so the exact-variant price is an estimate from the search card (default-SKU price shown) and typical non-welcome-deal pricing.
PW16 | ALI | AliExpress Choice (combined order, several Choice sellers) | UF5404 fast-recovery diode | UF5404 | 2 | pack of 10 | 0.75 | 1.5 | 0 | https://www.aliexpress.us/item/3256802829710734.html | no | Item page and its data API were CAPTCHA-blocked after the first 13 item lookups, so the exact-variant price is an estimate from the search card (default-SKU price shown) and typical non-welcome-deal pricing.
PW17 | ALI | AliExpress Choice (combined order, several Choice sellers) | M4 screw/nut kit + external-tooth star washer assortment | M4x10, M4 nuts, M4/M5 star washers | 1 | kits | 6.5 | 6.5 | 0 | https://www.aliexpress.us/item/3256806984878598.html | no | M3x5 for the PSUs comes from FX7. Item page and its data API were CAPTCHA-blocked after the first 13 item lookups, so the exact-variant price is an estimate from the search card (default-SKU price shown) and typical non-welcome-deal pricing.
CC1 | ALI | AliExpress Choice (combined order, several Choice sellers) | ADuM3160 USB isolator, 1500 V, enclosed | boxed USB-B/A | 1 |  | 9.0 | 9.0 | 0 | https://www.aliexpress.us/item/3256807448643844.html | no | Search card shows $3.33 (likely bare-board SKU). Confirm the enclosure and USB-B or A-male upstream. Item page and its data API were CAPTCHA-blocked after the first 13 item lookups, so the exact-variant price is an estimate from the search card (default-SKU price shown) and typical non-welcome-deal pricing.
CC3 | ALI | AliExpress: other non-Choice CN sellers | 100 nF 50 V ceramic capacitor | 104 50V | 10 | pack of 100 | 0.012 | 1.2 | 0 | https://www.aliexpress.us/item/3256802104127109.html | no | Item page and its data API were CAPTCHA-blocked after the first 13 item lookups, so the exact-variant price is an estimate from the search card (default-SKU price shown) and typical non-welcome-deal pricing.
CC4 | ALI | AliExpress Choice (combined order, several Choice sellers) | USB-C male-to-female panel-mount extension (screw lock) | 30 cm | 1 |  | 3.0 | 3.0 | 0 | https://www.aliexpress.us/item/3256810454791234.html | no | Not the Adafruit 4218: not a 22 mm round nut. Edit the case hole. Item page and its data API were CAPTCHA-blocked after the first 13 item lookups, so the exact-variant price is an estimate from the search card (default-SKU price shown) and typical non-welcome-deal pricing.
CC5 | ALI | AliExpress Choice (combined order, several Choice sellers) | USB-A to USB-B 0.5 m + USB-A to USB-C 2 m data cable (3256812800457352) | 0.5 m A-B + 2 m A-C | 1 | 2 cables | 4.25 | 4.25 | 0 | https://www.aliexpress.us/item/3256811827645945.html | no | Item page and its data API were CAPTCHA-blocked after the first 13 item lookups, so the exact-variant price is an estimate from the search card (default-SKU price shown) and typical non-welcome-deal pricing.
CC6 | ALI | AliExpress Choice (combined order, several Choice sellers) | 2.4 GHz antenna + U.FL to SMA bulkhead pigtail (matched pair) | 2.4 GHz 3 dBi + 17 cm pigtail | 1 |  | 2.5 | 2.5 | 0 | https://www.aliexpress.us/item/3256809949110368.html | no | Usually included with the board. Buy a matched pair (both RP-SMA or both SMA). Item page and its data API were CAPTCHA-blocked after the first 13 item lookups, so the exact-variant price is an estimate from the search card (default-SKU price shown) and typical non-welcome-deal pricing.
CC7 | ALI | AliExpress Choice (combined order, several Choice sellers) | M3 brass heat-set inserts + M4x30 screws/nuts | M3 x 5.7 inserts (50 pk) + M4x30 | 1 | pack of 50 inserts | 3.5 | 3.5 | 0 | https://www.aliexpress.us/item/3256806781024975.html | no | M3x6/8, M5x10, washers and T-nuts come from FX/FR lines. Item page and its data API were CAPTCHA-blocked after the first 13 item lookups, so the exact-variant price is an estimate from the search card (default-SKU price shown) and typical non-welcome-deal pricing.
CC8 | ALI | AliExpress: US-warehouse seller (filament) | LANDU PETG 1.75 mm 1 kg (US warehouse) | black 1 kg | 1 | 1 kg spool (BOM needs 0.5 kg) | 13.25 | 13.25 | 0 | https://www.aliexpress.us/item/3256813273315969.html | no | US stock, so no import charge. Shipping assumed free (not confirmed). Item page and its data API were CAPTCHA-blocked after the first 13 item lookups, so the exact-variant price is an estimate from the search card (default-SKU price shown) and typical non-welcome-deal pricing.
VA2 | ALI | AliExpress Choice (combined order, several Choice sellers) | 8025 24 V DC fan | 80x80x25 24 V | 1 |  | 3.5 | 3.5 | 0 | https://www.aliexpress.us/item/3256811431343567.html | no | Check the current (about 0.1 A). Item page and its data API were CAPTCHA-blocked after the first 13 item lookups, so the exact-variant price is an estimate from the search card (default-SKU price shown) and typical non-welcome-deal pricing.
VA3 | ALI | AliExpress Choice (combined order, several Choice sellers) | M16x1.5 polyamide cable gland, 5-10 mm | M16x1.5 white | 12 | 2 packs of 10 (20 pcs; 1 spare goes to R4) | 0.465 | 9.3 | 0 | https://www.aliexpress.us/item/3256813146380806.html | no | Range is 5-10 mm, not 4.5-10: fine for 5-7 mm TRVVP. Item page and its data API were CAPTCHA-blocked after the first 13 item lookups, so the exact-variant price is an estimate from the search card (default-SKU price shown) and typical non-welcome-deal pricing.
CB1 | ALI | AliExpress: other non-Choice CN sellers | TRVVP drag-chain shielded cable 4x0.5 mm2 | 4 core 0.5 mm2, 20 m | 18 | sold per metre / 20 m | 1.45 | 26.0 | 0 | https://www.aliexpress.us/item/3256804585223639.html | no | Item page and its data API were CAPTCHA-blocked after the first 13 item lookups, so the exact-variant price is an estimate from the search card (default-SKU price shown) and typical non-welcome-deal pricing.
CB2 | ALI | AliExpress: other non-Choice CN sellers | TRVVP drag-chain shielded cable 3x0.3 mm2 | 3 core 0.3 mm2, 15 m | 15 | per metre | 0.9 | 13.5 | 0 | https://www.aliexpress.us/item/3256804585223639.html | no | Same store as CB1. Item page and its data API were CAPTCHA-blocked after the first 13 item lookups, so the exact-variant price is an estimate from the search card (default-SKU price shown) and typical non-welcome-deal pricing.
CB3 | ALI | AliExpress Choice (combined order, several Choice sellers) | Silicone wire 18 AWG | 5 m red + 10 m black | 11 | 5 m and 10 m lengths | 0.64 | 7.0 | 0 | https://www.aliexpress.us/item/3256810559707449.html | no | 18 AWG = 0.82 mm2 (1.0 mm2 is uncommon). Item page and its data API were CAPTCHA-blocked after the first 13 item lookups, so the exact-variant price is an estimate from the search card (default-SKU price shown) and typical non-welcome-deal pricing.
CB4 | ALI | AliExpress: other non-Choice CN sellers | UL1007 18 AWG PVC hook-up wire | brown, blue, green/yellow (or green) 5 m each | 3 | 5 m reels | 1.8 | 5.4 | 0 | https://www.aliexpress.us/item/3256806190705373.html | no | Not H07V-K. Use GN/YE from CB8 if no striped colour. Item page and its data API were CAPTCHA-blocked after the first 13 item lookups, so the exact-variant price is an estimate from the search card (default-SKU price shown) and typical non-welcome-deal pricing.
CB5 | ALI | AliExpress: other non-Choice CN sellers | UL1007 18 AWG PVC hook-up wire | red, black, orange 5 m each | 3 | 5 m reels | 1.8 | 5.4 | 0 | https://www.aliexpress.us/item/3256806190705373.html | no | Item page and its data API were CAPTCHA-blocked after the first 13 item lookups, so the exact-variant price is an estimate from the search card (default-SKU price shown) and typical non-welcome-deal pricing.
CB6 | ALI | AliExpress: other non-Choice CN sellers | UL1007 20 AWG PVC hook-up wire | red, black 5 m each | 2 | 5 m reels | 1.47 | 2.94 | 0 | https://www.aliexpress.us/item/3256806190705373.html | no | Item page and its data API were CAPTCHA-blocked after the first 13 item lookups, so the exact-variant price is an estimate from the search card (default-SKU price shown) and typical non-welcome-deal pricing.
CB7 | ALI | AliExpress Choice (combined order, several Choice sellers) | 5-colour silicone hook-up wire kit | 24 AWG | 1 | kit | 1.56 | 1.56 | 0 | https://www.aliexpress.us/item/3256813237418074.html | no | 24 AWG = 0.20 mm2. Item page and its data API were CAPTCHA-blocked after the first 13 item lookups, so the exact-variant price is an estimate from the search card (default-SKU price shown) and typical non-welcome-deal pricing.
CB8 | ALI | AliExpress: other non-Choice CN sellers | UL3135 14 AWG yellow-green silicone wire 10 m + 20 AWG yellow-green 5 m (3256813077831116) | 14 AWG GN/YE 10 m + 20 AWG GN/YE 5 m | 1 | 10 m + 5 m | 24.0 | 24.0 | 0 | https://www.aliexpress.us/item/3256812762618074.html | no | Ring lugs from CB12; star washers from PW17. Item page and its data API were CAPTCHA-blocked after the first 13 item lookups, so the exact-variant price is an estimate from the search card (default-SKU price shown) and typical non-welcome-deal pricing.
CB9 | ALI | AliExpress: other non-Choice CN sellers | MHTNC bridge-type semi-enclosed drag chain with end brackets | 15x20 R48, 1 m | 2 |  | 7.5 | 15.0 | 0 | https://www.aliexpress.us/item/3256802141983298.html | no | Listing offers R48. Check it opens and its inner height is about 15 mm. Item page and its data API were CAPTCHA-blocked after the first 13 item lookups, so the exact-variant price is an estimate from the search card (default-SKU price shown) and typical non-welcome-deal pricing.
CB10 | ALI | AliExpress Choice (combined order, several Choice sellers) | Spiral wrap 10 mm 5 m + 20 nylon P-clips (3256813325871502) | 10 mm x 5 m + P-clips | 1 | 5 m + 20 pcs | 4.5 | 4.5 | 0 | https://www.aliexpress.us/item/3256812370142985.html | no | Item page and its data API were CAPTCHA-blocked after the first 13 item lookups, so the exact-variant price is an estimate from the search card (default-SKU price shown) and typical non-welcome-deal pricing.
CB11 | ALI | AliExpress Choice (combined order, several Choice sellers) | Ferrule kit 1200 pcs with crimper | 0.25-1.5 mm2 + crimper | 1 | kit | 7.33 | 7.33 | 0 | https://www.aliexpress.us/item/3256809687904773.html | no | Check it includes 0.25 mm2 and twin ferrules. Item page and its data API were CAPTCHA-blocked after the first 13 item lookups, so the exact-variant price is an estimate from the search card (default-SKU price shown) and typical non-welcome-deal pricing.
CB12 | ALI | AliExpress Choice (combined order, several Choice sellers) | Insulated ring terminal assortment M3-M8, 22-10 AWG | 220 pcs | 1 | kit | 2.5 | 2.5 | 0 | https://www.aliexpress.us/item/3256811556672787.html | no | Item page and its data API were CAPTCHA-blocked after the first 13 item lookups, so the exact-variant price is an estimate from the search card (default-SKU price shown) and typical non-welcome-deal pricing.
CB13 | ALI | AliExpress Choice (combined order, several Choice sellers) | Heat-shrink kit 400 pcs, 3:1 adhesive-lined | 400 pcs | 1 | kit | 9.49 | 9.49 | 0 | https://www.aliexpress.us/item/3256808746119728.html | no | Search card $9.49 is not a welcome deal. Item page and its data API were CAPTCHA-blocked after the first 13 item lookups, so the exact-variant price is an estimate from the search card (default-SKU price shown) and typical non-welcome-deal pricing.
CB14 | ALI | AliExpress Choice (combined order, several Choice sellers) | T-slot cable saddles 50 pcs + 100 cable ties with mounts (3256813019189790) + labels | 50 + 100 + labels | 1 | packs | 6.15 | 6.15 | 0 | https://www.aliexpress.us/item/3256809694138608.html | no | Check the saddle fits the 6 mm slot. Item page and its data API were CAPTCHA-blocked after the first 13 item lookups, so the exact-variant price is an estimate from the search card (default-SKU price shown) and typical non-welcome-deal pricing.
CB15 | ALI | AliExpress Choice (combined order, several Choice sellers) | 63/37 rosin-core solder 0.8 mm | 50-100 g | 1 |  | 3.5 | 3.5 | 0 | https://www.aliexpress.us/w/wholesale-solder-wire-63-37.html | no | No listing captured before the block; price is an estimate. Item page and its data API were CAPTCHA-blocked after the first 13 item lookups, so the exact-variant price is an estimate from the search card (default-SKU price shown) and typical non-welcome-deal pricing.
CB16 | ALI | AliExpress Choice (combined order, several Choice sellers) | 2-core red/black tinned-copper wire 18 AWG | 5 m | 1 | 5 m | 3.0 | 3.0 | 0 | https://www.aliexpress.us/item/3256807449915775.html | no | Avoid CCA. 18 AWG = 0.82 mm2. Item page and its data API were CAPTCHA-blocked after the first 13 item lookups, so the exact-variant price is an estimate from the search card (default-SKU price shown) and typical non-welcome-deal pricing.
FR6 | ALI | AliExpress Choice (combined order, several Choice sellers) | M5 drop-in T-nut for 20 series (10x6) | M5, 100 + 50 pcs | 150 | packs of 100 + 50 | 0.047 | 7.0 | 0 | https://www.aliexpress.us/item/3256807521452944.html | no | Item page and its data API were CAPTCHA-blocked after the first 13 item lookups, so the exact-variant price is an estimate from the search card (default-SKU price shown) and typical non-welcome-deal pricing.
FR7 | ALI | AliExpress Choice (combined order, several Choice sellers) | M3 drop-in T-nut for 20 series | M3, 100 pcs | 100 | pack of 100 | 0.04 | 4.0 | 0 | https://www.aliexpress.us/item/3256807521452944.html | no | Item page and its data API were CAPTCHA-blocked after the first 13 item lookups, so the exact-variant price is an estimate from the search card (default-SKU price shown) and typical non-welcome-deal pricing.
FR9 | ALI | AliExpress Choice (combined order, several Choice sellers) | Rubber anti-vibration feet | 4 pcs | 4 | pack of 4 | 0.9 | 3.59 | 0 | https://www.aliexpress.us/item/3256810520527656.html | no | Search card $3.59 is not a welcome deal (default SKU). Item page and its data API were CAPTCHA-blocked after the first 13 item lookups, so the exact-variant price is an estimate from the search card (default-SKU price shown) and typical non-welcome-deal pricing.
M1 | ALI | AliExpress: STEPPERONLINE (US warehouse) | STEPPERONLINE 17HS19-2004S1 NEMA17 59 Ncm 2 A, 1 m lead (US warehouse) | 5PCS pack | 5 | pack of 5 | 12.4 | 62.0 | 0 | https://www.aliexpress.us/item/2255801082427364.html | no | Search card shows $51.89 as a welcome deal; $62 is the estimated regular price. US stock: no import charge; shipping assumed free. Item page and its data API were CAPTCHA-blocked after the first 13 item lookups, so the exact-variant price is an estimate from the search card (default-SKU price shown) and typical non-welcome-deal pricing.
L1 | ALI | AliExpress: pmgn Official Store | MGN12 rail 1200 mm + MGN12H block, plus 2x extra MGN12H blocks (pmgn 3256802671554980, live $14.91/2 pcs) | MGN12H / 1200mm (x2) + Only 2pcs Block MGN12 H | 2 | 2 rails with 1 block each + 1 pair of blocks | 39.455 | 78.91 | 0 | https://www.aliexpress.us/item/3256808740219943.html | no | The block pair price ($14.91) is live from item data. The 1200 mm rail is estimated at $32 each (cached data only shows up to 1000 mm: $59.40 welcome). Same store as the blocks, so the preload should match. Free standard shipping (live). Item page and its data API were CAPTCHA-blocked after the first 13 item lookups, so the exact-variant price is an estimate from the search card (default-SKU price shown) and typical non-welcome-deal pricing.
L2 | ALI | AliExpress: pmgn Official Store | MGN12 rail 400 mm + MGN12H block | MGN12H / 400mm | 2 |  | 16.0 | 32.0 | 0 | https://www.aliexpress.us/item/3256808740219943.html | no | Cached item data shows $11.32 for this SKU, but as a welcome deal; $16 is the estimated regular price. Item page and its data API were CAPTCHA-blocked after the first 13 item lookups, so the exact-variant price is an estimate from the search card (default-SKU price shown) and typical non-welcome-deal pricing.
L3 | ALI | AliExpress Choice (combined order, several Choice sellers) | Lithium grease for rails and lead screws | tube | 1 |  | 3.75 | 3.75 | 0 | https://www.aliexpress.us/item/3256811401010459.html | no | Item page and its data API were CAPTCHA-blocked after the first 13 item lookups, so the exact-variant price is an estimate from the search card (default-SKU price shown) and typical non-welcome-deal pricing.
D1 | ALI | AliExpress: other non-Choice CN sellers | GT2 6 mm open belt, rubber with fiberglass cords | 6 mm, 10 m, fiberglass | 1 | 10 m | 8.5 | 8.5 | 0 | https://www.aliexpress.us/item/3256812653656403.html | no | Not the PU/steel-core option. Item page and its data API were CAPTCHA-blocked after the first 13 item lookups, so the exact-variant price is an estimate from the search card (default-SKU price shown) and typical non-welcome-deal pricing.
D2 | ALI | AliExpress Choice (combined order, several Choice sellers) | GT2 20T timing pulley, 5 mm bore, 6 mm belt | 20T bore 5 mm, 5-pack | 3 | pack of 5 | 0.7 | 3.5 | 0 | https://www.aliexpress.us/item/2255801041554441.html | no | Item page and its data API were CAPTCHA-blocked after the first 13 item lookups, so the exact-variant price is an estimate from the search card (default-SKU price shown) and typical non-welcome-deal pricing.
D3 | ALI | AliExpress Choice (combined order, several Choice sellers) | GT2 20T toothed idler with bearings, 5 mm bore | 20T toothed, 5-pack | 3 | pack of 5 | 0.9 | 4.5 | 0 | https://www.aliexpress.us/item/3256807337695679.html | no | Toothed, not smooth. Item page and its data API were CAPTCHA-blocked after the first 13 item lookups, so the exact-variant price is an estimate from the search card (default-SKU price shown) and typical non-welcome-deal pricing.
D4 | ALI | AliExpress Choice (combined order, several Choice sellers) | Steel NEMA17 L-bracket | NEMA17 L | 4 |  | 2.2 | 8.8 | 0 | https://www.aliexpress.us/item/3256807277421410.html | no | Item page and its data API were CAPTCHA-blocked after the first 13 item lookups, so the exact-variant price is an estimate from the search card (default-SKU price shown) and typical non-welcome-deal pricing.
D5 | ALI | AliExpress Choice (combined order, several Choice sellers) | M5x40 A2 socket cap screws | M5x40, 10 pcs | 2 | pack of 10 | 0.15 | 1.5 | 0 | https://www.aliexpress.us/item/3256812503838403.html | no | Washers and nylocks from FX2. Item page and its data API were CAPTCHA-blocked after the first 13 item lookups, so the exact-variant price is an estimate from the search card (default-SKU price shown) and typical non-welcome-deal pricing.
D6 | ALI | AliExpress: other non-Choice CN sellers | GT2 6 mm belt fixing clamps | 10 pcs | 4 | pack of 10 | 0.1 | 1.02 | 0 | https://www.aliexpress.us/item/3256805472902912.html | no | Check the hole pattern against the P4 belt tab. Item page and its data API were CAPTCHA-blocked after the first 13 item lookups, so the exact-variant price is an estimate from the search card (default-SKU price shown) and typical non-welcome-deal pricing.
D7 | ALI | AliExpress Choice (combined order, several Choice sellers) | T8 lead screw, lead 2 mm (single start), with flanged brass nut | 400 mm | 2 |  | 5.5 | 11.0 | 0 | https://www.aliexpress.us/item/3256809367722838.html | no | Lead 2 mm is in the title. Check it is not T8x8. Item page and its data API were CAPTCHA-blocked after the first 13 item lookups, so the exact-variant price is an estimate from the search card (default-SKU price shown) and typical non-welcome-deal pricing.
D8 | ALI | AliExpress Choice (combined order, several Choice sellers) | Flexible coupler D19xL25 | 5 mm to 8 mm | 2 |  | 1.6 | 3.2 | 0 | https://www.aliexpress.us/item/3256810598169100.html | no | Item page and its data API were CAPTCHA-blocked after the first 13 item lookups, so the exact-variant price is an estimate from the search card (default-SKU price shown) and typical non-welcome-deal pricing.
D9 | ALI | AliExpress Choice (combined order, several Choice sellers) | KFL08 zinc pillow-block flange bearing | KFL08 8 mm | 2 |  | 1.5 | 3.0 | 0 | https://www.aliexpress.us/item/3256807026584088.html | no | Item page and its data API were CAPTCHA-blocked after the first 13 item lookups, so the exact-variant price is an estimate from the search card (default-SKU price shown) and typical non-welcome-deal pricing.
D10 | ALI | AliExpress Choice (combined order, several Choice sellers) | T8 screw-nut housing bracket (aluminium) | T8 | 2 |  | 3.33 | 6.66 | 0 | https://www.aliexpress.us/item/3256807453641926.html | no | Search card $3.33 is not a welcome deal. Check the 22 mm flange and 16 mm hole spacing. Item page and its data API were CAPTCHA-blocked after the first 13 item lookups, so the exact-variant price is an estimate from the search card (default-SKU price shown) and typical non-welcome-deal pricing.
H1 | ALI | AliExpress Choice (combined order, several Choice sellers) | Cr20Ni80 nichrome wire | 0.4 mm, 10 m | 1 | 10 m | 4.5 | 4.5 | 0 | https://www.aliexpress.us/item/3256806139746321.html | no | Item page and its data API were CAPTCHA-blocked after the first 13 item lookups, so the exact-variant price is an estimate from the search card (default-SKU price shown) and typical non-welcome-deal pricing.
H2 | ALI | AliExpress: other non-Choice CN sellers | MIG contact tip M6x25 CuCrZr | M6x25, 0.6 mm, CuCrZr, 10 pcs | 10 | pack of 10 | 0.65 | 6.5 | 0 | https://www.aliexpress.us/item/3256806188382802.html | no | Pick CuCrZr, M6x25 and 0.6 mm. Item page and its data API were CAPTCHA-blocked after the first 13 item lookups, so the exact-variant price is an estimate from the search card (default-SKU price shown) and typical non-welcome-deal pricing.
H4 | ALI | AliExpress: other non-Choice CN sellers | FR4/G10 epoxy fibreglass sheet | 5 mm, about 100x150 | 1 |  | 8.0 | 8.0 | 0 | https://www.aliexpress.us/item/3256808975330322.html | no | Item page and its data API were CAPTCHA-blocked after the first 13 item lookups, so the exact-variant price is an estimate from the search card (default-SKU price shown) and typical non-welcome-deal pricing.
H5 | ALI | AliExpress Choice (combined order, several Choice sellers) | POM V-wheel with 625ZZ | 625ZZ POM | 2 |  | 1.2 | 2.4 | 0 | https://www.aliexpress.us/item/2251832717258049.html | no | Item page and its data API were CAPTCHA-blocked after the first 13 item lookups, so the exact-variant price is an estimate from the search card (default-SKU price shown) and typical non-welcome-deal pricing.
H6 | ALI | AliExpress Choice (combined order, several Choice sellers) | Flat spiral constant-force spring | about 20 N, >=150 mm | 1 |  | 4.0 | 4.0 | 0 | https://www.aliexpress.us/item/3256811939895889.html | no | Size and force are not confirmed. Fallback: a 2 kg weight in a 50 mm PVC tube. Item page and its data API were CAPTCHA-blocked after the first 13 item lookups, so the exact-variant price is an estimate from the search card (default-SKU price shown) and typical non-welcome-deal pricing.
H7 | ALI | AliExpress: other non-Choice CN sellers | Braided Kevlar assist line | 150 lb (68 kg) | 2 | 5-10 m spool (2 m needed) | 1.25 | 2.5 | 0 | https://www.aliexpress.us/item/3256805132751698.html | no | Do not pick 100 lb. Item page and its data API were CAPTCHA-blocked after the first 13 item lookups, so the exact-variant price is an estimate from the search card (default-SKU price shown) and typical non-welcome-deal pricing.
H8 | ALI | AliExpress Choice (combined order, several Choice sellers) | Uninsulated copper crimp sleeve/ferrule, 1 mm2 tube | 100 pcs | 20 | pack of 100 | 0.015 | 1.5 | 0 | https://www.aliexpress.us/item/3256807254236066.html | no | Item page and its data API were CAPTCHA-blocked after the first 13 item lookups, so the exact-variant price is an estimate from the search card (default-SKU price shown) and typical non-welcome-deal pricing.
H9 | ALI | AliExpress: other non-Choice CN sellers | PA66 nylon M4 socket screws + nylon M4 nuts (3256809001731767) | M4 nylon | 4 | smallest packs | 0.75 | 3.0 | 0 | https://www.aliexpress.us/item/3256811739631735.html | no | Item page and its data API were CAPTCHA-blocked after the first 13 item lookups, so the exact-variant price is an estimate from the search card (default-SKU price shown) and typical non-welcome-deal pricing.
FX1 | ALI | AliExpress Choice (combined order, several Choice sellers) | A2 ISO7380 M5 button-head screws | M5x8, x10, x12, x16, 50 each | 150 | 4 packs of 50 | 0.06 | 12.0 | 0 | https://www.aliexpress.us/item/3256812404651604.html | no | Item page and its data API were CAPTCHA-blocked after the first 13 item lookups, so the exact-variant price is an estimate from the search card (default-SKU price shown) and typical non-welcome-deal pricing.
FX2 | ALI | AliExpress Choice (combined order, several Choice sellers) | M5 A2 flat washers 100 pcs + M4/M5/M6 nylock kit (3256811562525569) | M5 | 50 | 100 washers + kit | 0.1 | 5.0 | 0 | https://www.aliexpress.us/item/3256804581841734.html | no | Item page and its data API were CAPTCHA-blocked after the first 13 item lookups, so the exact-variant price is an estimate from the search card (default-SKU price shown) and typical non-welcome-deal pricing.
FX3 | ALI | AliExpress Choice (combined order, several Choice sellers) | M3 12.9 socket head cap screw + nut set (281 pcs) + 100x M3x8 | M3 6-20 mm | 200 | kit + pack | 0.03 | 6.0 | 0 | https://www.aliexpress.us/item/3256812221893034.html | no | Check the length against the MGN12H thread depth. Item page and its data API were CAPTCHA-blocked after the first 13 item lookups, so the exact-variant price is an estimate from the search card (default-SKU price shown) and typical non-welcome-deal pricing.
FX4 | ALI | AliExpress Choice (combined order, several Choice sellers) | M3 A2 flat washers | M3, 100 pcs | 50 | pack of 100 | 0.02 | 1.0 | 0 | https://www.aliexpress.us/item/3256804581841734.html | no | Item page and its data API were CAPTCHA-blocked after the first 13 item lookups, so the exact-variant price is an estimate from the search card (default-SKU price shown) and typical non-welcome-deal pricing.
FX5 | ALI | AliExpress Choice (combined order, several Choice sellers) | M4 socket cap screws 8-20 + M4 nuts + M4x12 DIN7991 (3256808320835151) | M4 | 34 | packs | 0.14 | 4.7 | 0 | https://www.aliexpress.us/item/3256808029033363.html | no | The 4x M4x12 countersunk are mandatory. Item page and its data API were CAPTCHA-blocked after the first 13 item lookups, so the exact-variant price is an estimate from the search card (default-SKU price shown) and typical non-welcome-deal pricing.
FX6 | ALI | AliExpress Choice (combined order, several Choice sellers) | 304 SS shoulder screw | M5 thread, 6 mm x 10 mm shoulder | 1 |  | 1.5 | 1.5 | 0 | https://www.aliexpress.us/item/3256812164053152.html | no | Item page and its data API were CAPTCHA-blocked after the first 13 item lookups, so the exact-variant price is an estimate from the search card (default-SKU price shown) and typical non-welcome-deal pricing.
FX7 | ALI | AliExpress Choice (combined order, several Choice sellers) | M3x5 screws | M3x5, 100 pcs | 8 | pack of 100 | 0.19 | 1.5 | 0 | https://www.aliexpress.us/item/3256810232847464.html | no | Keep <=4 mm thread engagement in the PSU. Item page and its data API were CAPTCHA-blocked after the first 13 item lookups, so the exact-variant price is an estimate from the search card (default-SKU price shown) and typical non-welcome-deal pricing.
FX8 | ALI | AliExpress Choice (combined order, several Choice sellers) | M2x12 A2 SHCS + M2 nuts | M2x12 | 8 | packs | 0.25 | 2.0 | 0 | https://www.aliexpress.us/item/3256812395281563.html | no | Item page and its data API were CAPTCHA-blocked after the first 13 item lookups, so the exact-variant price is an estimate from the search card (default-SKU price shown) and typical non-welcome-deal pricing.
FX9 | ALI | AliExpress Choice (combined order, several Choice sellers) | Threadlocker 243 medium | 10 g | 1 |  | 1.49 | 1.49 | 0 | https://www.aliexpress.us/item/3256812845039197.html | no | Search card $1.49 is not a welcome deal. Unbranded. Item page and its data API were CAPTCHA-blocked after the first 13 item lookups, so the exact-variant price is an estimate from the search card (default-SKU price shown) and typical non-welcome-deal pricing.
FX11 | ALI | AliExpress Choice (combined order, several Choice sellers) | DIN7991 M5x25 countersunk | M5x25, 10 pcs | 8 | pack of 10 | 0.15 | 1.5 | 0 | https://www.aliexpress.us/item/2251832782301811.html | no | Item page and its data API were CAPTCHA-blocked after the first 13 item lookups, so the exact-variant price is an estimate from the search card (default-SKU price shown) and typical non-welcome-deal pricing.
FX12 | ALI | AliExpress: other non-Choice CN sellers | Aluminium unthreaded bushing M5, 30 mm | M5 x 30 mm, 4 pcs | 4 | pack of 5-10 | 0.75 | 3.0 | 0 | https://www.aliexpress.us/item/3256805912989349.html | no | Offcuts come from the spare 2040 bars (not 2020). The M5x40-45 screws needed are not in the BOM. Item page and its data API were CAPTCHA-blocked after the first 13 item lookups, so the exact-variant price is an estimate from the search card (default-SKU price shown) and typical non-welcome-deal pricing.
ST1 | ALI | AliExpress: other non-Choice CN sellers | 6061 aluminium plate | 8 mm, 200x300 (gives both 160x130 blanks) | 1 | 1 sheet | 22.0 | 22.0 | 0 | https://www.aliexpress.us/item/3256810359271636.html | no | Section 232 aluminium: the import tax rate shown is high. Item page and its data API were CAPTCHA-blocked after the first 13 item lookups, so the exact-variant price is an estimate from the search card (default-SKU price shown) and typical non-welcome-deal pricing.
ST2 | ALI | AliExpress: other non-Choice CN sellers | 6061 aluminium plate | 6 mm, 200x300 (2x 80x140 + 4x 70x60) | 1 | 1 sheet | 17.0 | 17.0 | 0 | https://www.aliexpress.us/item/3256810359271636.html | no | Same store as ST1. Item page and its data API were CAPTCHA-blocked after the first 13 item lookups, so the exact-variant price is an estimate from the search card (default-SKU price shown) and typical non-welcome-deal pricing.
ST3 | ALI | AliExpress: other non-Choice CN sellers | 6061 aluminium angle 30x30x3 | 120-200 mm | 1 |  | 4.0 | 4.0 | 0 | https://www.aliexpress.us/w/wholesale-aluminum-angle-30x30x3-6061.html | no | No listing captured before the block. Item page and its data API were CAPTCHA-blocked after the first 13 item lookups, so the exact-variant price is an estimate from the search card (default-SKU price shown) and typical non-welcome-deal pricing.
ST4 | ALI | AliExpress: other non-Choice CN sellers | 6061 aluminium angle 20x20x2 | 150-200 mm | 1 |  | 3.0 | 3.0 | 0 | https://www.aliexpress.us/w/wholesale-aluminum-angle-20x20x2-6061.html | no | No listing captured before the block. Item page and its data API were CAPTCHA-blocked after the first 13 item lookups, so the exact-variant price is an estimate from the search card (default-SKU price shown) and typical non-welcome-deal pricing.
ST5 | ALI | AliExpress: other non-Choice CN sellers | 6061 aluminium square bar | 20x20, 100 mm | 1 |  | 4.5 | 4.5 | 0 | https://www.aliexpress.us/item/3256807687229075.html | no | Item page and its data API were CAPTCHA-blocked after the first 13 item lookups, so the exact-variant price is an estimate from the search card (default-SKU price shown) and typical non-welcome-deal pricing.
R2 | ALI | AliExpress Choice (combined order, several Choice sellers) | ADuM3160 USB isolator, 1500 V, enclosed (second, for Riden) | boxed | 1 |  | 9.0 | 9.0 | 0 | https://www.aliexpress.us/item/3256807448643844.html | no | Same as CC1. Item page and its data API were CAPTCHA-blocked after the first 13 item lookups, so the exact-variant price is an estimate from the search card (default-SKU price shown) and typical non-welcome-deal pricing.
R4 | ALI | AliExpress Choice (combined order, several Choice sellers) | Micro-USB cable 1 m (RD6006 port) + M16 gland from VA3 pack | micro-USB 1 m | 1 |  | 1.03 | 1.03 | 0 | https://www.aliexpress.us/item/3256803205252997.html | no | Search card $1.03 is not a welcome deal. Check the RD6006 port type. Item page and its data API were CAPTCHA-blocked after the first 13 item lookups, so the exact-variant price is an estimate from the search card (default-SKU price shown) and typical non-welcome-deal pricing.
SHIP-TRC | AUTH | TRC Electronics | UPS Ground flat rate (1-24 lb) |  | 1 |  | 9.99 | 0 | 9.99 | https://www.trcelectronics.com/policies/shipping-policy | yes | Flat rate, live policy page.
SHIP-DigiKey | AUTH | Digi-Key | USPS Ground Advantage flat rate |  | 1 |  | 4.99 | 0 | 4.99 | https://www.digikey.com/en/help-support/delivery-information/delivery-time-and-cost | yes | No free-shipping threshold for US orders (live page). UPS/FedEx Ground $8.49. Tariff surcharge, if any, shows in the cart. ZBE1026 backorder may hold the order: pay for a split shipment or wait.
SHIP-Elecrow | AUTH | Elecrow | International shipping from China (estimate) |  | 1 |  | 15.0 | 0 | 15.0 | https://www.elecrow.com/4x-cnc-controller-integrated-esp32-and-tmc2209.html | no | Board is out of stock, so it can't go in the cart. Estimate for a 450 g parcel.
SHIP-SucceBuy | ALI | AliExpress: SucceBuy Prime Tools Store (US warehouse) | FedEx/UPS Ground from US warehouse |  | 1 |  | 0 | 0 | 0 | https://www.aliexpress.us/item/3256813342370233.html | yes | Free (live item data).
SHIP-MSN | ALI | AliExpress: MS N Metal fittings Store | AliExpress standard shipping |  | 1 |  | 4.58 | 0 | 4.58 | https://www.aliexpress.us/item/3256803126822943.html | yes | Live for this listing (one charge per store order assumed).
SHIP-pmgn | ALI | AliExpress: pmgn Official Store | AliExpress standard shipping |  | 1 |  | 0 | 0 | 0 | https://www.aliexpress.us/item/3256802671554980.html | yes | Free standard shipping (live on both pmgn listings).
SHIP-Riden | ALI | AliExpress Choice: Shop1102642749 Store (Riden) | AliExpress Selection Shipping for Oversized Goods |  | 1 |  | 1.99 | 0 | 1.99 | https://www.aliexpress.us/item/3256806709143589.html | yes | Live for the RD6006 SKU.
SHIP-ALI-CHOICE | ALI | AliExpress Choice (combined order, several Choice sellers) | Choice combined shipping |  | 1 |  | 0 | 0 | 0 |  | no | Choice items ship together; assumes the order passes the free-shipping threshold (not confirmed for this account).
SHIP-ALI-US | ALI | AliExpress: STEPPERONLINE (US warehouse) / AliExpress: US-warehouse seller (filament) | US-warehouse ground |  | 1 |  | 0 | 0 | 0 |  | no | Assumed free (not confirmed).
SHIP-ALI-OTHER | ALI | AliExpress: other non-Choice CN sellers | Standard shipping, about 8 non-Choice CN stores |  | 1 |  | 60.0 | 0 | 60.0 |  | no | Estimate: about 7 stores x ~$4 + the steel enclosure (~8 kg) ~$30.
DUTY-ALI | ALI | AliExpress (import charges, non-Choice CN listings) | US import charges on non-Choice China listings |  | 1 |  | 117.11 | 117.11 | 0 |  | no | Basis: de minimis is suspended for all countries (CBP rule effective 2026-06-24). China goods pay MFN + Section 301 (Lists 1-3: 25%, 4A: 7.5%) + the 12.5% forced-labour Section 301 (since 2026-07-24), or Section 232 (50%) for steel/aluminium. AliExpress tags these listings PLATFORM_INCLUDED_TAX with its own per-item rate (taxRate 14.9-59% here); the estimate is that rate x line price. Choice and US-warehouse items show taxRate 0 (included or already imported). If your checkout shows them already included, this line is $0. Lines: FR5 59.0%x$15.29; PW11 37.5%x$3.00; CC3 37.5%x$1.20; CB1 50.0%x$26.00; CB2 50.0%x$13.50; CB4 42.8%x$5.40; CB5 42.8%x$5.40; CB6 42.8%x$2.94; CB9 14.9%x$15.00; L1 40.6%x$78.91; L2 40.6%x$32.00; D1 41.7%x$8.50; H2 37.5%x$6.50; H4 41.0%x$8.00; H7 23.7%x$2.50; H9 25.3%x$3.00; FX12 43.5%x$3.00; ST1 43.5%x$22.00; ST2 43.5%x$17.00; ST3 43.5%x$4.00; ST4 43.5%x$3.00; ST5 37.5%x$4.50
DUTY-ELECROW | AUTH | Elecrow | US import duty on the FluidNC board (if shipped DDU) |  | 1 |  | 19.7 | 19.7 | 0 |  | no | Estimate: HTS 8537.10 MFN 2.7% + Section 301 List 1 25% + 12.5% = 40.2% x $49. A carrier brokerage fee may be added.
TAX-ESTIMATE | ALL | All sellers (state unknown) | US sales tax estimate |  | 1 |  | 95.21 | 95.21 | 0 |  | no | Range $0 (DE, MT, NH, OR, AK) to $136.02 (about 10% combined state+local) on $1360.21 of goods + shipping. The line uses a 7% midpoint. Marketplaces (AliExpress) and Digi-Key/TRC collect it at checkout where required.
