andres/wingcut-fluidnc/enclosure/stl/case4x_lid.stl

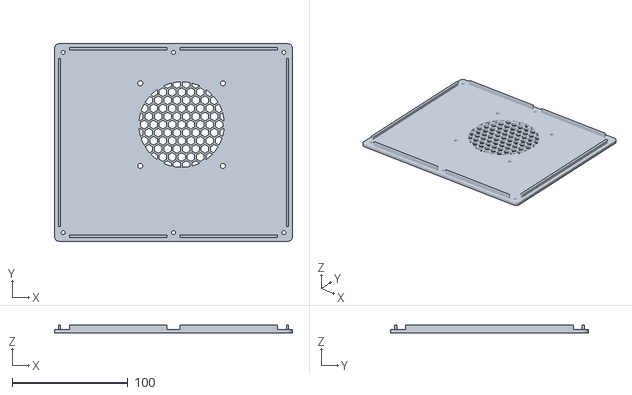
[picture p6: CAD file, 2026-11-05]
enclosure/stl/case4x_lid.stl
206.0 x 171.0 x 7.00
