andres/wingcut-fluidnc/enclosure/stl/case6x_base.stl

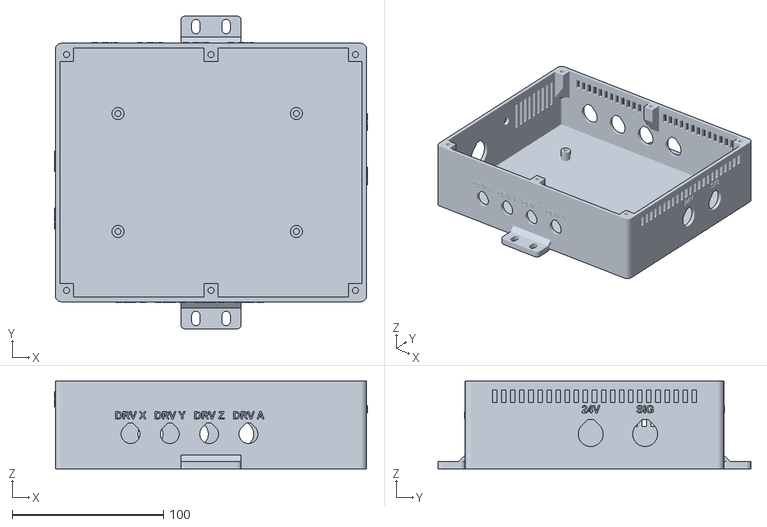
[picture p7: CAD file, 2026-11-05]
enclosure/stl/case6x_base.stl
207.2 x 207.0 x 58.0
