andres/wingcut-fluidnc/enclosure/stl/rack_cover.stl

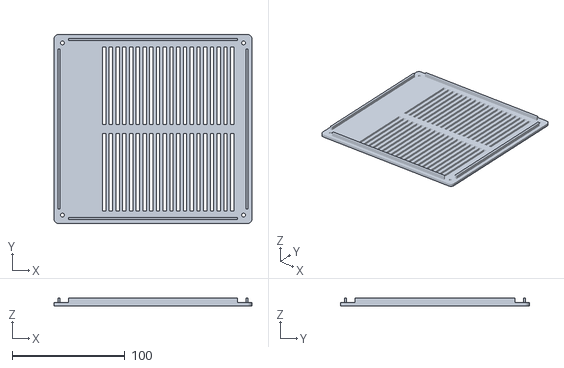
[picture p8: CAD file, 2026-11-05]
enclosure/stl/rack_cover.stl
176.0 x 168.0 x 7.00
