andres/wingcut-fluidnc/enclosure/stl/rack_base.stl

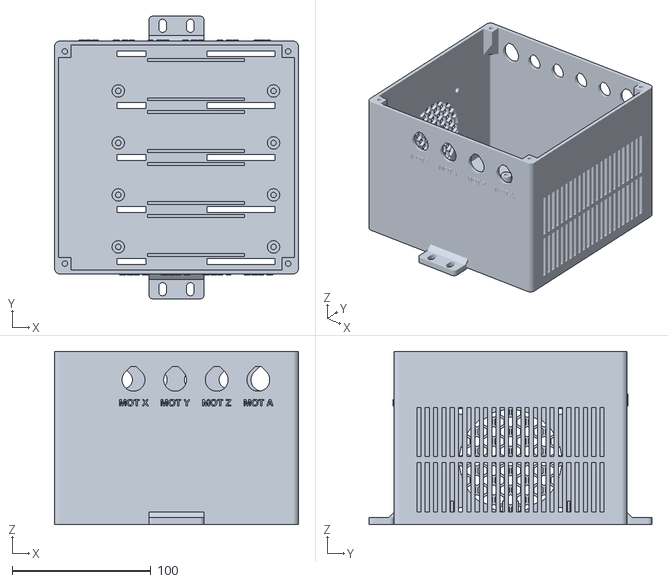
[picture p9: CAD file, 2026-11-05]
enclosure/stl/rack_base.stl
176.0 x 204.0 x 125.0
