andres/wingcut-fluidnc/(list of files, cad)

Other CAD files:
enclosure/stl/case6x_lid.stl
enclosure/stl/case4x_base.stl
