andres/wingcut-fluidnc/enclosure/png/rack_assembly.png

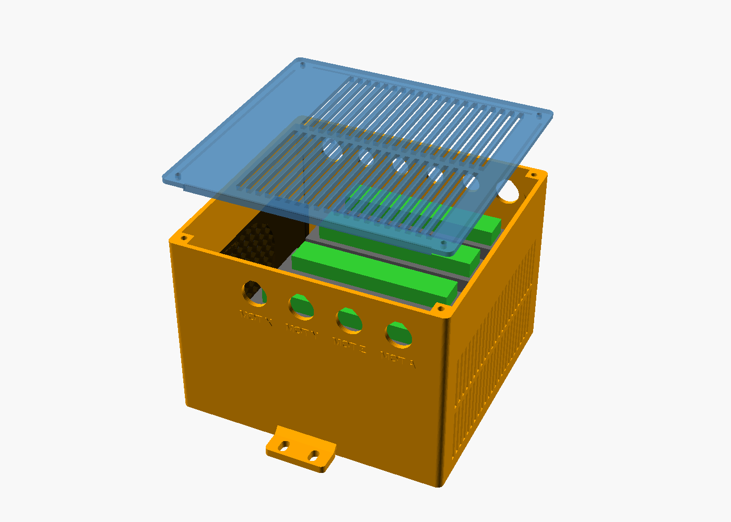
enclosure/png/rack_assembly.png
