andres/wingcut-fluidnc/enclosure/png/rack_assembly_back.png

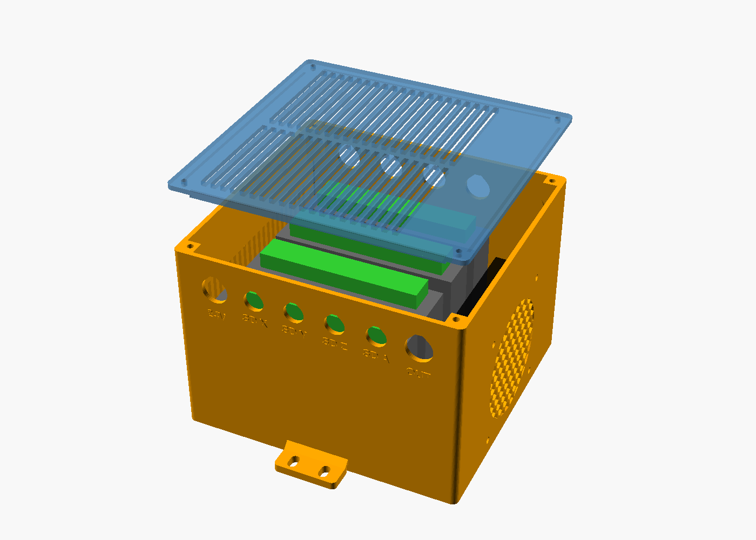
enclosure/png/rack_assembly_back.png
