andres/wingcut-fluidnc/(commit log)

2026-11-05 Initial release: BOM, wiring, assembly, FluidNC configs (4x and 6x), wingcut machine.toml, printable enclosures
    [bom.csv, case4x_base.stl, case4x_lid.stl, case6x_base.stl, case6x_lid.stl, controller_case_4x.scad, controller_case_6x.scad, dm542t_rack.scad]
2026-11-08 BOM: two verified US buy links per line (quality + budget), recommended pick, real US cost totals
    [bom.csv]
2026-11-08 Riden RD6006 standard; real US cart for variant A (authorised + AliExpress, shipping, duty, tax); BOM regenerated
    [bom.csv, cart-variant-A.csv, fluidnc-4x-hotwire.yaml, fluidnc-6x-hotwire.yaml]
